chazlambo/Omnimagnet/Code/Tractor Beam/output/calibration_test/frame_4.png

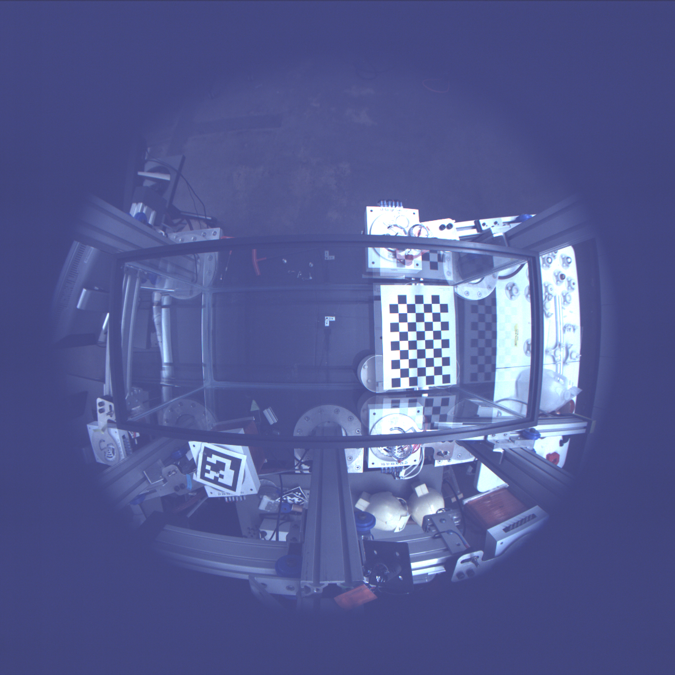
Code/Tractor Beam/output/calibration_test/frame_4.png
