chazlambo/Omnimagnet/Code/Tractor Beam/output/calibration_test/frame_8.png

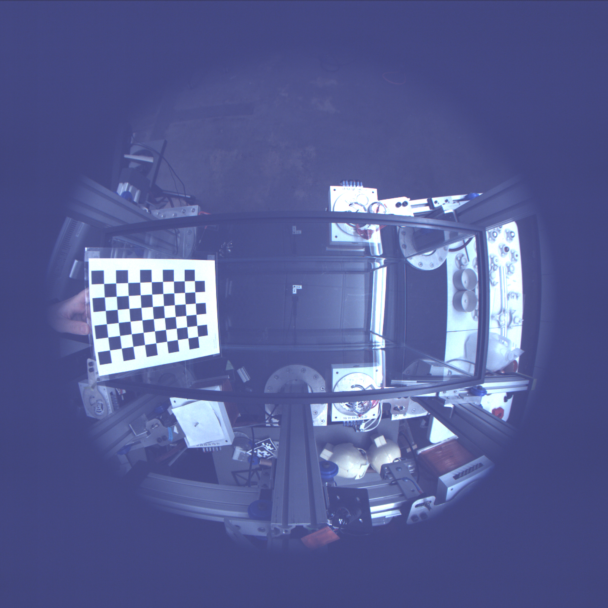
Code/Tractor Beam/output/calibration_test/frame_8.png
