chazlambo/Omnimagnet/Solidworks/Wire Box/Classical Controls - HW3 Full.pdf

•

~M- | l~w 3- P n,htu,,

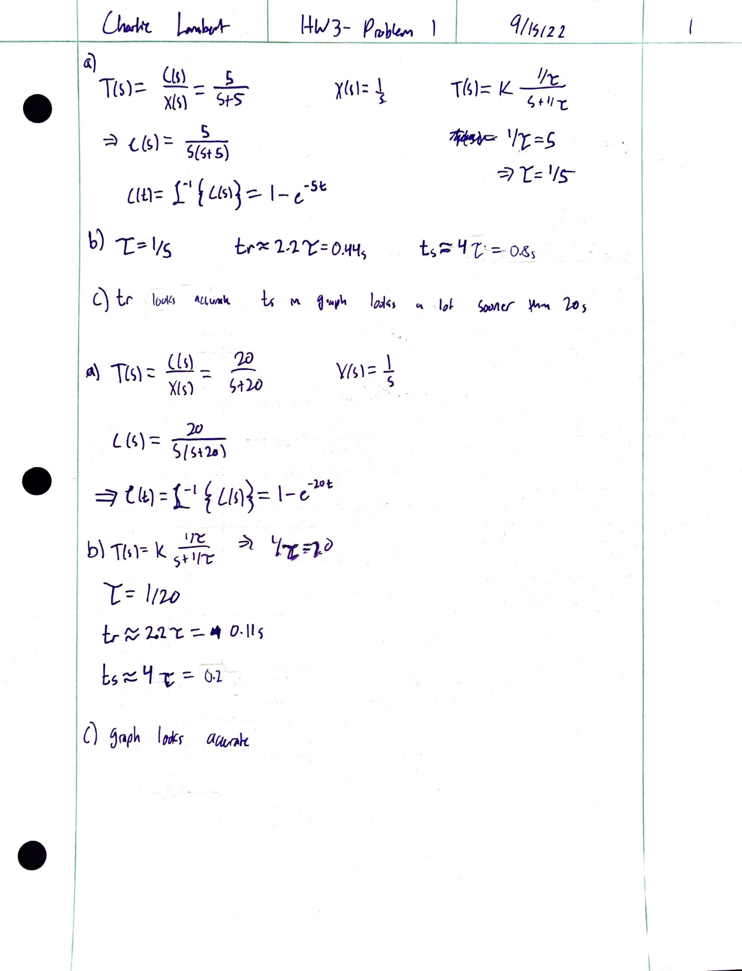
[picture p3: page 1]

•

•

dJ | _ Lls) | s
Tl~) - i) :: St-5 | X(<I= l

ll~) -=- S{tb)

l(l.1-:: f' f Us\)-::.- I - l.-St

b) 1: 1/5 | c"-x 1.i = o.~'is
b\ 1l\)~ k s;1i~ | LL~ ~7);

### 1:= ltio

# vr~,-; l . s

q;,~/2 2.

1(1)== IL I/:

f- / T.,

## l/r=-f>

.;J T= 1
/s-

I

\

•

## A5~v/Ylt:

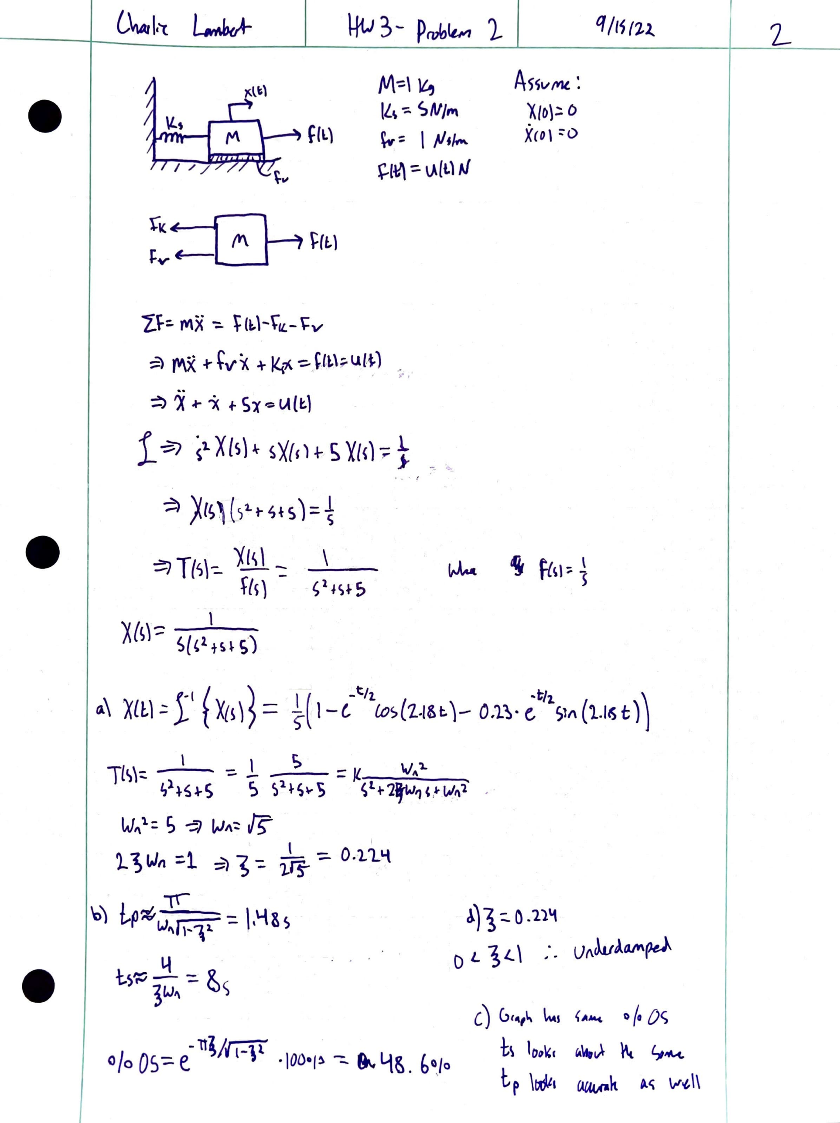
[picture p4: page 2]

•

•

\.fW 3 - p rJ,!t.v, 1 | q /(', {'},J..

f(l)

Z,f-:. rvlX -:::. (1:.\-flL - ~v

M-:;\ it,
IL-.-::. SftlJtrt
I J./t~
~M v\lt.) ,i

::) MX -r tvi + -=-JO.\;.uti) ·;.,

'X ... i f Sx-=tA{t)

## f_~ s1.Xls)"" sX/,)+-~Yl~)-;::~

# )c~, h2.+-4is)=¾

Tls\-:. ):'Jil_-:: -'--
fl~) ~¹ 1Si$

'X{b\.::.O

### Xco\ =o

lo) l,.p~..,:,. ::: \,'-l&s | ~)1=- 0.11'1
QL 3L..\ . u (\Li J..o.ft\pJ,-. . . 4 | . t~'i=i-::. 3w"
CJ G, .. ,~ ~I | { AM.4, | o/a Os
0 /o os-=:. e.-1t~/fi-V, . 100•1~ -:. 9', Lt~. l,a)o | t\ lo""' <-\ft~ \\
l p ,~, ~k ~" \,,r,t\\

q/,s/21

# - 1ls):: \~-,~s

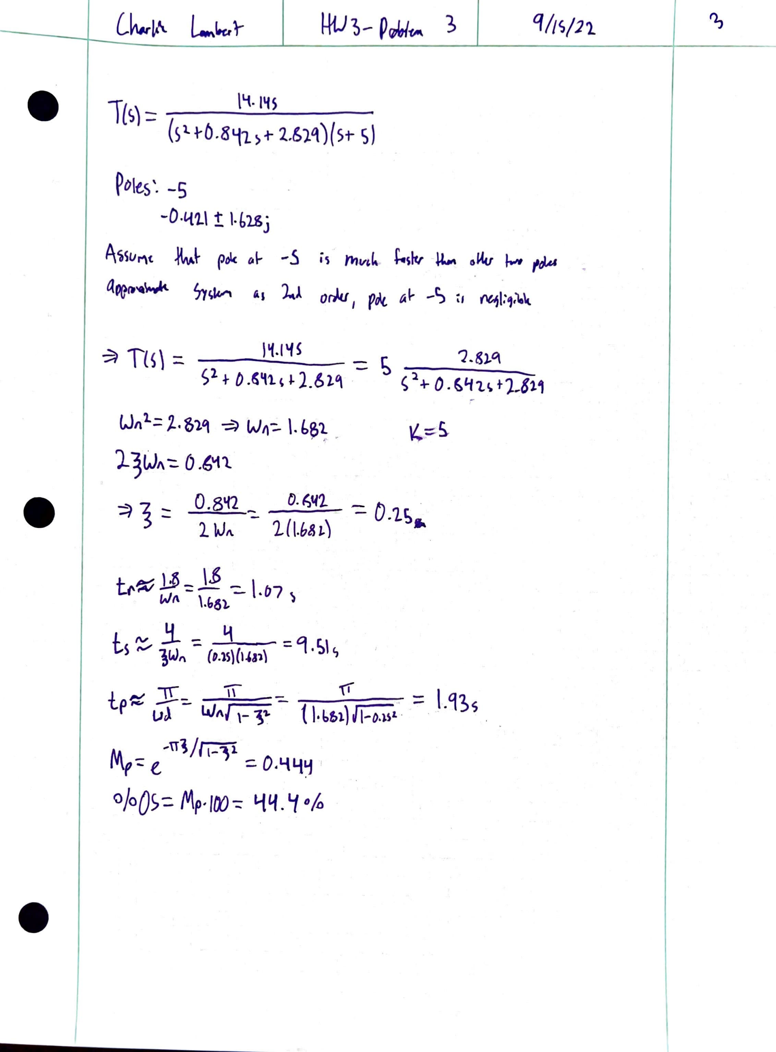
[picture p5: page 3]

## (stt6.8~1>+ 2.6l't)(St- 5)

Pble.s '. -5

### -0-ttt\ ! His j

A.~~111"'\t | ,ltv.~ pok oi. -5 i~ t'tlv,~ ~sit, | oUu- | ,

ttrie,.,.~ S-,~ ,, ~l orkr, ph tAi. -S ,, t"e,jl:1:i.1.c.

## Wn¹

=J..fil.'l :=:>W/\-:..\.l,~~ . | ~ :::: ~
13W"-::. o .~'11.
- _, | - 0. 8'f2 - | o. 1,1.1'1. | 0
-, 3 - l lJI\ - 1(1.b.sz.) -:: .
1;._
l rv | - | L\ | - 4 SI S t-./ JW" - (us)(1"a1\ - · "
-n- | " | \a t.p~ er=- WAJ ,- ,,. -=- { l•b6i)J1-o.i~~·. = ·. l~S .
M. | ,U1/l,--,1 l''f-= l | :::: 0,LtL{~

0 /oOS-= Mp -/riJ-= &.-('LL[ ⁰ /4
•

•

t,('.:: 0.03 ::- 2.17:::

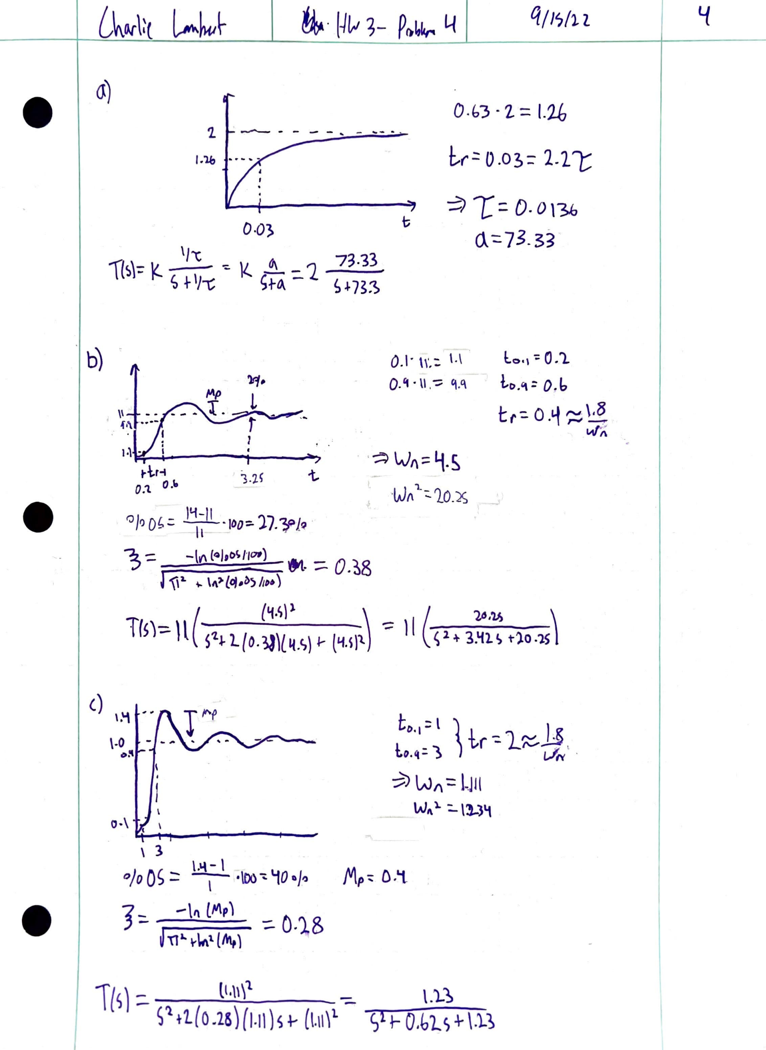
[picture p6: page 4]

b)
•

•

2. -- - - - - - - ~- •

O.f,3 · 2=1.U

0-03>
' J--c | 73,33
1}>\'= \l. ~} 'J--c K | -=..1 .q~~

\\ . .f•\ •

J,l • i
1-\.r-1
0.1. O.lo

/A

0 /oo~ :: l~~ll ·100 ::. 17.";fl?

3 :::: -l(I (4J,0H10,) | ~ - :::. 0 -18
f 'fi i. | \I\> £oj.b:, /11•)

I

I
0•\ I

t

T = 0 -D\3,6

### ct_ ::: 7~_33

O. 1 • ,,·.:. \.\ | lo,, -== 0. 'l.
0.'1 · \1 ,-::;; Cl,(\ | Lo ."1 = o.b

## tr ~ o.~

v,/'f.

t0•1== l) | - · r,.,~

### lo,tt= 1 ) tr -l""' t.-1,v' ·

## -:3> W" ::: l.JJI

W" l. :.. \3-3'1

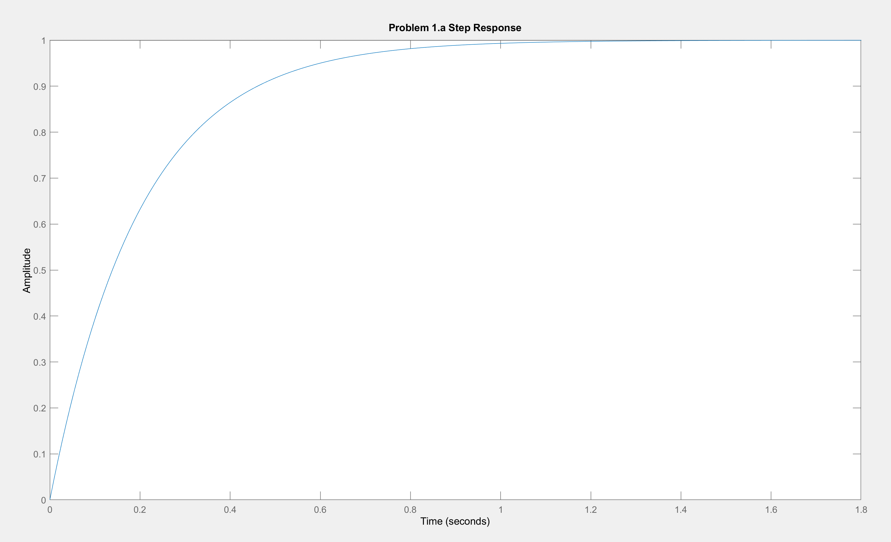
[picture p7: page 5]
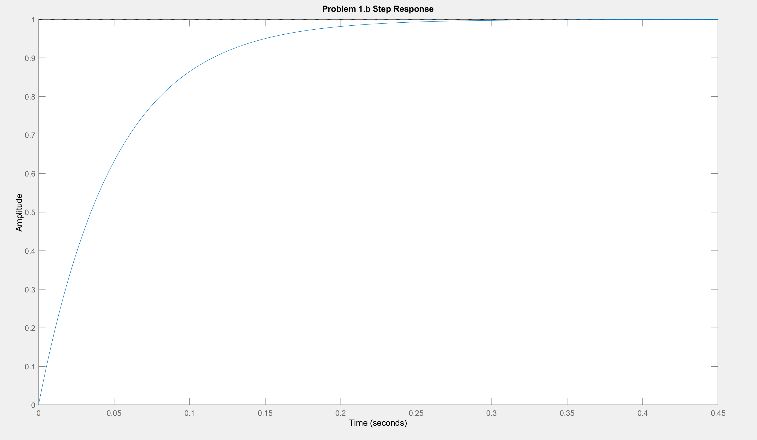
[picture p8: page 6]
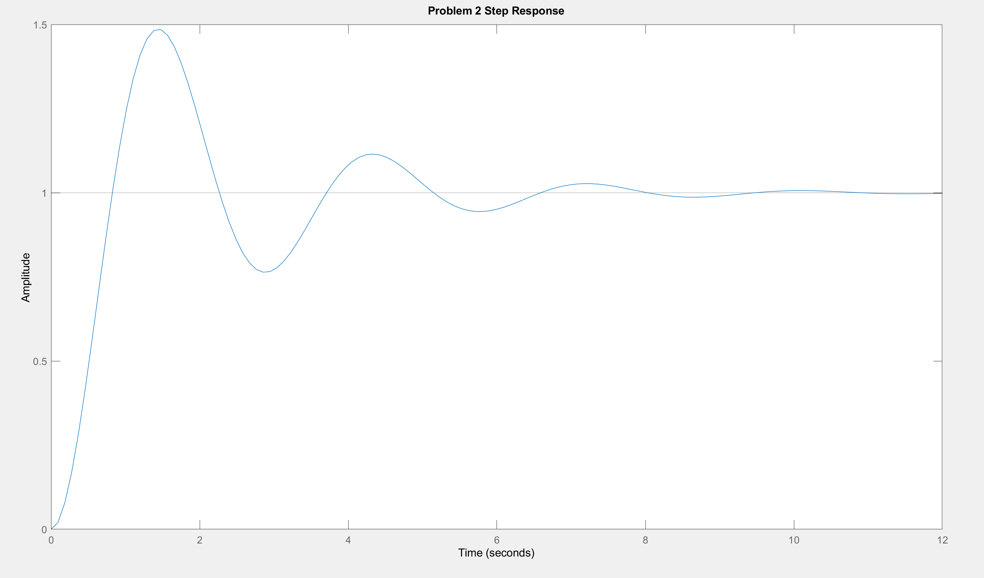
[picture p9: page 7]
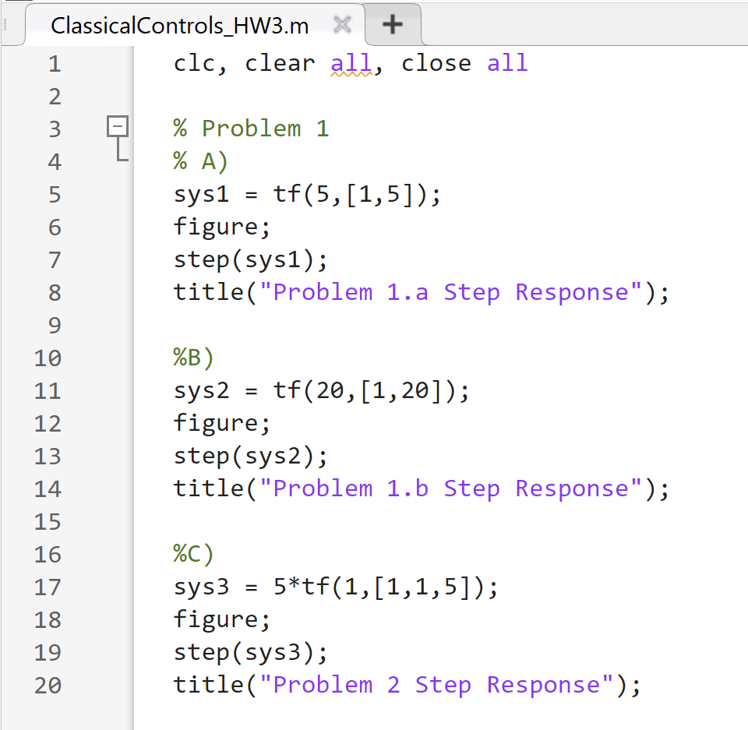
[picture p10: page 8]
