chazlambo/Omnimagnet/Documentation/Forward Kinematics/Arm to Table Axes.jpg

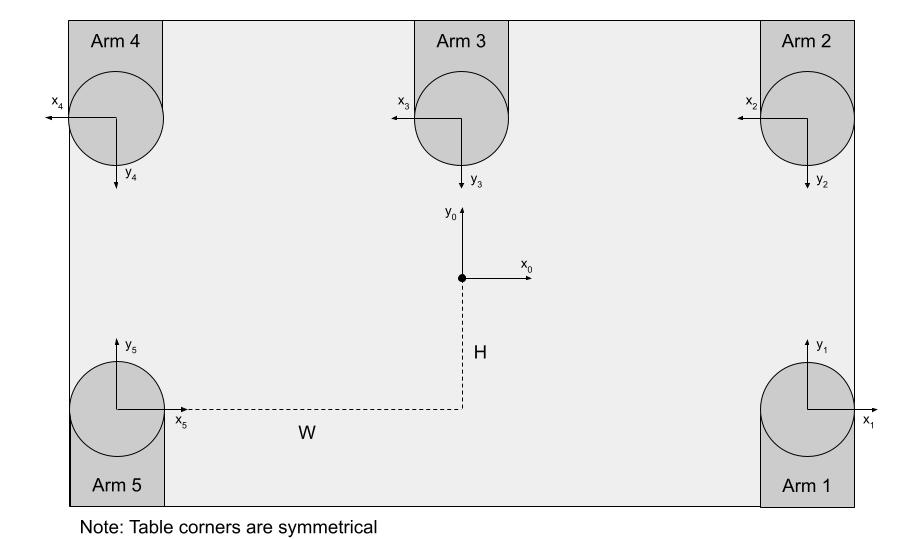
Documentation/Forward Kinematics/Arm to Table Axes.jpg
