chazlambo/Omnimagnet/Documentation/Forward Kinematics/Omnimagnet Arm DH Parameters.jpg

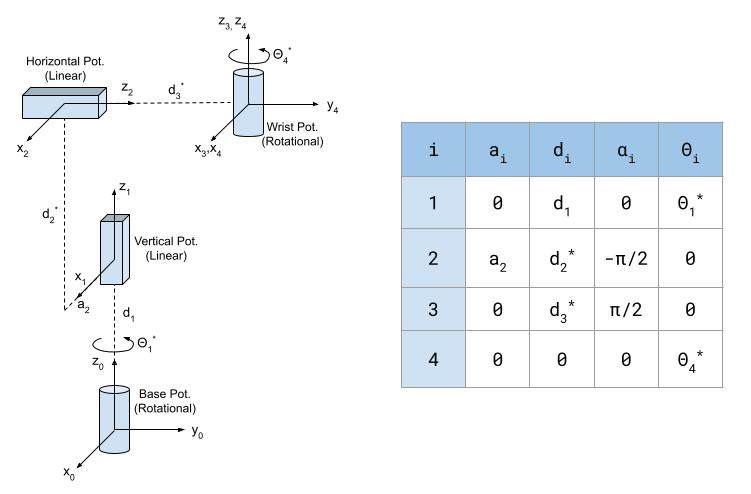
Documentation/Forward Kinematics/Omnimagnet Arm DH Parameters.jpg
