chazlambo/Omnimagnet/Documentation/Wiring-Pin Tables/I2C Bus Overview.jpg

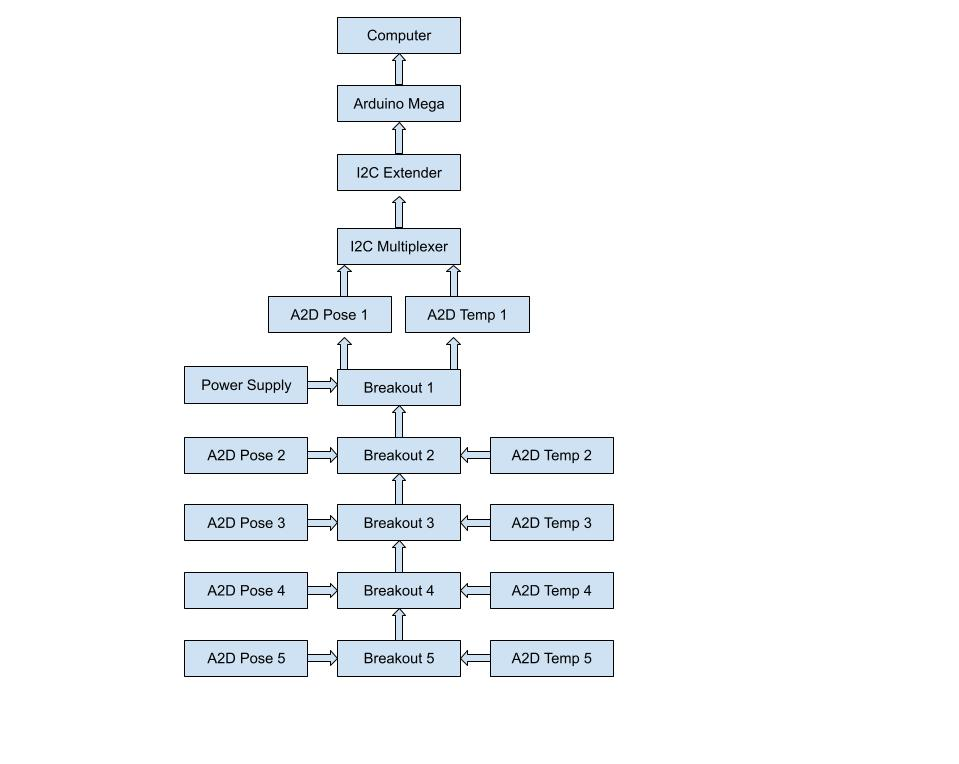
Documentation/Wiring-Pin Tables/I2C Bus Overview.jpg
