chazlambo/Omnimagnet/Documentation/Hardware/Parts List.xlsx

Boards
Part | Model
Microcontroller | Arduino Mega
I2C Extender | Adafruit LTC4311
I2C Multiplexer | Adafruit TCA9548A
A2D Module | Adafruit PCF8591
Breakout Board | MDFLY RJ45
Dual Breakout Board | MDFLY DUAL RJ45
Parts
Potentiometer Timing Pulley | https://www.robotshop.com/en/makeblock-32-tooth-timing-pulleys-2pk.html | 2
Omnimagnet Timing Pulley | https://www.mcmaster.com/1375K21/ | 3
Timing Belt | https://www.mcmaster.com/7887K214/ | 2
