chazlambo/Omnimagnet/Solidworks/Tank Setup/Aligner Assembly.SLDASM

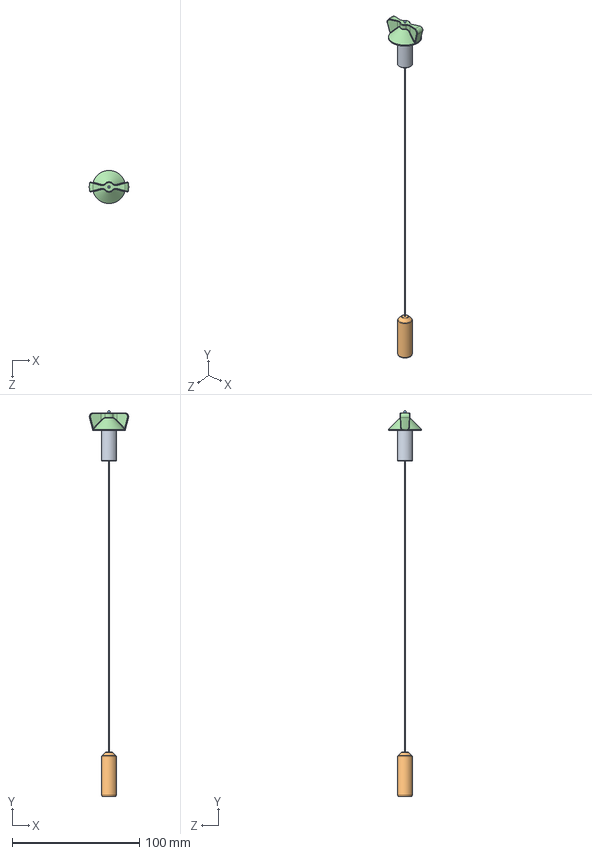
[picture p14: CAD file, 2025-10-20]
Solidworks/Tank Setup/Aligner Assembly.SLDASM
31.1 x 303.9 x 26.0 mm
Raft Aligner Top Peg
Aligner String
Raft Aligner Bottom Peg
Raft Aligner Middle Peg
