chazlambo/Omnimagnet/Solidworks/Tank Setup/Tank Full Setup.SLDASM

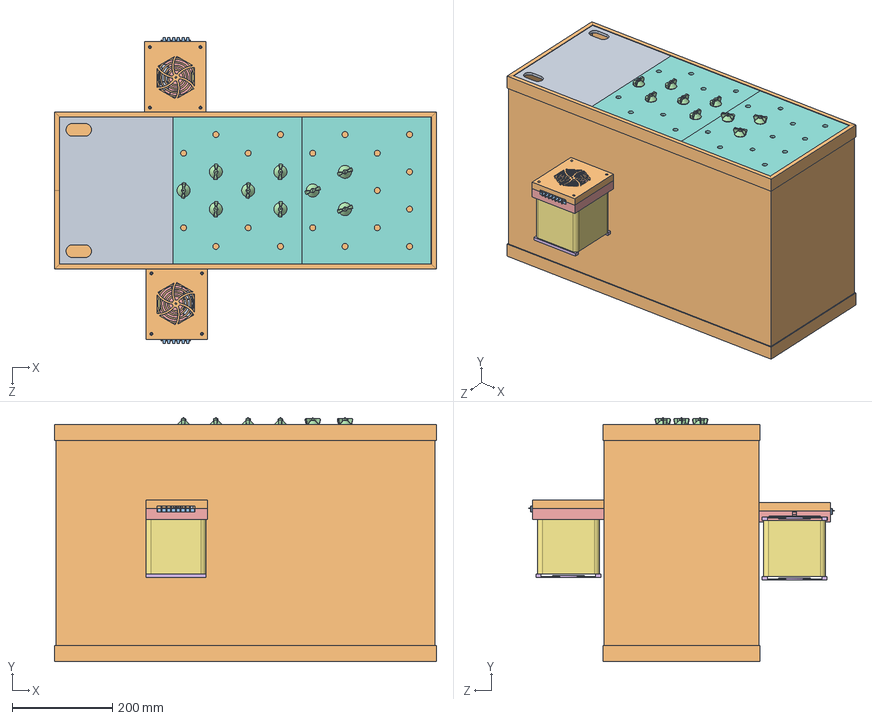
[picture p15: CAD file, 2025-10-20]
Solidworks/Tank Setup/Tank Full Setup.SLDASM
763.1 x 487.9 x 611.8 mm
Water Tank
Acrylic Cover - Left
Acrylic Cover - Middle
Universal Raft x 3
Raft Ball Holder x 3
Ball x 3
Raft Aligner Top Peg x 9
Aligner String x 9
Raft Aligner Bottom Peg x 9
Raft Aligner Middle Peg x 9
Acrylic Cover - Right
Magnet x 2
Bracket x 4
Bottom Box x 2
Port x 2
Power Port x 2
Top Box x 2
Amp x 6
