chazlambo/Omnimagnet/Solidworks/Wire Box/Assembly.SLDASM

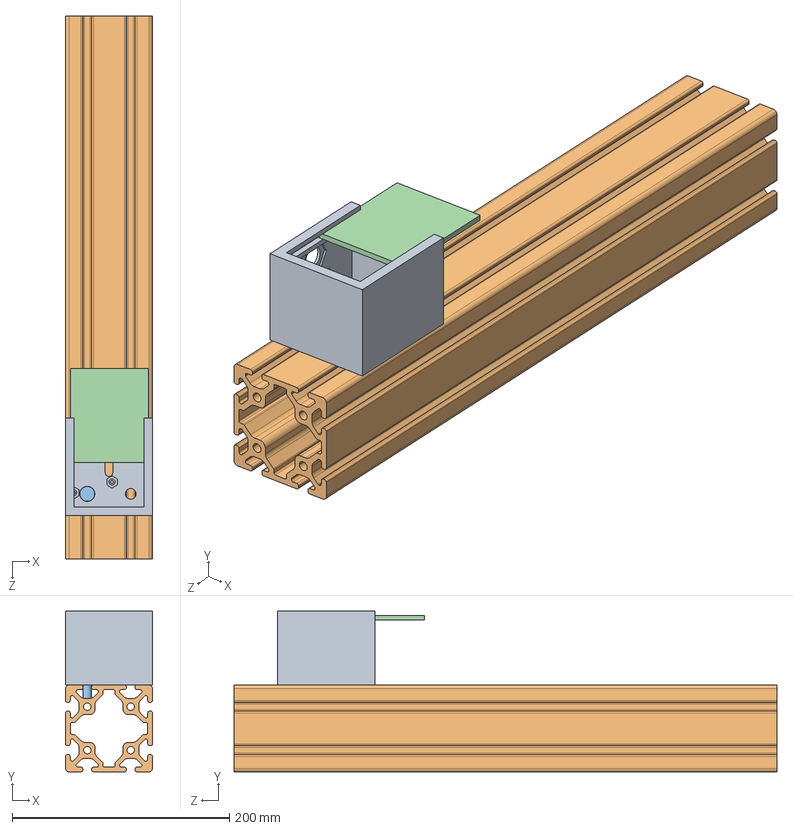
[picture p16: CAD file, 2025-04-09]
Solidworks/Wire Box/Assembly.SLDASM
80.0 x 148.0 x 500.0 mm
Wire Box
Frame
Screw x 2
Sliding Door
