chazlambo/Omnimagnet/Solidworks/Master Box/Assembly.SLDASM

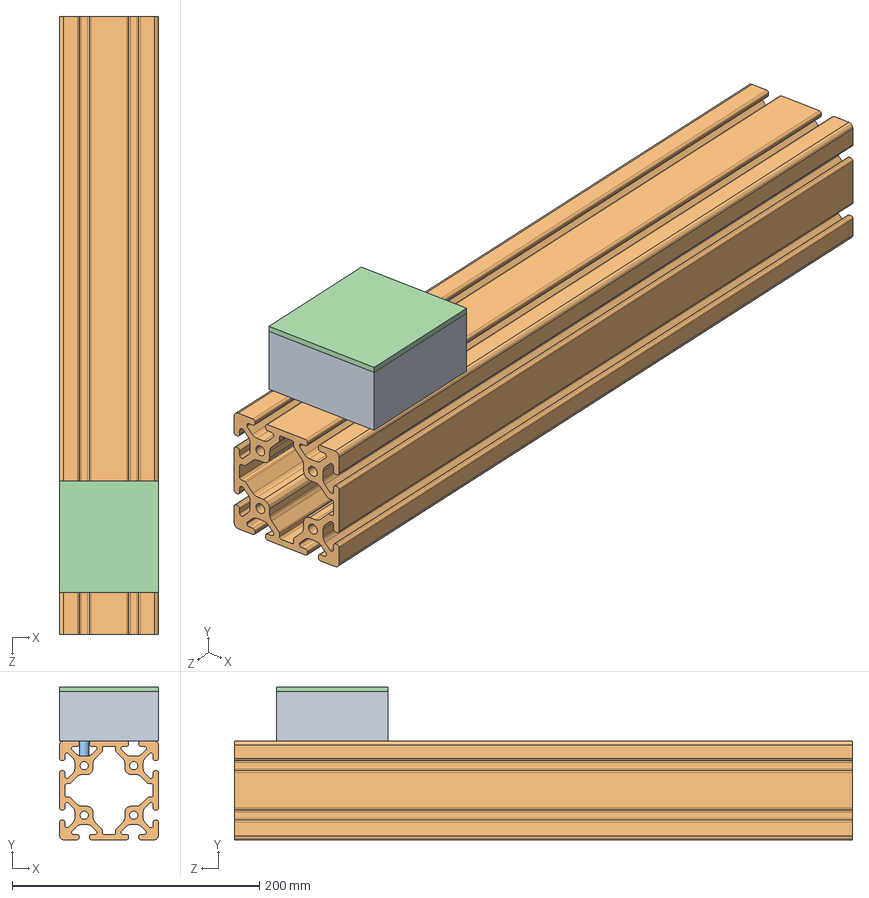
[picture p17: CAD file, 2025-04-09]
Solidworks/Master Box/Assembly.SLDASM
80.0 x 123.5 x 500.0 mm
Circuit Box
Frame
Screw x 2
Lid
