chazlambo/Omnimagnet/Solidworks/Omni Arduino Box/Omni Arduino Box Assembly.SLDASM

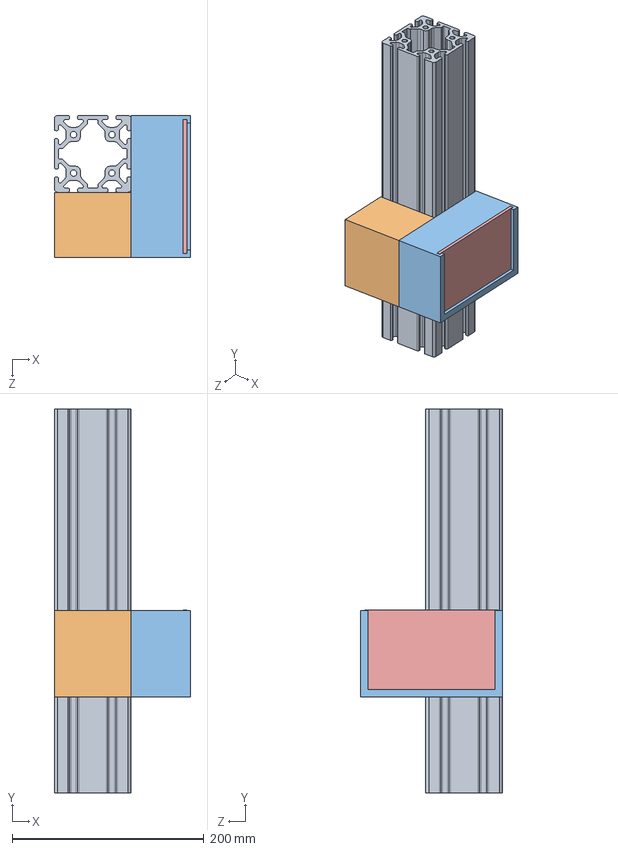
[picture p18: CAD file, 2025-04-09]
Solidworks/Omni Arduino Box/Omni Arduino Box Assembly.SLDASM
142.0 x 400.0 x 148.0 mm
40_8080_400_CL2
Old Wirebox
Arduino Box
ArduinoMega
Arduino Box Slide
