chazlambo/Omnimagnet/Solidworks/Omnimagnet Box/Omnimagnet Assembly.SLDASM

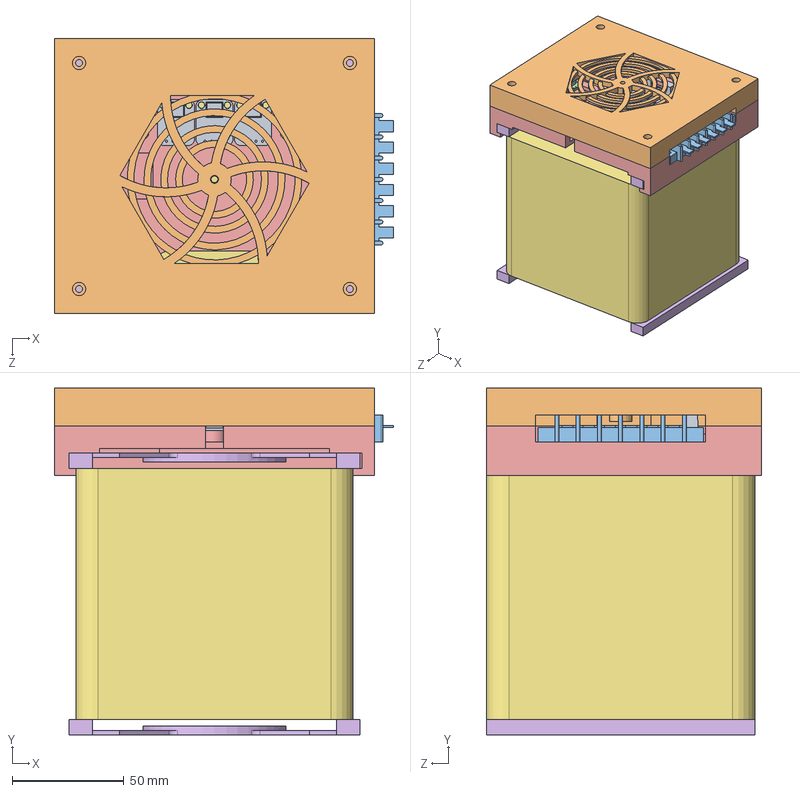
[picture p19: CAD file, 2025-07-17]
Solidworks/Omnimagnet Box/Omnimagnet Assembly.SLDASM
151.5 x 155.0 x 123.0 mm
Magnet
Bracket x 2
Bottom Box
Port
Power Port
Top Box
Amp x 3
