chazlambo/Omnimagnet/Solidworks/Tank Setup/Raft Assembly.SLDASM

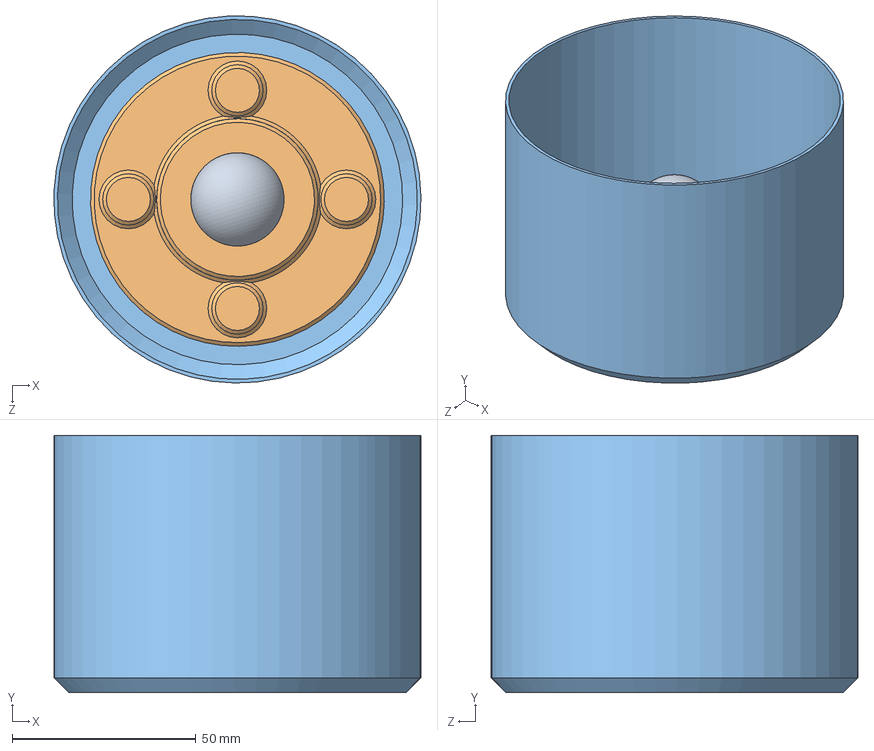
[picture p20: CAD file, 2025-07-17]
Solidworks/Tank Setup/Raft Assembly.SLDASM
99.9 x 70.0 x 99.9 mm
Universal Raft
Raft Ball Holder
Ball
