chazlambo/Omnimagnet/Solidworks/Master Box/Master Box 2.SLDPRT

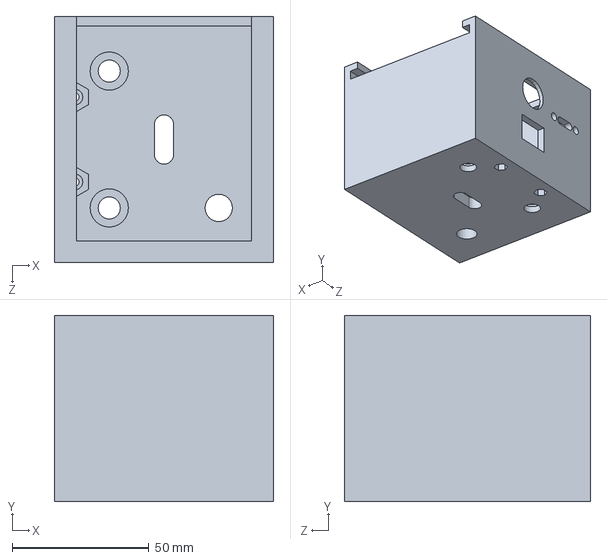
[picture p21: CAD file, 2025-04-09]
Solidworks/Master Box/Master Box 2.SLDPRT
80.0 x 68.0 x 90.0 mm
