chazlambo/Omnimagnet/Solidworks/Omni Arduino Box/40_8080_400_CL2.SLDPRT

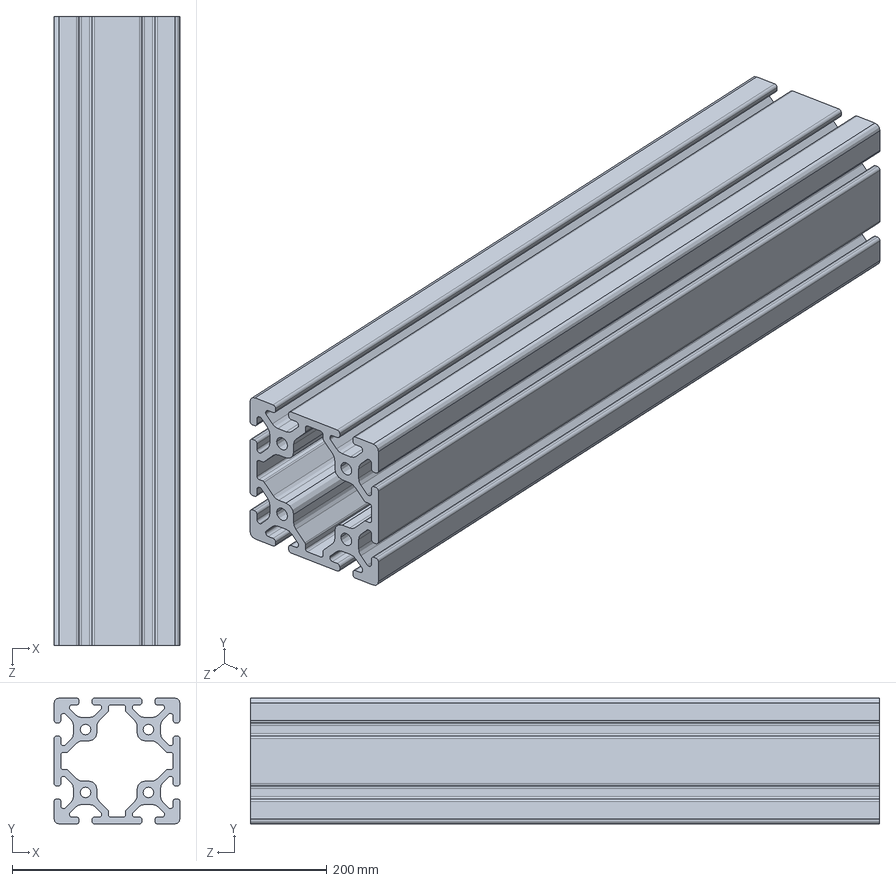
[picture p22: CAD file, 2025-04-09]
Solidworks/Omni Arduino Box/40_8080_400_CL2.SLDPRT
80.0 x 80.0 x 400.0 mm
