chazlambo/Omnimagnet/Solidworks/Omnimagnet Box/Amp.SLDPRT

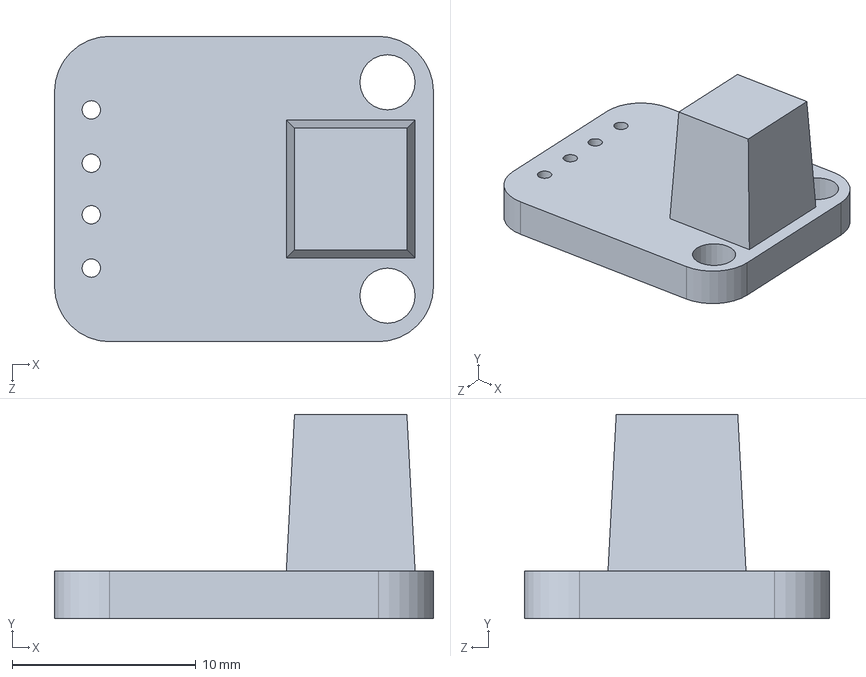
[picture p23: CAD file, 2025-07-17]
Solidworks/Omnimagnet Box/Amp.SLDPRT
20.6 x 11.1 x 16.6 mm
