chazlambo/Omnimagnet/Solidworks/Tank Setup/STLs/Raft Print.3mf

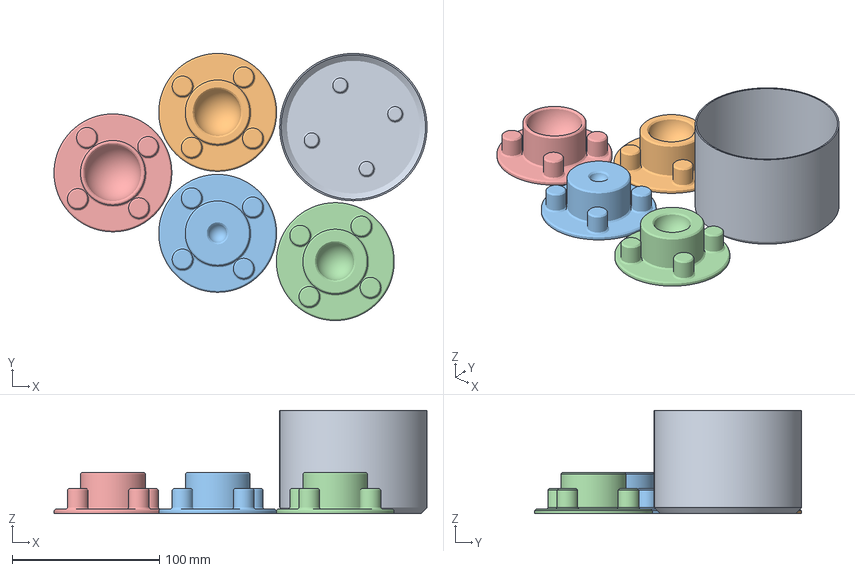
[picture p24: CAD file, 2025-07-17]
Solidworks/Tank Setup/STLs/Raft Print.3mf
253.3 x 181.3 x 70.0 mm
Universal Raft.STL
Raft Ball Holder (1.25in).STL
Raft Ball Holder (0.5in).STL
Raft Ball Holder (1 in).STL
Raft Ball Holder (1.5in).STL
