chazlambo/Omnimagnet/Solidworks/Master Box/Frame.sldprt

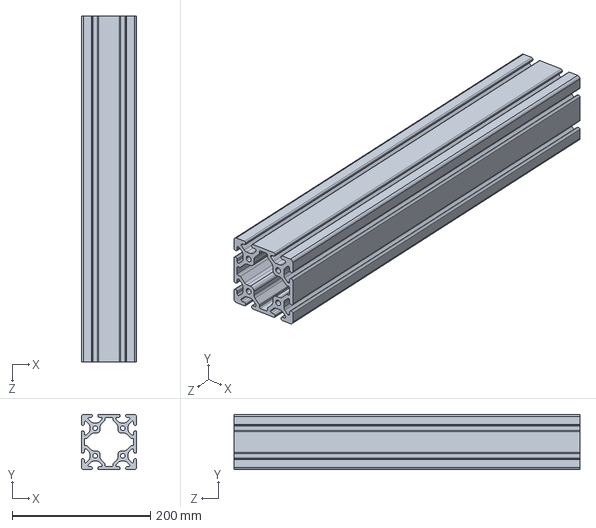
[picture p25: CAD file, 2025-04-09]
Solidworks/Master Box/Frame.sldprt
80.0 x 80.0 x 500.0 mm
