chazlambo/Omnimagnet/Solidworks/Omni Arduino Box/Arduino Box Slide.SLDPRT

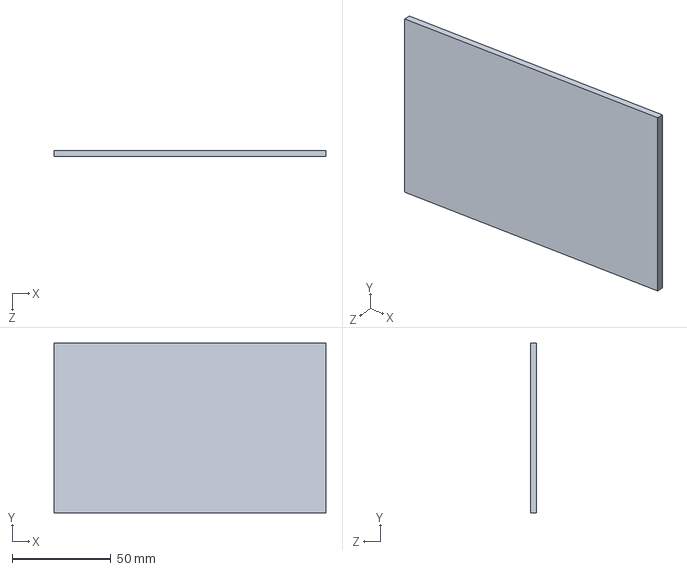
[picture p26: CAD file, 2025-04-09]
Solidworks/Omni Arduino Box/Arduino Box Slide.SLDPRT
138.0 x 86.0 x 3.20 mm
