chazlambo/Omnimagnet/Solidworks/Omnimagnet Box/Power Port.SLDPRT

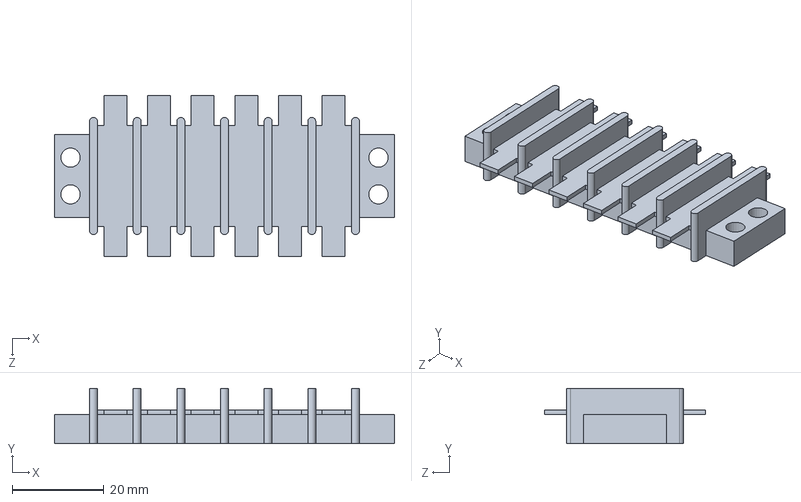
[picture p27: CAD file, 2025-07-17]
Solidworks/Omnimagnet Box/Power Port.SLDPRT
74.0 x 12.0 x 35.0 mm
