chazlambo/Omnimagnet/Solidworks/Omnimagnet Box/Bracket.SLDPRT

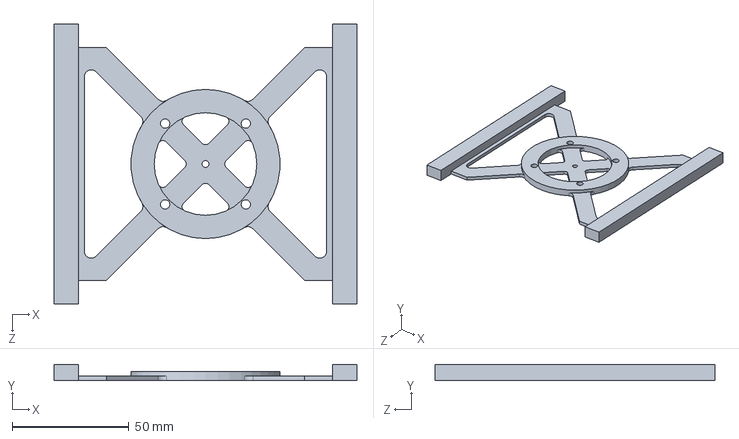
[picture p28: CAD file, 2025-07-17]
Solidworks/Omnimagnet Box/Bracket.SLDPRT
130.0 x 7.00 x 120.0 mm
