chazlambo/Omnimagnet/Solidworks/Tank Setup/Raft Aligner Spacer.SLDPRT

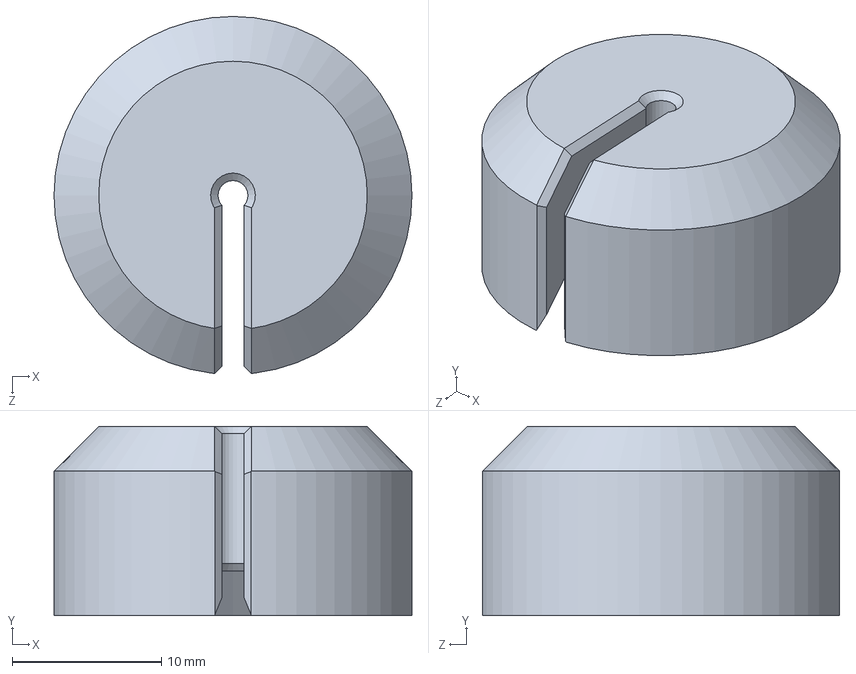
[picture p29: CAD file, 2025-10-14]
Solidworks/Tank Setup/Raft Aligner Spacer.SLDPRT
24.0 x 12.7 x 23.9 mm
