chazlambo/Omnimagnet/Solidworks/Wire Box/Sliding Door.SLDPRT

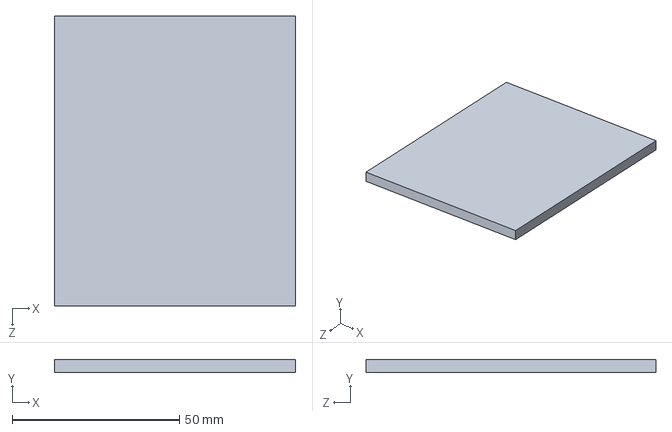
[picture p30: CAD file, 2025-04-09]
Solidworks/Wire Box/Sliding Door.SLDPRT
72.0 x 4.00 x 86.5 mm
