chazlambo/Omnimagnet/Solidworks/Master Box/Master Box.SLDPRT

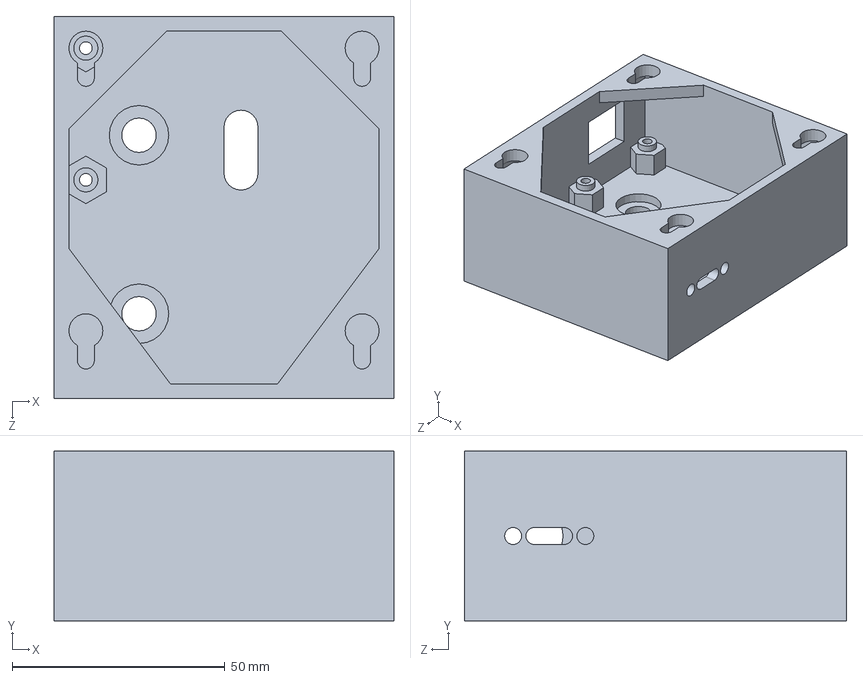
[picture p31: CAD file, 2025-04-09]
Solidworks/Master Box/Master Box.SLDPRT
80.0 x 40.0 x 90.0 mm
