chazlambo/Omnimagnet/Solidworks/Omni Arduino Box/ArduinoMega.SLDPRT

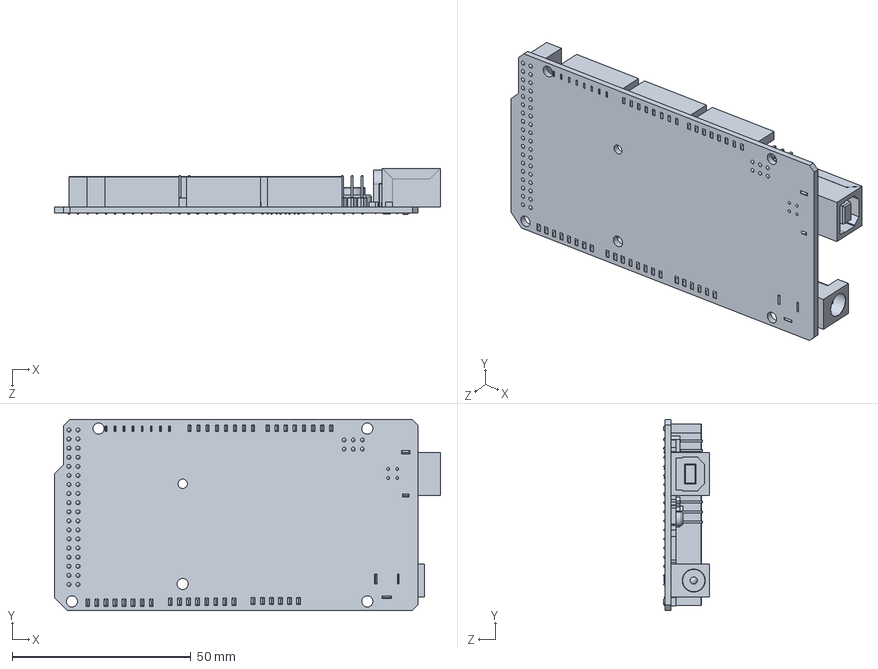
[picture p32: CAD file, 2025-04-09]
Solidworks/Omni Arduino Box/ArduinoMega.SLDPRT
107.9 x 53.4 x 13.0 mm
