chazlambo/Omnimagnet/Solidworks/Omnimagnet Box/Magnet.SLDPRT

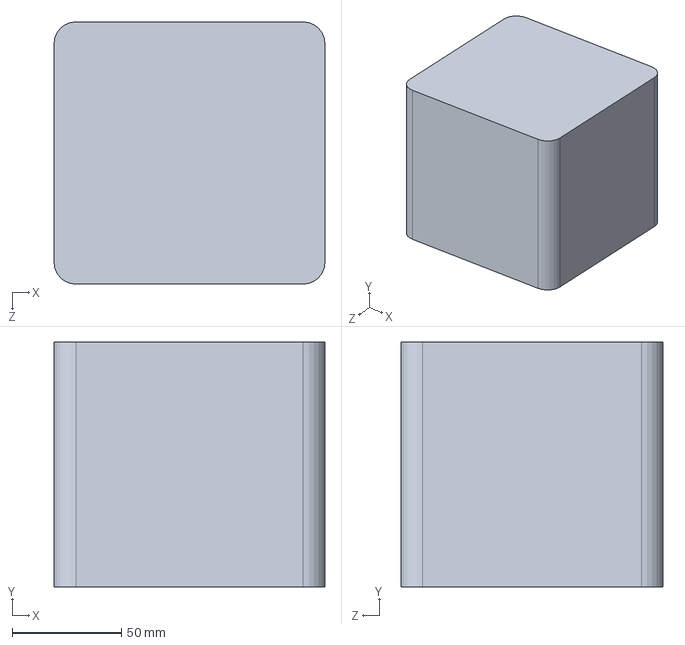
[picture p33: CAD file, 2025-07-17]
Solidworks/Omnimagnet Box/Magnet.SLDPRT
124.0 x 112.0 x 120.0 mm
