chazlambo/Omnimagnet/Solidworks/Tank Setup/Raft Aligner Bottom Peg.SLDPRT

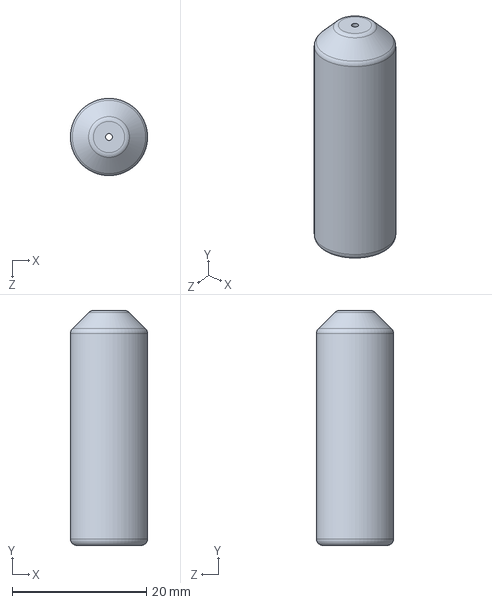
[picture p34: CAD file, 2025-09-15]
Solidworks/Tank Setup/Raft Aligner Bottom Peg.SLDPRT
11.5 x 35.0 x 11.5 mm
