chazlambo/Omnimagnet/Solidworks/Wire Box/Wire Box.SLDPRT

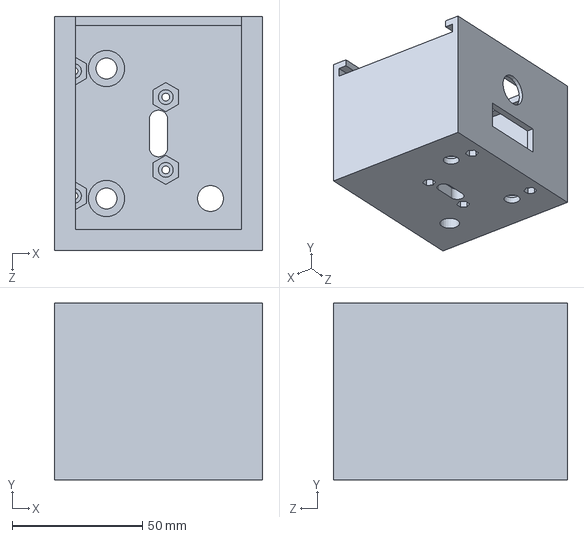
[picture p35: CAD file, 2025-04-09]
Solidworks/Wire Box/Wire Box.SLDPRT
80.0 x 68.0 x 90.0 mm
