chazlambo/Omnimagnet/Solidworks/Tank Setup/Acrylic Cover - Right.SLDPRT

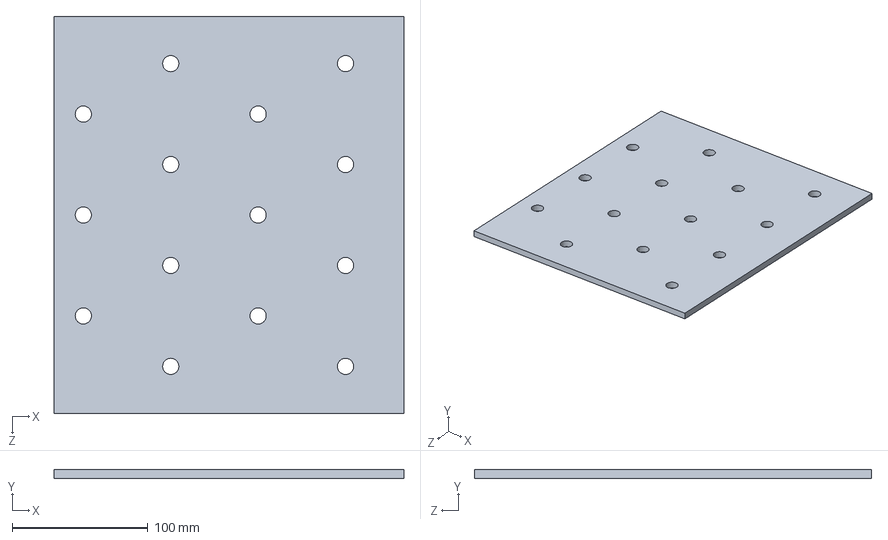
[picture p36: CAD file, 2025-09-15]
Solidworks/Tank Setup/Acrylic Cover - Right.SLDPRT
258.0 x 6.35 x 293.0 mm
