chazlambo/Omnimagnet/Solidworks/Master Box/Lid.SLDPRT

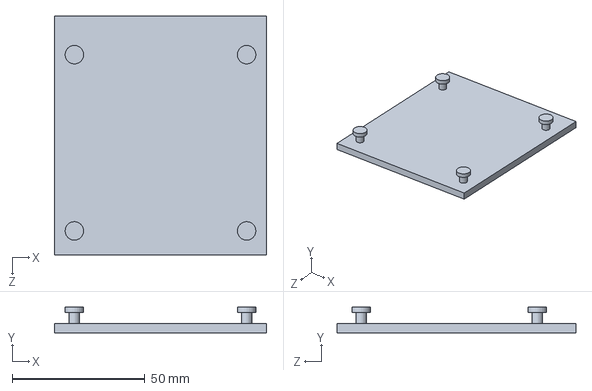
[picture p37: CAD file, 2025-04-09]
Solidworks/Master Box/Lid.SLDPRT
80.0 x 9.70 x 90.0 mm
