chazlambo/Omnimagnet/Solidworks/Omni Arduino Box/Arduino Box.SLDPRT

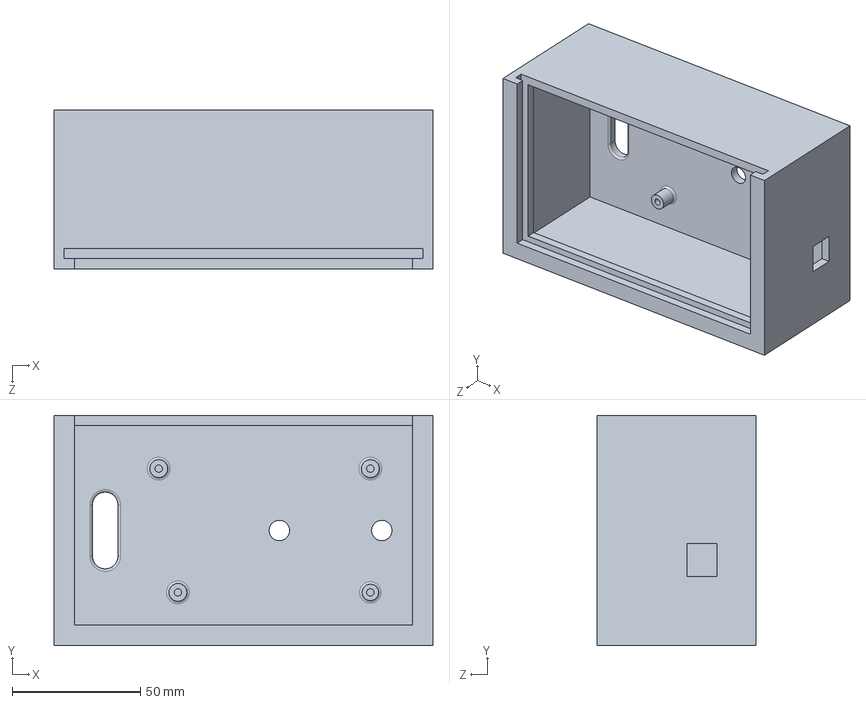
[picture p38: CAD file, 2025-04-09]
Solidworks/Omni Arduino Box/Arduino Box.SLDPRT
148.0 x 90.0 x 62.0 mm
