chazlambo/Omnimagnet/Solidworks/Omnimagnet Box/Top Box.SLDPRT

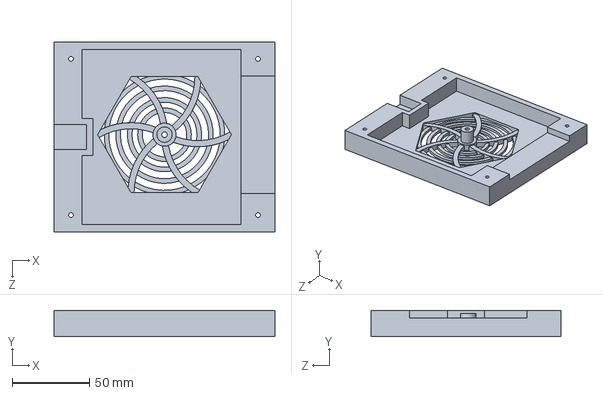
[picture p39: CAD file, 2025-07-17]
Solidworks/Omnimagnet Box/Top Box.SLDPRT
143.0 x 17.0 x 123.0 mm
