chazlambo/Omnimagnet/Solidworks/Omnimagnet Box/Bottom Box.SLDPRT

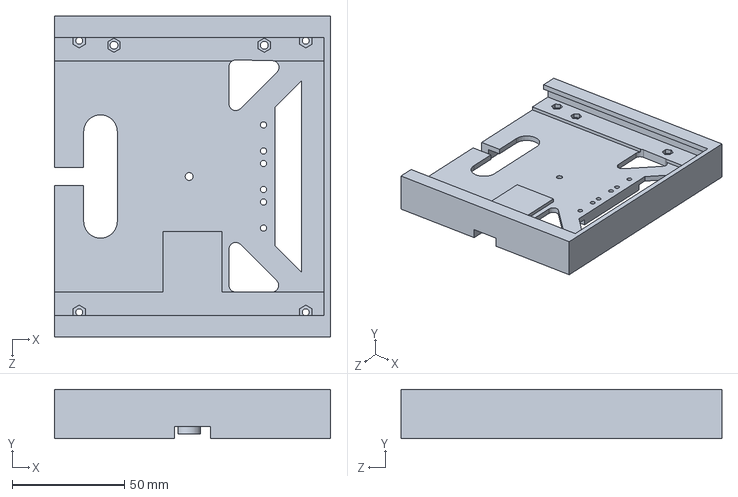
[picture p40: CAD file, 2025-07-17]
Solidworks/Omnimagnet Box/Bottom Box.SLDPRT
123.0 x 22.0 x 143.0 mm
