chazlambo/Omnimagnet/Solidworks/Tank Setup/Raft Aligner Middle Peg.SLDPRT

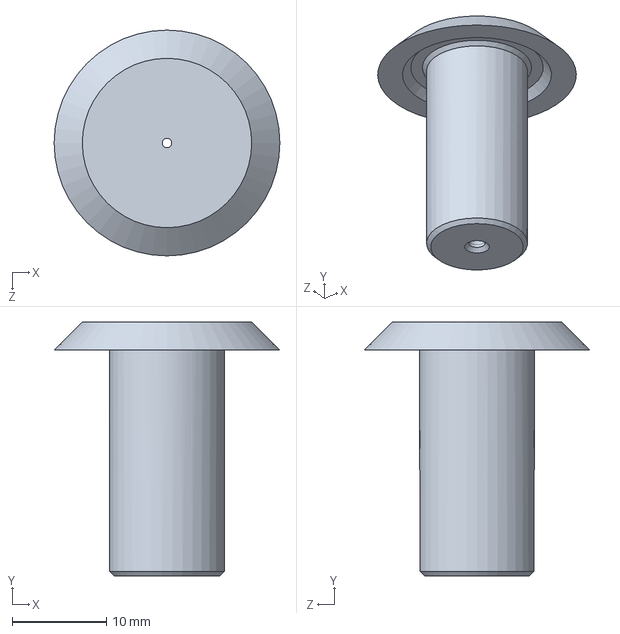
[picture p41: CAD file, 2025-09-15]
Solidworks/Tank Setup/Raft Aligner Middle Peg.SLDPRT
24.0 x 27.0 x 24.0 mm
