chazlambo/Omnimagnet/Solidworks/Omnimagnet Box/Port.SLDPRT

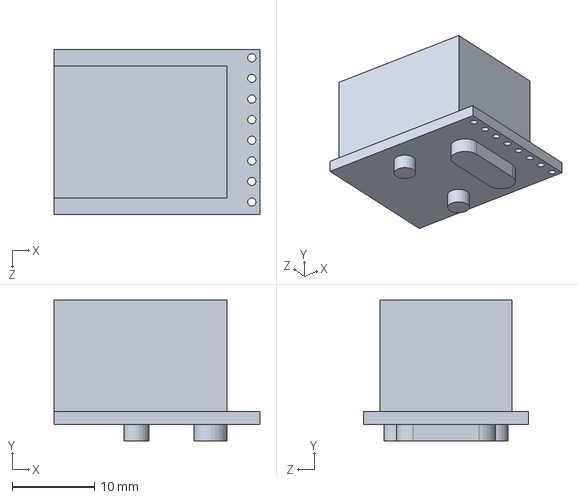
[picture p42: CAD file, 2025-07-17]
Solidworks/Omnimagnet Box/Port.SLDPRT
25.0 x 17.1 x 20.0 mm
