chazlambo/Omnimagnet/Solidworks/Tank Setup/Acrylic Cover - Left.SLDPRT

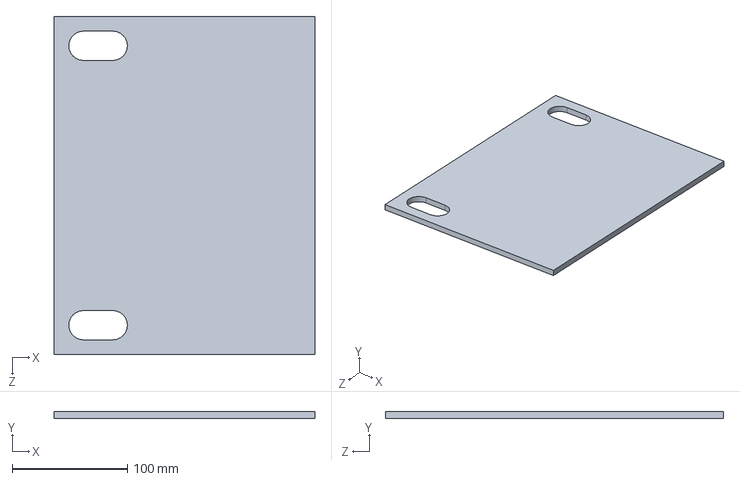
[picture p43: CAD file, 2025-09-15]
Solidworks/Tank Setup/Acrylic Cover - Left.SLDPRT
226.0 x 6.35 x 293.0 mm
