chazlambo/Omnimagnet/Solidworks/Tank Setup/Raft Aligner Top Peg.SLDPRT

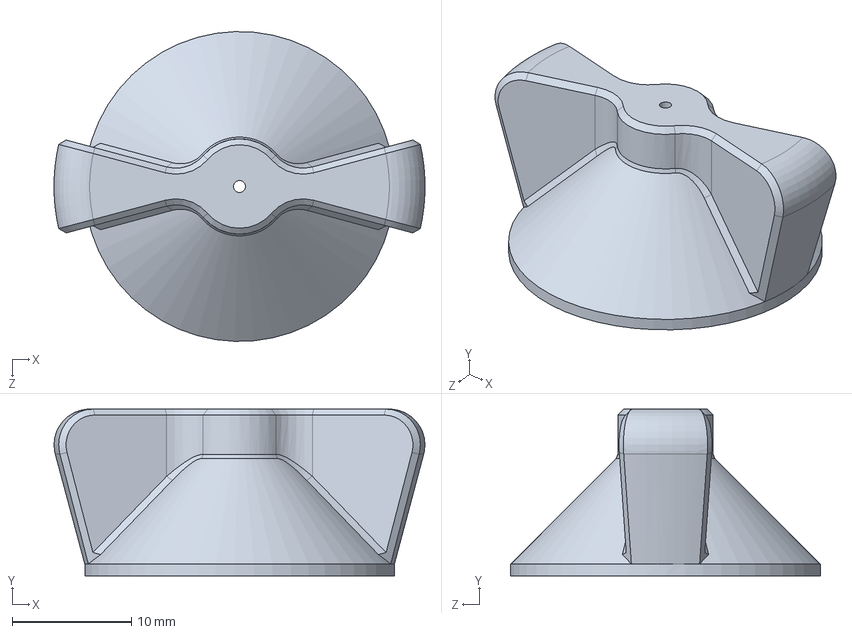
[picture p44: CAD file, 2025-09-15]
Solidworks/Tank Setup/Raft Aligner Top Peg.SLDPRT
31.1 x 14.0 x 26.0 mm
