chazlambo/Omnimagnet/Solidworks/Tank Setup/Raft Ball Holder.SLDPRT

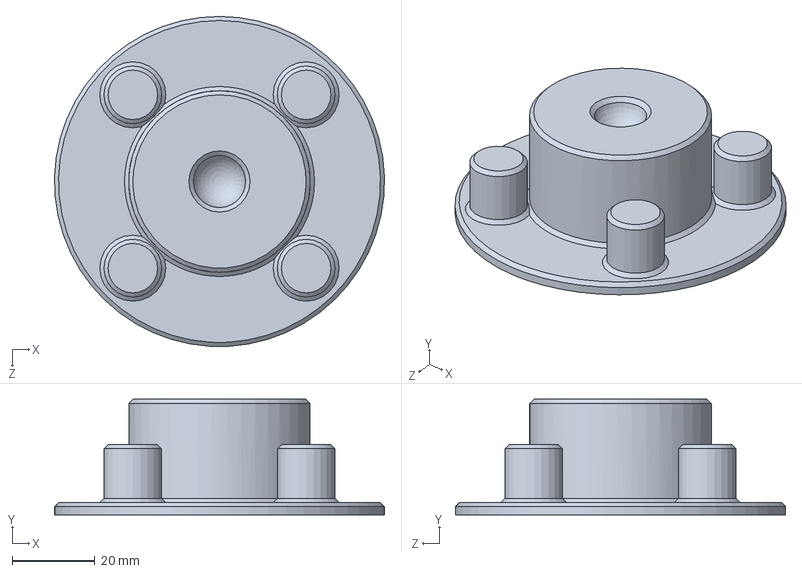
[picture p45: CAD file, 2025-07-17]
Solidworks/Tank Setup/Raft Ball Holder.SLDPRT
80.0 x 28.0 x 80.0 mm
