chazlambo/Omnimagnet/Solidworks/Tank Setup/Water Tank.SLDPRT

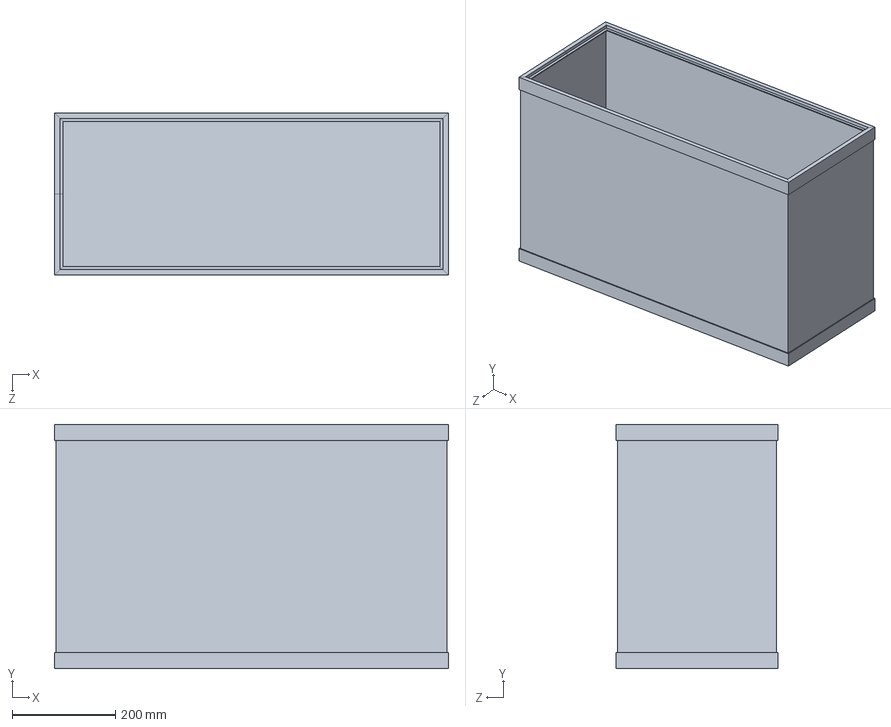
[picture p46: CAD file, 2025-07-17]
Solidworks/Tank Setup/Water Tank.SLDPRT
763.1 x 473.3 x 313.9 mm
