chazlambo/Omnimagnet/Solidworks/Tank Setup/Universal Raft.SLDPRT

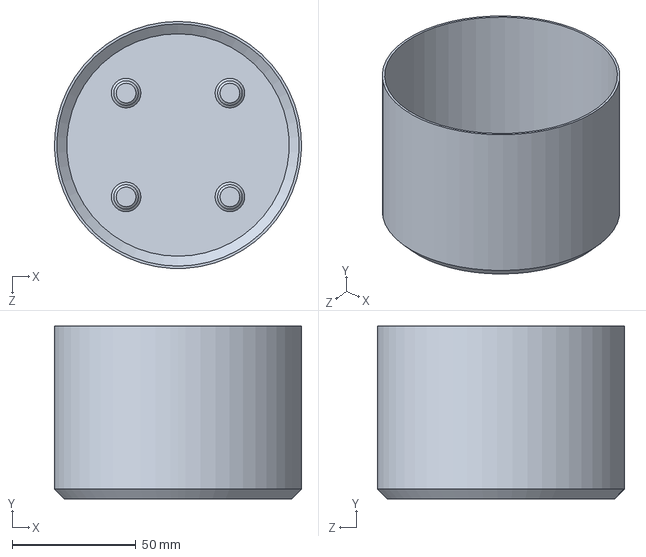
[picture p47: CAD file, 2025-07-17]
Solidworks/Tank Setup/Universal Raft.SLDPRT
100.0 x 70.0 x 100.0 mm
