chazlambo/Omnimagnet/Solidworks/Tank Setup/Ball.SLDPRT

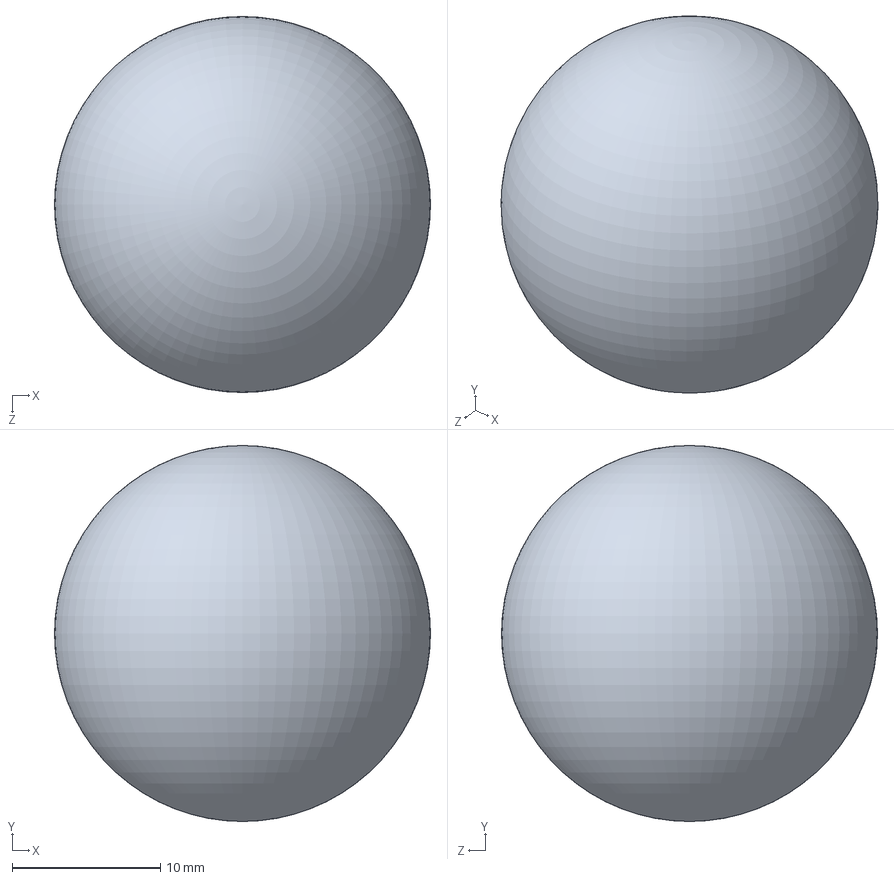
[picture p48: CAD file, 2025-07-17]
Solidworks/Tank Setup/Ball.SLDPRT
25.4 x 25.4 x 25.4 mm
