chazlambo/Omnimagnet/Solidworks/Tank Setup/Aligner Grouper.SLDPRT

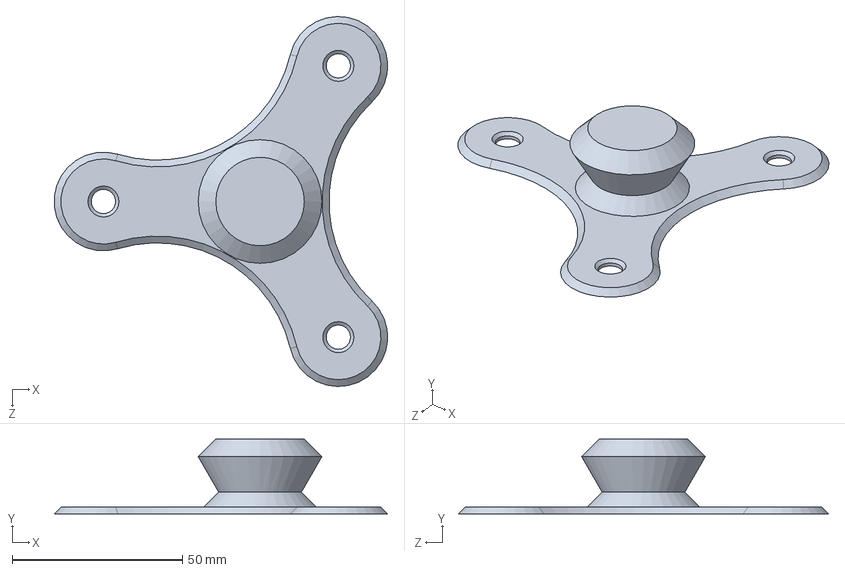
[picture p49: CAD file, 2025-07-17]
Solidworks/Tank Setup/Aligner Grouper.SLDPRT
97.9 x 22.0 x 108.7 mm
