chazlambo/Omnimagnet/Solidworks/Tank Setup/Corner Holder.SLDPRT

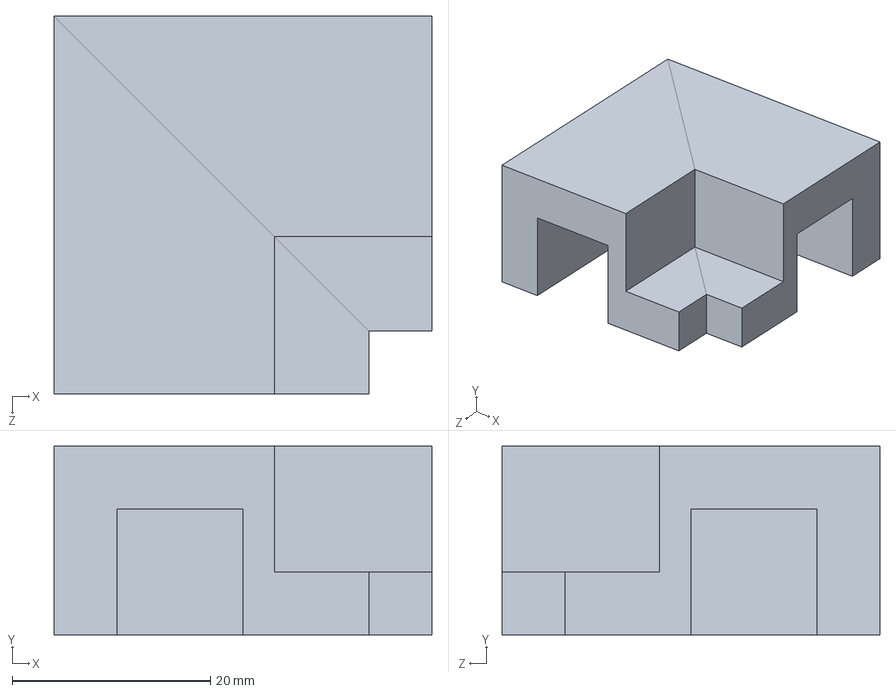
[picture p50: CAD file, 2025-07-17]
Solidworks/Tank Setup/Corner Holder.SLDPRT
38.1 x 19.1 x 38.1 mm
