chazlambo/Omnimagnet/Solidworks/Tank Setup/Aligner String.SLDPRT

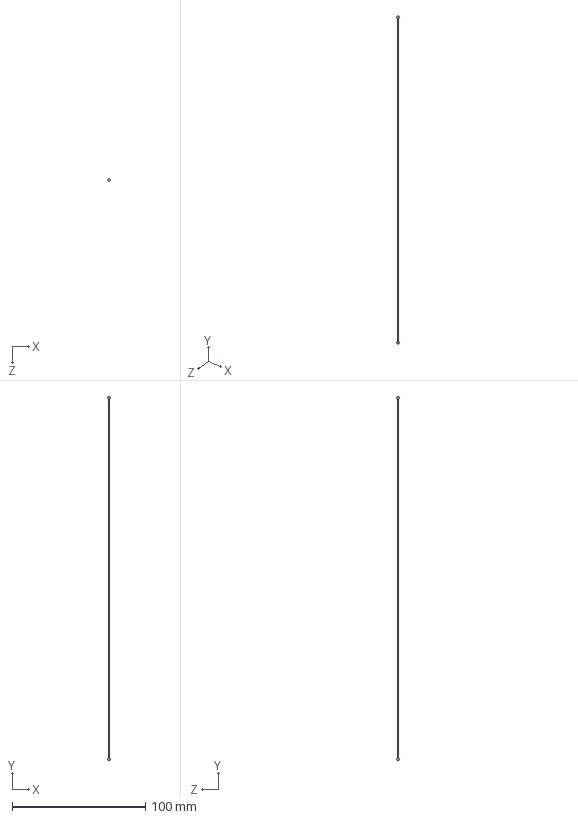
[picture p51: CAD file, 2025-07-17]
Solidworks/Tank Setup/Aligner String.SLDPRT
2.00 x 272.8 x 1.98 mm
