chazlambo/Omnimagnet/Solidworks/Tank Setup/Acrylic Cover Template.SLDPRT

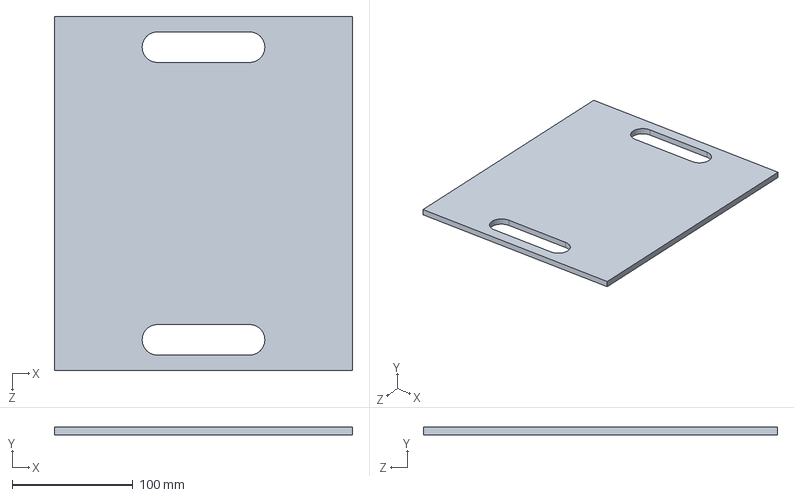
[picture p52: CAD file, 2025-07-17]
Solidworks/Tank Setup/Acrylic Cover Template.SLDPRT
247.0 x 6.35 x 293.0 mm
