chazlambo/Omnimagnet/Solidworks/Tank Setup/Acrylic Cover.SLDPRT

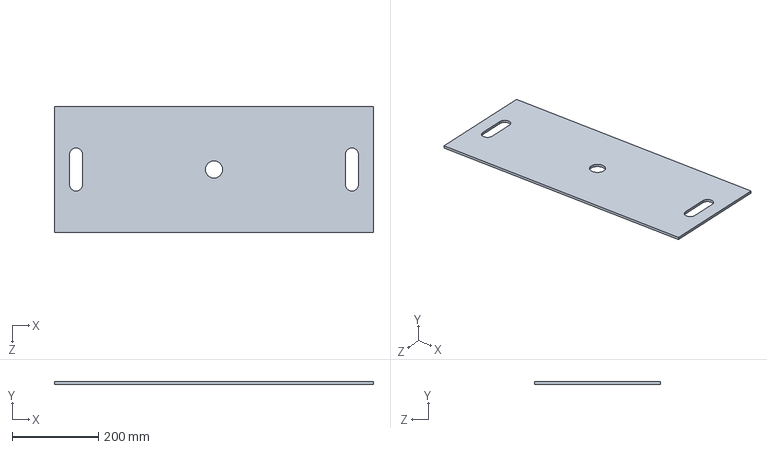
[picture p53: CAD file, 2025-07-17]
Solidworks/Tank Setup/Acrylic Cover.SLDPRT
740.0 x 6.35 x 293.0 mm
