chazlambo/Omnimagnet/(list of files, cad)

Other CAD files:
Solidworks/Master Box/Lid 2.SLDPRT
Solidworks/Wire Box/Frame.sldprt
Solidworks/Tank Setup/Acrylic Cover - Middle.SLDPRT
Solidworks/Arm Assembly/Assemblies/OM700001.SLDASM
Solidworks/Arm Assembly/Assemblies/OM700001.SLDDRW
Solidworks/Arm Assembly/Assemblies/OM700002.SLDASM
Solidworks/Arm Assembly/Assemblies/OM700002.SLDDRW
Solidworks/Arm Assembly/Assemblies/OM700003.SLDASM
Solidworks/Arm Assembly/Assemblies/OM700003.SLDDRW
Solidworks/Arm Assembly/Assemblies/OM700004.SLDASM
Solidworks/Arm Assembly/Assemblies/OM700004.SLDDRW
Solidworks/Arm Assembly/Assemblies/OM700005.SLDASM
Solidworks/Arm Assembly/Assemblies/OM700005.SLDDRW
Solidworks/Arm Assembly/Assemblies/OM700006.SLDASM
Solidworks/Arm Assembly/Assemblies/OM700006.SLDDRW
Solidworks/Arm Assembly/Assemblies/OM700007.SLDASM
Solidworks/Arm Assembly/Assemblies/OM700007.SLDDRW
Solidworks/Arm Assembly/Assemblies/OM700008.SLDASM
Solidworks/Arm Assembly/Assemblies/OM700008.SLDDRW
Solidworks/Arm Assembly/Assemblies/OM700009.SLDASM
Solidworks/Arm Assembly/Assemblies/OM700009.SLDDRW
Solidworks/Arm Assembly/Assemblies/OM700010.SLDASM
Solidworks/Arm Assembly/Assemblies/OM700010.SLDDRW
Solidworks/Arm Assembly/Assemblies/OM700011.SLDASM
Solidworks/Arm Assembly/Assemblies/OM700011.SLDDRW
Solidworks/Arm Assembly/Assemblies/OM700012.SLDASM
Solidworks/Arm Assembly/Assemblies/OM700012.SLDDRW
Solidworks/Arm Assembly/Assemblies/OM700013.SLDASM
Solidworks/Arm Assembly/Assemblies/OM700013.SLDDRW
Solidworks/Arm Assembly/Parts to be Machined/OM500001 (Rotating Base Plate).SLDDRW
Solidworks/Arm Assembly/Parts to be Machined/OM500001.sldprt
Solidworks/Arm Assembly/Parts to be Machined/OM500002 (Base Plate - Table).SLDDRW
Solidworks/Arm Assembly/Parts to be Machined/OM500002.SLDPRT
Solidworks/Arm Assembly/Parts to be Machined/OM500003 (Top Base Plate).SLDDRW
Solidworks/Arm Assembly/Parts to be Machined/OM500003.sldprt
Solidworks/Arm Assembly/Parts to be Machined/OM500004 (Holding Plate).SLDDRW
Solidworks/Arm Assembly/Parts to be Machined/OM500004.SLDPRT
Solidworks/Arm Assembly/Parts to be Machined/OM500006 (Gasket Over Ring).SLDDRW
Solidworks/Arm Assembly/Parts to be Machined/OM500006.SLDPRT
Solidworks/Arm Assembly/Parts to be Machined/OM500007 (Gasket Under Ring).SLDDRW
Solidworks/Arm Assembly/Parts to be Machined/OM500007.SLDPRT
Solidworks/Arm Assembly/Parts to be Machined/OM500008 (Inside Pot Holder) LP rev.SLDDRW
Solidworks/Arm Assembly/Parts to be Machined/OM500008 (Inside Pot Holder).SLDDRW
Solidworks/Arm Assembly/Parts to be Machined/OM500008.SLDPRT
Solidworks/Arm Assembly/Parts to be Machined/OM500010 (Vertical Post).SLDDRW
Solidworks/Arm Assembly/Parts to be Machined/OM500010.SLDPRT
Solidworks/Arm Assembly/Parts to be Machined/OM500011 (Horizontal Beam).SLDDRW
Solidworks/Arm Assembly/Parts to be Machined/OM500011.SLDPRT
Solidworks/Arm Assembly/Parts to be Machined/OM500012 (Break Block).SLDDRW
Solidworks/Arm Assembly/Parts to be Machined/OM500012.SLDPRT
Solidworks/Arm Assembly/Parts to be Machined/OM500013 (Capping Plate).SLDDRW
Solidworks/Arm Assembly/Parts to be Machined/OM500013.SLDPRT
Solidworks/Arm Assembly/Parts to be Machined/OM500014 (Table Spacer).SLDDRW
Solidworks/Arm Assembly/Parts to be Machined/OM500014.SLDPRT
Solidworks/Arm Assembly/Parts to be Machined/OM500015 (Centering Shaft).SLDDRW
Solidworks/Arm Assembly/Parts to be Machined/OM500015.SLDPRT
Solidworks/Arm Assembly/Parts to be Machined/OM500016 (Threaded Pulley Plate).SLDDRW
Solidworks/Arm Assembly/Parts to be Machined/OM500016.sldprt
Solidworks/Arm Assembly/Parts to be Machined/OM500017 (Spacer).SLDDRW
Solidworks/Arm Assembly/Parts to be Machined/OM500017.SLDPRT
Solidworks/Arm Assembly/Parts to be Machined/OM500020 (Linear Mating Plate).SLDDRW
Solidworks/Arm Assembly/Parts to be Machined/OM500020.SLDPRT
Solidworks/Arm Assembly/Parts to be Machined/OM500021 (Pad Bracket).SLDDRW
Solidworks/Arm Assembly/Parts to be Machined/OM500021-LP.SLDPRT
Solidworks/Arm Assembly/Parts to be Machined/OM500021.SLDPRT
Solidworks/Master Box/Lid 2.STL
Solidworks/Master Box/Master Box 2.STL
Solidworks/Master Box/Master Box.STL
Solidworks/Master Box/Screw.SLDPRT
Solidworks/Omni Arduino Box/Arduino Box Slide.STL
Solidworks/Omni Arduino Box/Arduino Box.STL
Solidworks/Omni Arduino Box/Old Wirebox.SLDPRT
Solidworks/Omnimagnet Box/Bottom Box.STL
Solidworks/Omnimagnet Box/Top Box.STL
Solidworks/Tank Setup/DXF/Acrylic Cover - Left.DXF
Solidworks/Tank Setup/DXF/Acrylic Cover - Middle.DXF
Solidworks/Tank Setup/DXF/Acrylic Cover - Right.DXF
Solidworks/Tank Setup/DXF/_Archive/Acrylic Cover - Left - 6-5.DXF
Solidworks/Tank Setup/DXF/_Archive/Acrylic Cover - Middle 6-5.DXF
Solidworks/Tank Setup/DXF/_Archive/Acrylic Cover - Right 6-5.DXF
Solidworks/Tank Setup/STLs/Aligner Grouper.STL
Solidworks/Tank Setup/STLs/Raft Aligner Bottom Peg.STL
Solidworks/Tank Setup/STLs/Raft Aligner Middle Peg.STL
Solidworks/Tank Setup/STLs/Raft Aligner Spacer.STL
Solidworks/Tank Setup/STLs/Raft Aligner Top Peg.3mf
Solidworks/Tank Setup/STLs/Raft Aligner Top Peg.STL
Solidworks/Tank Setup/STLs/Universal Raft.STL
Solidworks/Tank Setup/STLs/_Archive/Raft Aligner Bottom Peg - 6-3.STL
Solidworks/Tank Setup/STLs/_Archive/Raft Aligner Bottom Peg - 9-3.STL
Solidworks/Tank Setup/STLs/_Archive/Raft Aligner Top Peg - 6-3.STL
Solidworks/Tank Setup/STLs/_Archive/Raft Aligner Top Peg - 6-9.3mf
Solidworks/Tank Setup/STLs/_Archive/Raft Aligner Top Peg - 9-3.STL
Solidworks/Wire Box/Screw.SLDPRT
