chazlambo/Omnimagnet/Documentation/Wiring-Pin Tables/PIN TABLES.xlsx

Breakout Board - MDFLY Dual RJ45 (MOL-DB0029)
Pin | Use | Wire Color | Notes
1 | Ground | Black | 2x A2D ground, Base Pot, Vert. Pot, Relay (blue, double knot)
2 | 5 Volt - I2C modules | Red and Blue | 2x Red cables that connect to A2D modules
3 | SCL Position | Yellow
4 | SDA Position | Blue
5 | SCL Temperature | Yellow
6 | SDA Temperature | Blue
7 | 5 Volt - Power Supply | (Power Supply) | 4 Potentiometer red cables, relay power cable (blue, single knot)
8 | 12 Volt - LED's | Red and Blue
SH | LED Ground | Black | Not 100% sure tbh lol
POSITION: I2C Module (A2D) - Adafruit PCF8591
Pin | Use | Color | Notes
GND | Ground | Black | Ground wire for Horizontal and Wrist potentiometers
A0 | Horizontal Pot | Green/Black
A1 | Wrist Pot | Blue/Black
A2 | Base Pot | White
A3 | Vertical Pot | White
OUT - Relay | Relay Out | Blue | Relay wire (blue, no knots)
TEMPERATURE: I2C Module (A2D) - Adafruit PCF8591
Pin | Use | Color | Notes
GND | Ground | Red/White | Ground wire for thermocouples and amplifiers
A0 | Thermocouple 1 | Blue
A1 | Thermocouple 2 | Orange
A2 | Thermocouple 3 | Green/White
A3 | N/A
OUT | N/A
Omnimagnet Ethernet Breakout - MDFLY RJ45
Pin | Use | Color | Notes
1 | N/A | Orange/White | Not connected down to wirebox
2 | Thermocouple 2 Out | Orange
3 | Thermocouple 3 Out | Green/White
4 | Thermocouple 1 Out | Blue
5 | N/A | Blue/White
6 | Ground | Green
7 | 5V | Red/White
8 | N/A | Red
Microcontroller - Arduino Mega
Pin | Use | Color | Notes
20 | SDA | Blue | I2C Bus for pose ADC modules
21 | SCL | Yellow
5V | 5V | Red
GND | N/A | Black
I2C Multiplexer - Adafruit TCA9548A
Pin | Use | Color | Notes
Vin | 5V | Red
GND | Ground | Black
SDA | Master SDA | Blue
SCL | Master SCL | Yellow
SD1 | Position SDA | Blue
SC1 | Position SCL | Yellow
SD2 | Temperature SDA | Blue
SC2 | Temperature SCL | Yellow
