chazlambo/Omnimagnet/Documentation/Wiring-Pin Tables/Wirebox Color Reference Sheet.xlsx

Sheet: Sorted By Color
Wire Color | Use: | Notes
Grey Wire Bus
Red | N/A | Connected to Pin 1 of Omnibox breakout
Red/White | Thermocouple 5V
Red/Black | Potentiometer 5V
Orange | Thermocouple #2 Output | Connects to A1 of Temp ADC
Orange/Black | N/A
Green | Thermocouple Ground | Thermocouple ground
Green/White | Thermocouple #3 Output
Green/Black | Horizontal Potentiometer Output | Connects to A0 of Position ADC
Blue | Thermocouple #1 Output | Connects to A0 of Temp ADC
Blue/White | N/A | Pin 5 of Omni box breakout
Blue/Black | Wrist Potentiometer Output | Connects to A1 of Position ADC
White | N/A
White/Black | N/A
Black | Ground
Black/White | N/A
Shield | N/A
Arm Housing
White | Base Potentiometer Output | Connects to A2 of Position ADC
White | Vertical Potentiometer Output | Connects to A3 of Position ADC
Relay Wires
Blue (No Knot) | Relay Out | Connects to OUT of Position ADC
Blue (Single Knot) | Relay 5V
Blue (Double Knot) | Relay Ground
Thick Black | 12V | Powers top LED's
Thick Red | 12V LED Ground

Sheet: Sorted by Purpose
Wire Color | Use: | Notes
Potentiometers
Green/Black | Horizontal Potentiometer Output | Connects to A0 of Position ADC
Blue/Black | Wrist Potentiometer Output | Connects to A1 of Position ADC
White | Base Potentiometer Output | Connects to A2 of Position ADC
White | Vertical Potentiometer Output | Connects to A3 of Position ADC
Black | Potentiometer Ground
Red/Black | Potentiometer 5V
Thermocouples
Blue | Thermocouple #1 Output | Connects to A0 of Temp ADC
Orange | Thermocouple #2 Output | Connects to A1 of Temp ADC
Green/White | Thermocouple #3 Output | Connects to A2 of Temp ADC
Red/White | Thermocouple 5V
Green | Thermocouple Ground | Thermocouple ground
Relays
Blue (No Knot) | Relay Out | Connects to OUT of Position ADC
Blue (Single Knot) | Relay 5V
Blue (Double Knot) | Relay Ground
Thick Black | 12V Ground
Thick Red | 12V | Powers top LED's
Not Used
Red | N/A | Connected to Pin 1 of Omnibox breakout
Blue/White | N/A | Pin 5 of Omni box breakout
Orange/Black | N/A
White | N/A
White/Black | N/A
Black/White | N/A
Shield | N/A
