chazlambo/Omnimagnet/Code/Basic Operation/build/frame.jpg

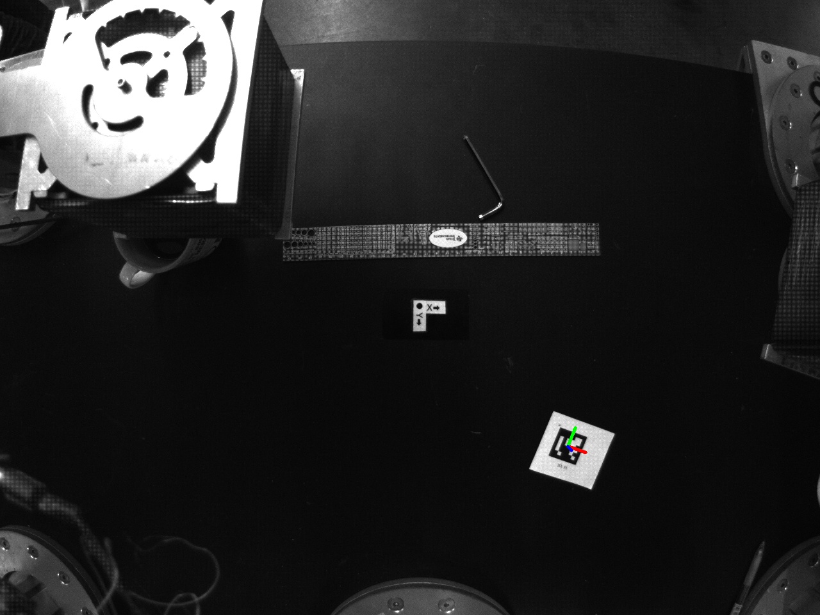
Code/Basic Operation/build/frame.jpg
