chazlambo/Omnimagnet/Code/Basic Operation/build/try.png

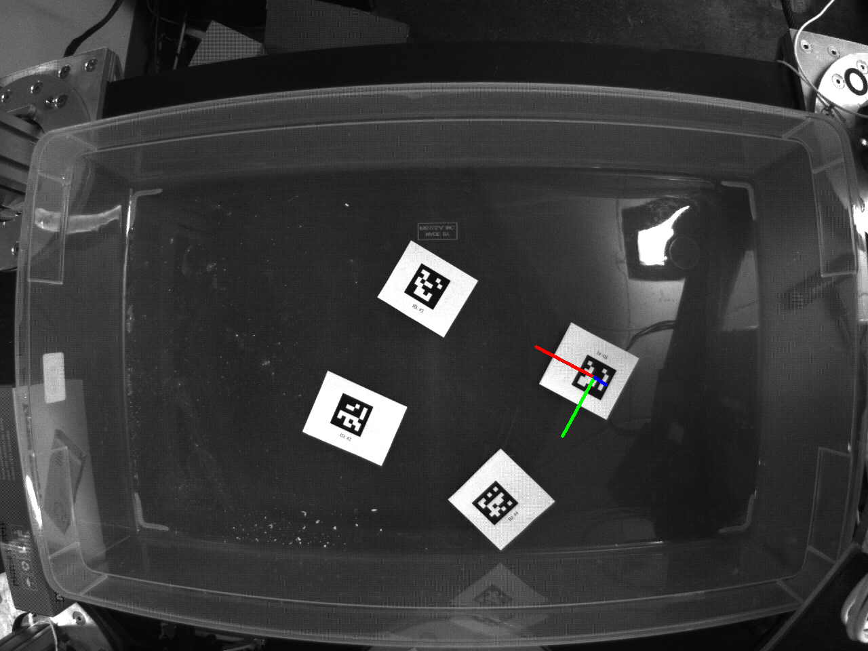
Code/Basic Operation/build/try.png
