chazlambo/Omnimagnet/Documentation/Wiring-Pin Tables/Arm Wiring Diagram.PNG

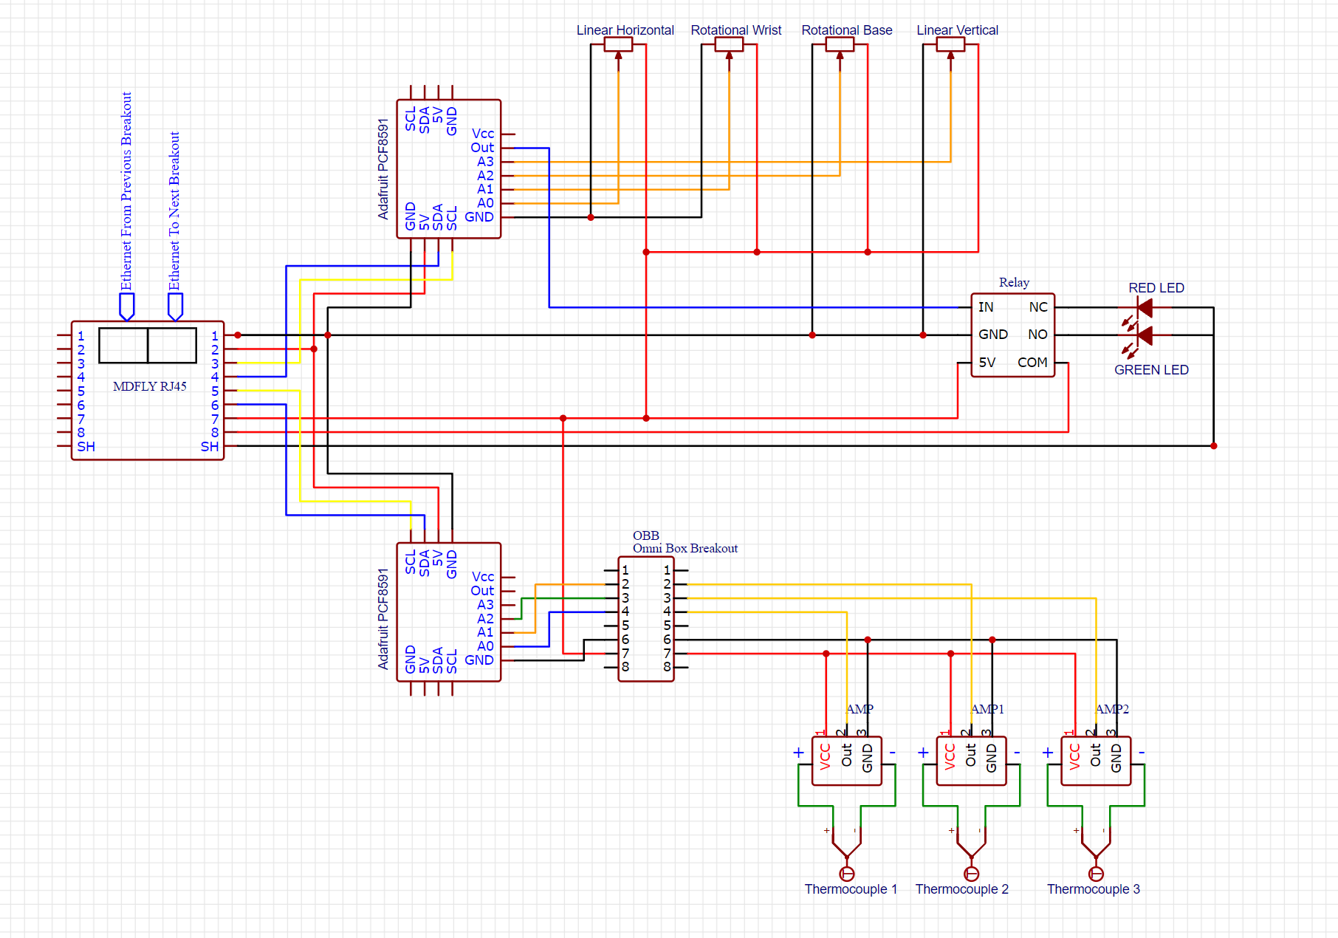
Documentation/Wiring-Pin Tables/Arm Wiring Diagram.PNG
