chazlambo/Omnimagnet/Documentation/Testing and Calibration/Potentiometer Sheet.xlsx

Arm # | Pot. | Horizontal | Wrist | Base | Vertical
1 | Horizontal |  |  |  |  | Key
 | Wrist |  |  |  |  |  | = Working
 | Base |  |  |  |  |  | = Not Working
 | Vertical |  |  |  |  |  | = Coupled
2 | Horizontal |  |  |  |  |  | = Not Coupled
 | Wrist
 | Base
 | Vertical
3 | Horizontal
 | Wrist
 | Base
 | Vertical
4 | Horizontal
 | Wrist
 | Base
 | Vertical
5 | Horizontal
 | Wrist
 | Base
 | Vertical
