chazlambo/Omnimagnet/Documentation/Testing and Calibration/Thermocouple Sheet.xlsx

Arm # | Pot. | Wire 1 | Notes
1 | Thermo 1 |  |  |  |  | Thermo1 = Green
 | Thermo 2 |  |  | Key |  | Thermo 2 = Blue
 | Thermo 3 |  |  |  | = Working | Thermo 3 = Orange
2 | Thermo 1 |  |  |  | = Wired
 | Thermo 2 |  | No wires |  | = Not Working/Wired
 | Thermo 3 |  | No wires
3 | Thermo 1
 | Thermo 2
 | Thermo 3
4 | Thermo 1
 | Thermo 2
 | Thermo 3
5 | Thermo 1
 | Thermo 2
 | Thermo 3
NOTE: Have not checked if any of them are even working, just checked to see which omnimagnets had wires for the thermocouples
NOTE: Attempting to plug in temp ADC module for Arm 1 causes the power supply fan to go nuts
