chazlambo/Omnimagnet/Code/Tractor Beam/output/experiment_A1/experiment_A1_image_log.csv

filename | timestamp
../output/experiment_A1/frame_0.jpg | 2025-07-25 12:35:00
../output/experiment_A1/frame_1.jpg | 2025-07-25 12:35:02
../output/experiment_A1/frame_2.jpg | 2025-07-25 12:35:04
../output/experiment_A1/frame_3.jpg | 2025-07-25 12:35:06
../output/experiment_A1/frame_4.jpg | 2025-07-25 12:35:08
../output/experiment_A1/frame_5.jpg | 2025-07-25 12:35:11
../output/experiment_A1/frame_6.jpg | 2025-07-25 12:35:13
../output/experiment_A1/frame_7.jpg | 2025-07-25 12:35:15
../output/experiment_A1/frame_8.jpg | 2025-07-25 12:35:17
../output/experiment_A1/frame_9.jpg | 2025-07-25 12:35:19
../output/experiment_A1/frame_10.jpg | 2025-07-25 12:35:22
../output/experiment_A1/frame_11.jpg | 2025-07-25 12:35:24
../output/experiment_A1/frame_12.jpg | 2025-07-25 12:35:26
../output/experiment_A1/frame_13.jpg | 2025-07-25 12:35:28
../output/experiment_A1/frame_14.jpg | 2025-07-25 12:35:30
../output/experiment_A1/frame_15.jpg | 2025-07-25 12:35:32
../output/experiment_A1/frame_16.jpg | 2025-07-25 12:35:35
../output/experiment_A1/frame_17.jpg | 2025-07-25 12:35:37
../output/experiment_A1/frame_18.jpg | 2025-07-25 12:35:39
../output/experiment_A1/frame_19.jpg | 2025-07-25 12:35:41
../output/experiment_A1/frame_20.jpg | 2025-07-25 12:35:43
../output/experiment_A1/frame_21.jpg | 2025-07-25 12:35:46
../output/experiment_A1/frame_22.jpg | 2025-07-25 12:35:48
../output/experiment_A1/frame_23.jpg | 2025-07-25 12:35:50
../output/experiment_A1/frame_24.jpg | 2025-07-25 12:35:52
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
../output/experiment_A1/frame_95.jpg | 2025-07-25 12:38:28
../output/experiment_A1/frame_96.jpg | 2025-07-25 12:38:30
../output/experiment_A1/frame_97.jpg | 2025-07-25 12:38:32
../output/experiment_A1/frame_98.jpg | 2025-07-25 12:38:34
../output/experiment_A1/frame_99.jpg | 2025-07-25 12:38:37
../output/experiment_A1/frame_100.jpg | 2025-07-25 12:38:39
../output/experiment_A1/frame_101.jpg | 2025-07-25 12:38:41
../output/experiment_A1/frame_102.jpg | 2025-07-25 12:38:43
