chazlambo/Omnimagnet/Code/Tractor Beam/output/experiment_A2/experiment_A2_image_log.csv

filename | timestamp
../output/experiment_A2/images/frame_0.jpg | 2025-07-25 12:58:00
../output/experiment_A2/images/frame_1.jpg | 2025-07-25 12:58:02
../output/experiment_A2/images/frame_2.jpg | 2025-07-25 12:58:04
../output/experiment_A2/images/frame_3.jpg | 2025-07-25 12:58:06
../output/experiment_A2/images/frame_4.jpg | 2025-07-25 12:58:08
../output/experiment_A2/images/frame_5.jpg | 2025-07-25 12:58:11
../output/experiment_A2/images/frame_6.jpg | 2025-07-25 12:58:13
../output/experiment_A2/images/frame_7.jpg | 2025-07-25 12:58:15
../output/experiment_A2/images/frame_8.jpg | 2025-07-25 12:58:17
../output/experiment_A2/images/frame_9.jpg | 2025-07-25 12:58:19
../output/experiment_A2/images/frame_10.jpg | 2025-07-25 12:58:22
../output/experiment_A2/images/frame_11.jpg | 2025-07-25 12:58:24
../output/experiment_A2/images/frame_12.jpg | 2025-07-25 12:58:26
../output/experiment_A2/images/frame_13.jpg | 2025-07-25 12:58:28
../output/experiment_A2/images/frame_14.jpg | 2025-07-25 12:58:30
../output/experiment_A2/images/frame_15.jpg | 2025-07-25 12:58:32
../output/experiment_A2/images/frame_16.jpg | 2025-07-25 12:58:35
../output/experiment_A2/images/frame_17.jpg | 2025-07-25 12:58:37
../output/experiment_A2/images/frame_18.jpg | 2025-07-25 12:58:39
../output/experiment_A2/images/frame_19.jpg | 2025-07-25 12:58:41
../output/experiment_A2/images/frame_20.jpg | 2025-07-25 12:58:43
../output/experiment_A2/images/frame_21.jpg | 2025-07-25 12:58:46
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
../output/experiment_A2/images/frame_121.jpg | 2025-07-25 13:02:25
../output/experiment_A2/images/frame_122.jpg | 2025-07-25 13:02:27
../output/experiment_A2/images/frame_123.jpg | 2025-07-25 13:02:29
../output/experiment_A2/images/frame_124.jpg | 2025-07-25 13:02:31
