chazlambo/Omnimagnet/Code/Tractor Beam/output/experiment_A3/experiment_A3_image_log.csv

filename | timestamp
../output/experiment_A3/images/frame_0000.jpg | 2025-08-08 13:47:32
../output/experiment_A3/images/frame_0001.jpg | 2025-08-08 13:47:35
../output/experiment_A3/images/frame_0002.jpg | 2025-08-08 13:47:37
../output/experiment_A3/images/frame_0003.jpg | 2025-08-08 13:47:39
../output/experiment_A3/images/frame_0004.jpg | 2025-08-08 13:47:41
../output/experiment_A3/images/frame_0005.jpg | 2025-08-08 13:47:43
../output/experiment_A3/images/frame_0006.jpg | 2025-08-08 13:47:46
../output/experiment_A3/images/frame_0007.jpg | 2025-08-08 13:47:48
../output/experiment_A3/images/frame_0008.jpg | 2025-08-08 13:47:50
../output/experiment_A3/images/frame_0009.jpg | 2025-08-08 13:47:52
../output/experiment_A3/images/frame_0010.jpg | 2025-08-08 13:47:54
../output/experiment_A3/images/frame_0011.jpg | 2025-08-08 13:47:56
../output/experiment_A3/images/frame_0012.jpg | 2025-08-08 13:47:59
../output/experiment_A3/images/frame_0013.jpg | 2025-08-08 13:48:01
../output/experiment_A3/images/frame_0014.jpg | 2025-08-08 13:48:03
../output/experiment_A3/images/frame_0015.jpg | 2025-08-08 13:48:05
../output/experiment_A3/images/frame_0016.jpg | 2025-08-08 13:48:07
../output/experiment_A3/images/frame_0017.jpg | 2025-08-08 13:48:10
../output/experiment_A3/images/frame_0018.jpg | 2025-08-08 13:48:12
../output/experiment_A3/images/frame_0019.jpg | 2025-08-08 13:48:14
../output/experiment_A3/images/frame_0020.jpg | 2025-08-08 13:48:16
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
../output/experiment_A3/images/frame_0117.jpg | 2025-08-08 13:51:48
../output/experiment_A3/images/frame_0118.jpg | 2025-08-08 13:51:50
../output/experiment_A3/images/frame_0119.jpg | 2025-08-08 13:51:52
../output/experiment_A3/images/frame_0120.jpg | 2025-08-08 13:51:54
