chazlambo/Omnimagnet/Code/Tractor Beam/output/experiment_B2/experiment_B2_image_log.csv

filename | timestamp
../output/experiment_B2/images/frame_0000.jpg | 2025-08-08 14:13:26
../output/experiment_B2/images/frame_0001.jpg | 2025-08-08 14:13:28
../output/experiment_B2/images/frame_0002.jpg | 2025-08-08 14:13:30
../output/experiment_B2/images/frame_0003.jpg | 2025-08-08 14:13:33
../output/experiment_B2/images/frame_0004.jpg | 2025-08-08 14:13:35
../output/experiment_B2/images/frame_0005.jpg | 2025-08-08 14:13:37
../output/experiment_B2/images/frame_0006.jpg | 2025-08-08 14:13:39
../output/experiment_B2/images/frame_0007.jpg | 2025-08-08 14:13:41
../output/experiment_B2/images/frame_0008.jpg | 2025-08-08 14:13:43
../output/experiment_B2/images/frame_0009.jpg | 2025-08-08 14:13:46
../output/experiment_B2/images/frame_0010.jpg | 2025-08-08 14:13:48
../output/experiment_B2/images/frame_0011.jpg | 2025-08-08 14:13:50
../output/experiment_B2/images/frame_0012.jpg | 2025-08-08 14:13:52
../output/experiment_B2/images/frame_0013.jpg | 2025-08-08 14:13:54
../output/experiment_B2/images/frame_0014.jpg | 2025-08-08 14:13:57
../output/experiment_B2/images/frame_0015.jpg | 2025-08-08 14:13:59
../output/experiment_B2/images/frame_0016.jpg | 2025-08-08 14:14:01
../output/experiment_B2/images/frame_0017.jpg | 2025-08-08 14:14:03
../output/experiment_B2/images/frame_0018.jpg | 2025-08-08 14:14:05
../output/experiment_B2/images/frame_0019.jpg | 2025-08-08 14:14:07
../output/experiment_B2/images/frame_0020.jpg | 2025-08-08 14:14:10
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
../output/experiment_B2/images/frame_0297.jpg | 2025-08-08 14:24:15
../output/experiment_B2/images/frame_0298.jpg | 2025-08-08 14:24:17
../output/experiment_B2/images/frame_0299.jpg | 2025-08-08 14:24:19
../output/experiment_B2/images/frame_0300.jpg | 2025-08-08 14:24:21
