chazlambo/Omnimagnet/Code/Tractor Beam/output/calibration_test/frame_0.png

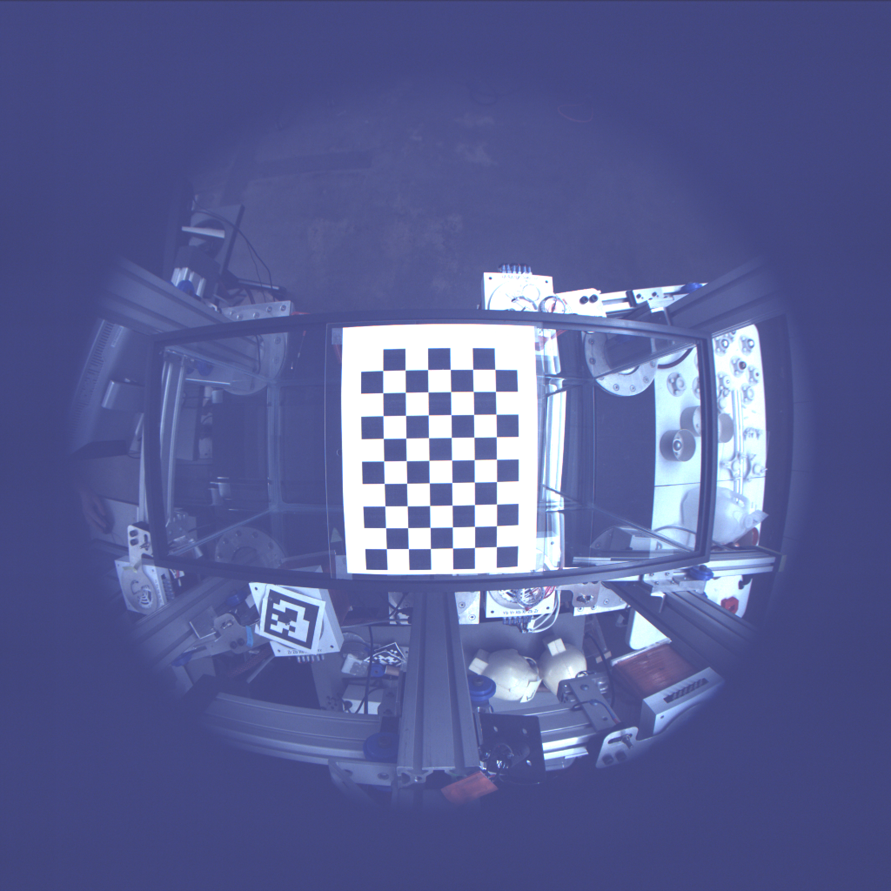
Code/Tractor Beam/output/calibration_test/frame_0.png
