chazlambo/Omnimagnet/Code/Tractor Beam/output/calibration_test/frame_1.png

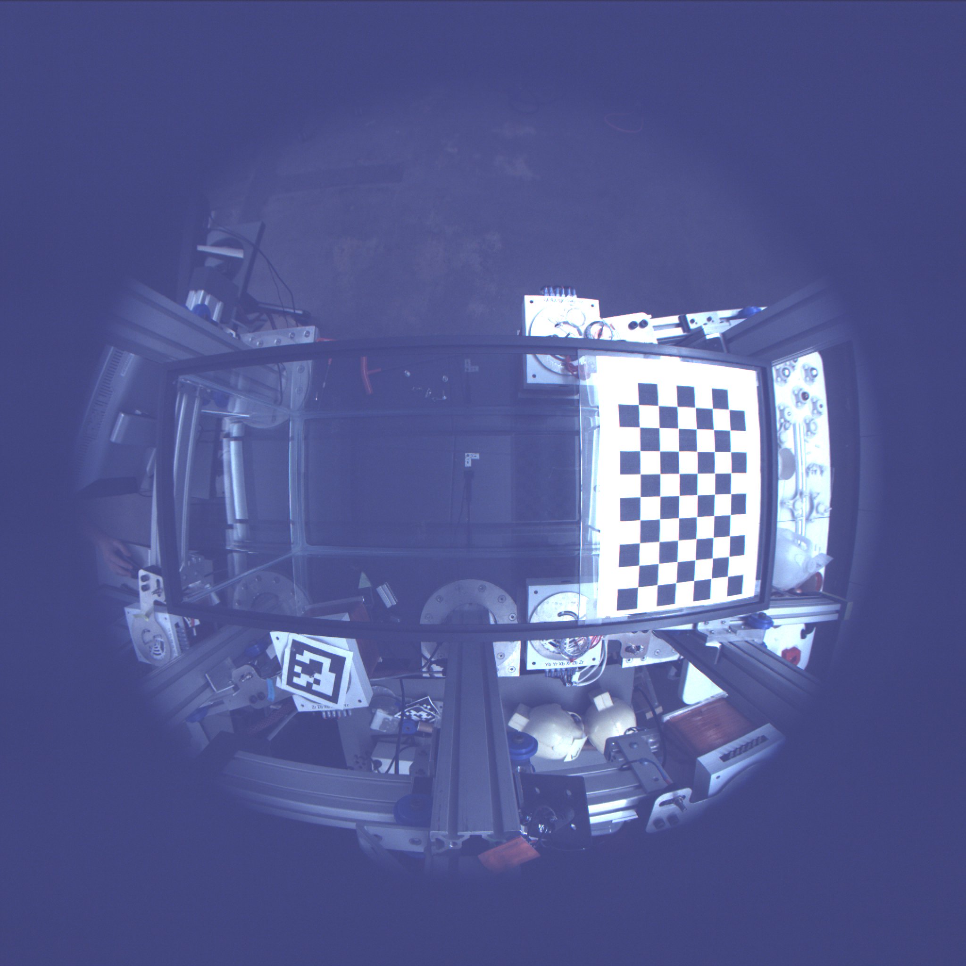
Code/Tractor Beam/output/calibration_test/frame_1.png
