chazlambo/Omnimagnet/Code/Tractor Beam/output/calibration_test/frame_3.png

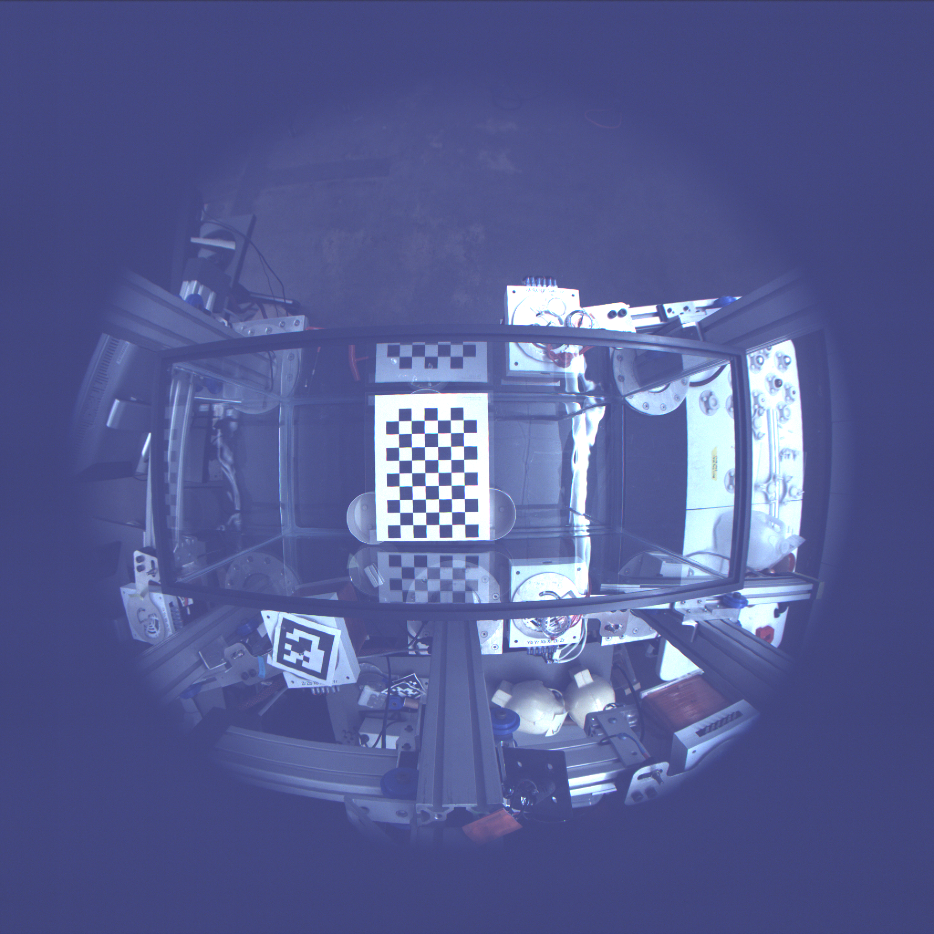
Code/Tractor Beam/output/calibration_test/frame_3.png
