chazlambo/Omnimagnet/Code/Tractor Beam/output/calibration_test/frame_5.png

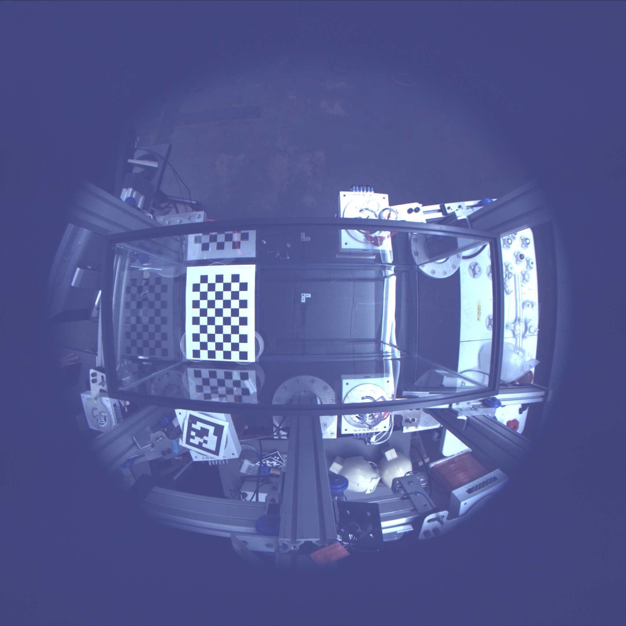
Code/Tractor Beam/output/calibration_test/frame_5.png
