chazlambo/Omnimagnet/Code/Tractor Beam/output/calibration_test/frame_6.png

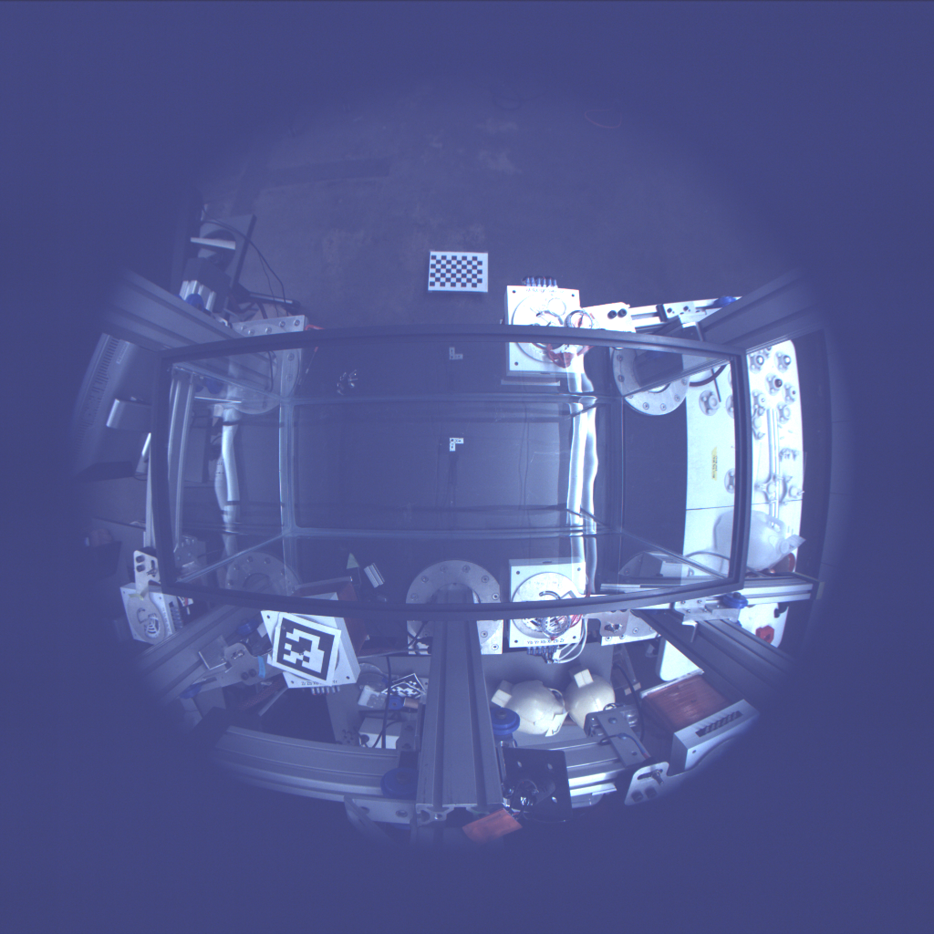
Code/Tractor Beam/output/calibration_test/frame_6.png
