chazlambo/Omnimagnet/Code/Tractor Beam/output/calibration_test/frame_7.png

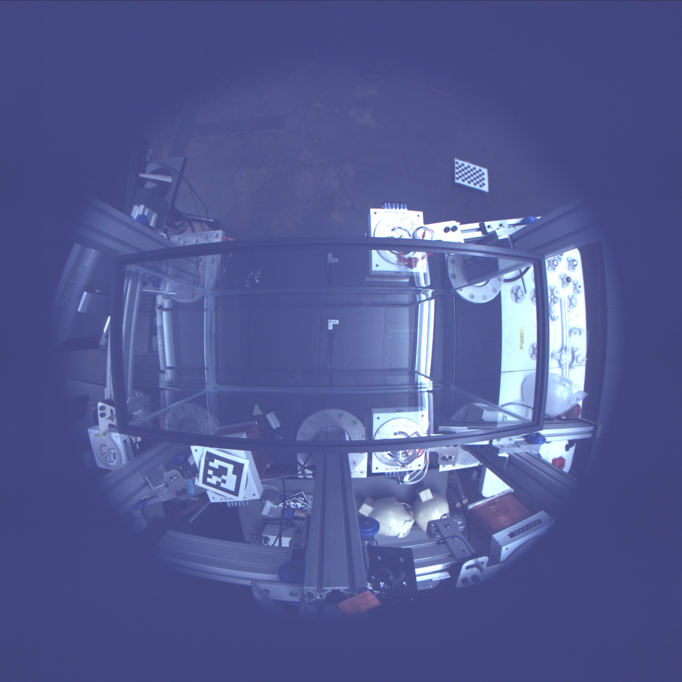
Code/Tractor Beam/output/calibration_test/frame_7.png
