chazlambo/Omnimagnet/Code/Tractor Beam/output/calibration_test/frame_11.png

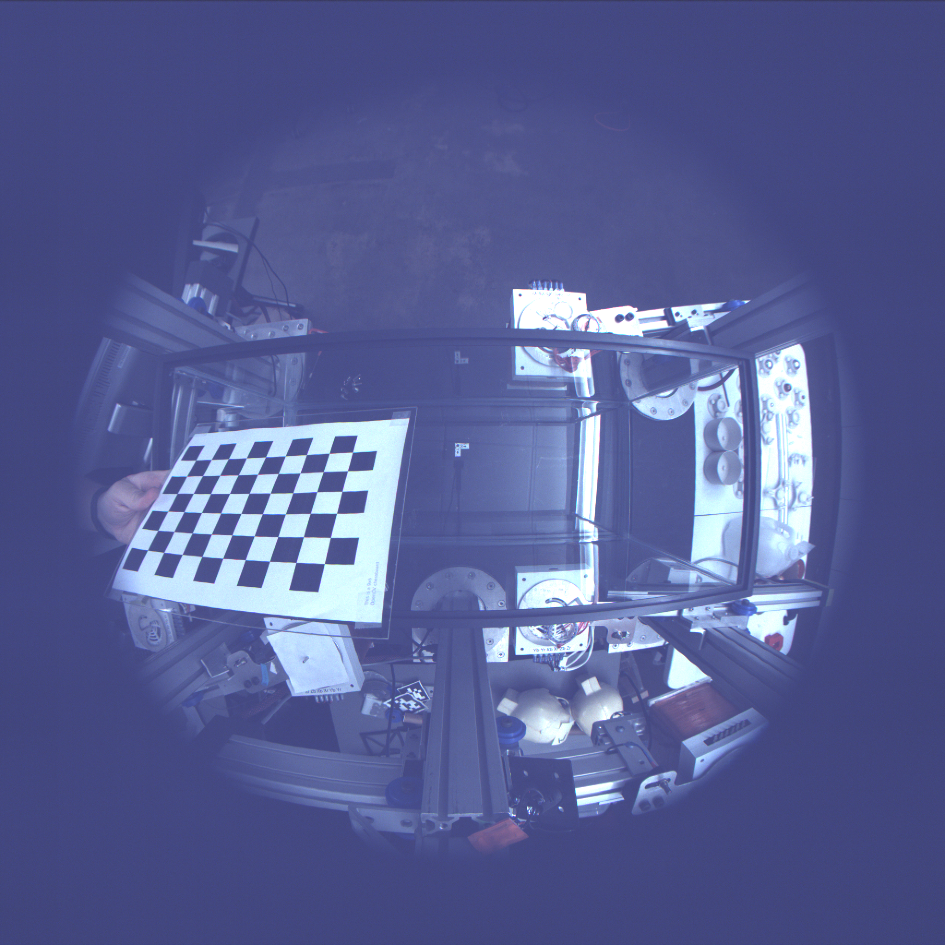
Code/Tractor Beam/output/calibration_test/frame_11.png
