chazlambo/Omnimagnet/Code/Tractor Beam/output/calibration_test/frame_12.png

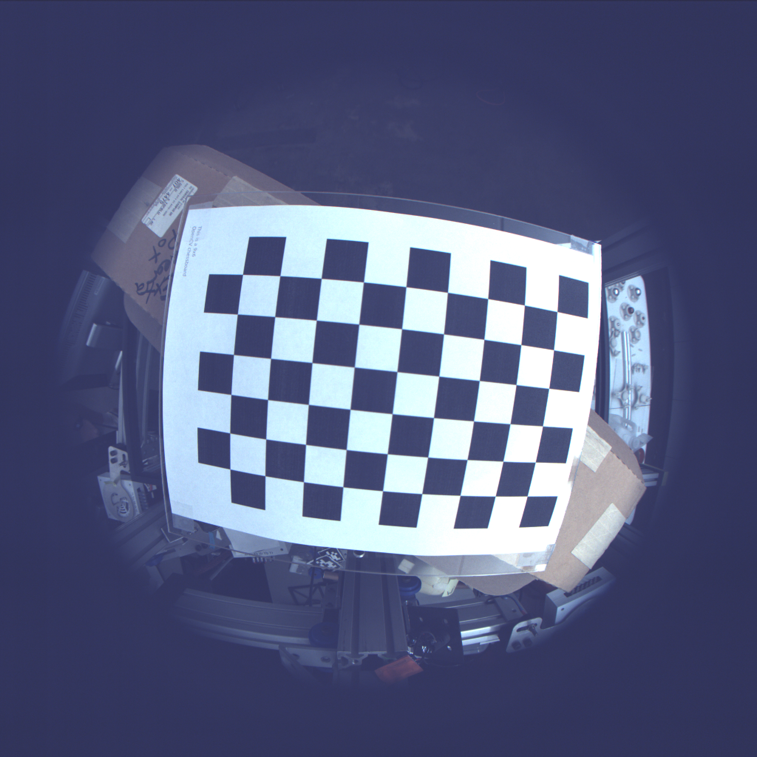
Code/Tractor Beam/output/calibration_test/frame_12.png
