chazlambo/Omnimagnet/Code/Tractor Beam/output/calibration_test/frame_13.png

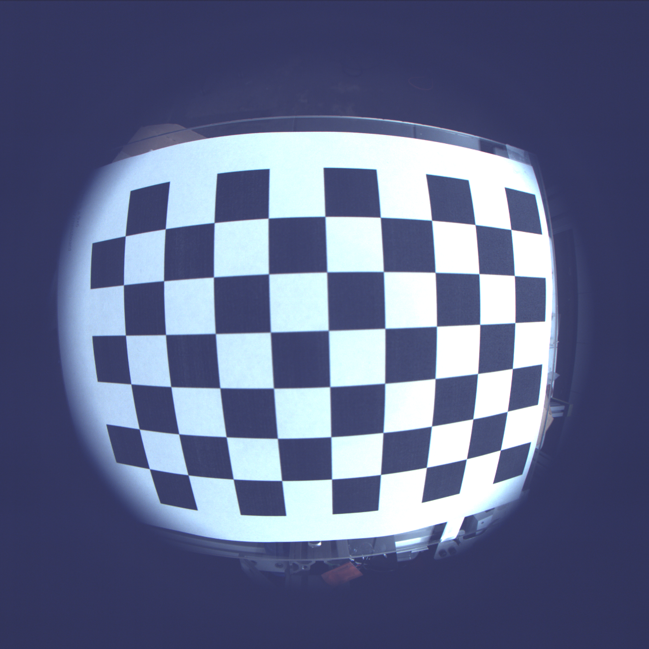
Code/Tractor Beam/output/calibration_test/frame_13.png
