chazlambo/Omnimagnet/Code/Tractor Beam/output/calibration_test/frame_14.png

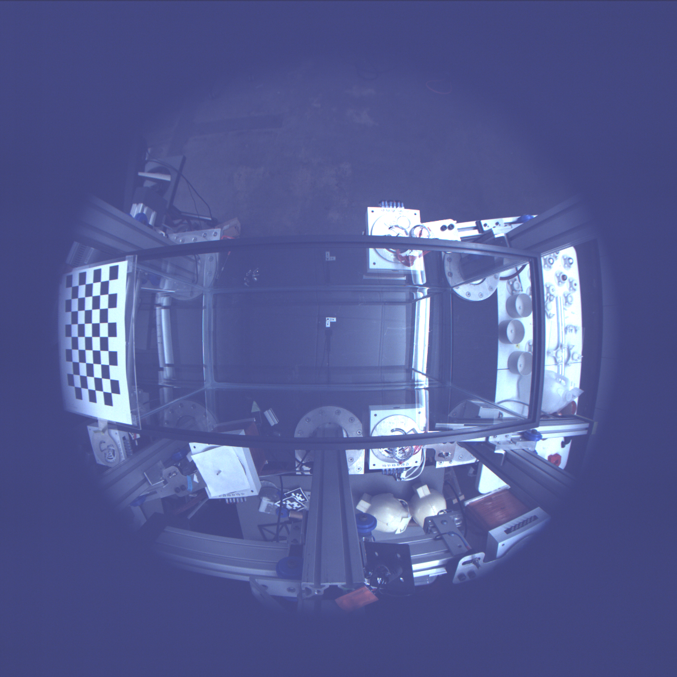
Code/Tractor Beam/output/calibration_test/frame_14.png
