chazlambo/Omnimagnet/Code/Tractor Beam/output/calibration_test/frame_15.png

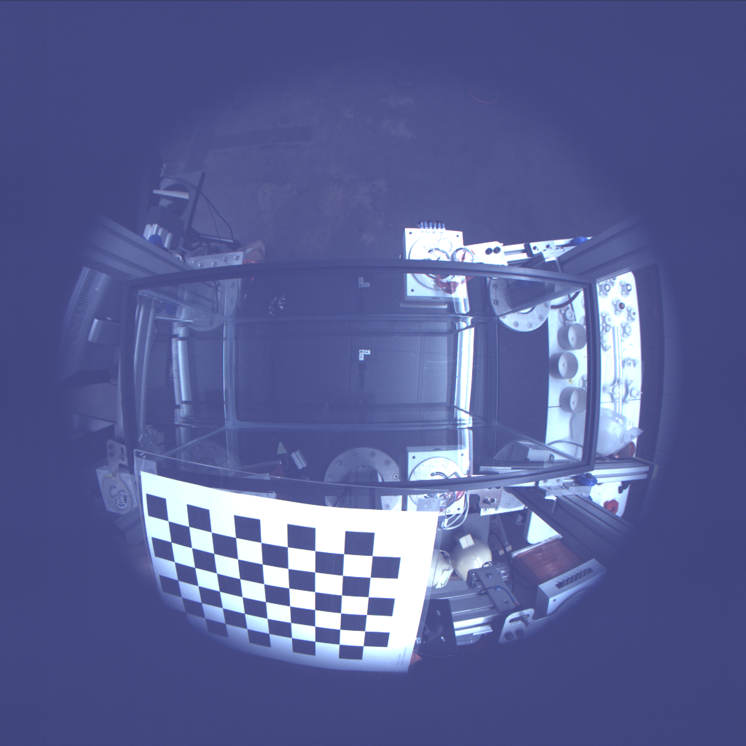
Code/Tractor Beam/output/calibration_test/frame_15.png
