chazlambo/Omnimagnet/Solidworks/Arm Assembly/Assemblies/OM700001.PDF

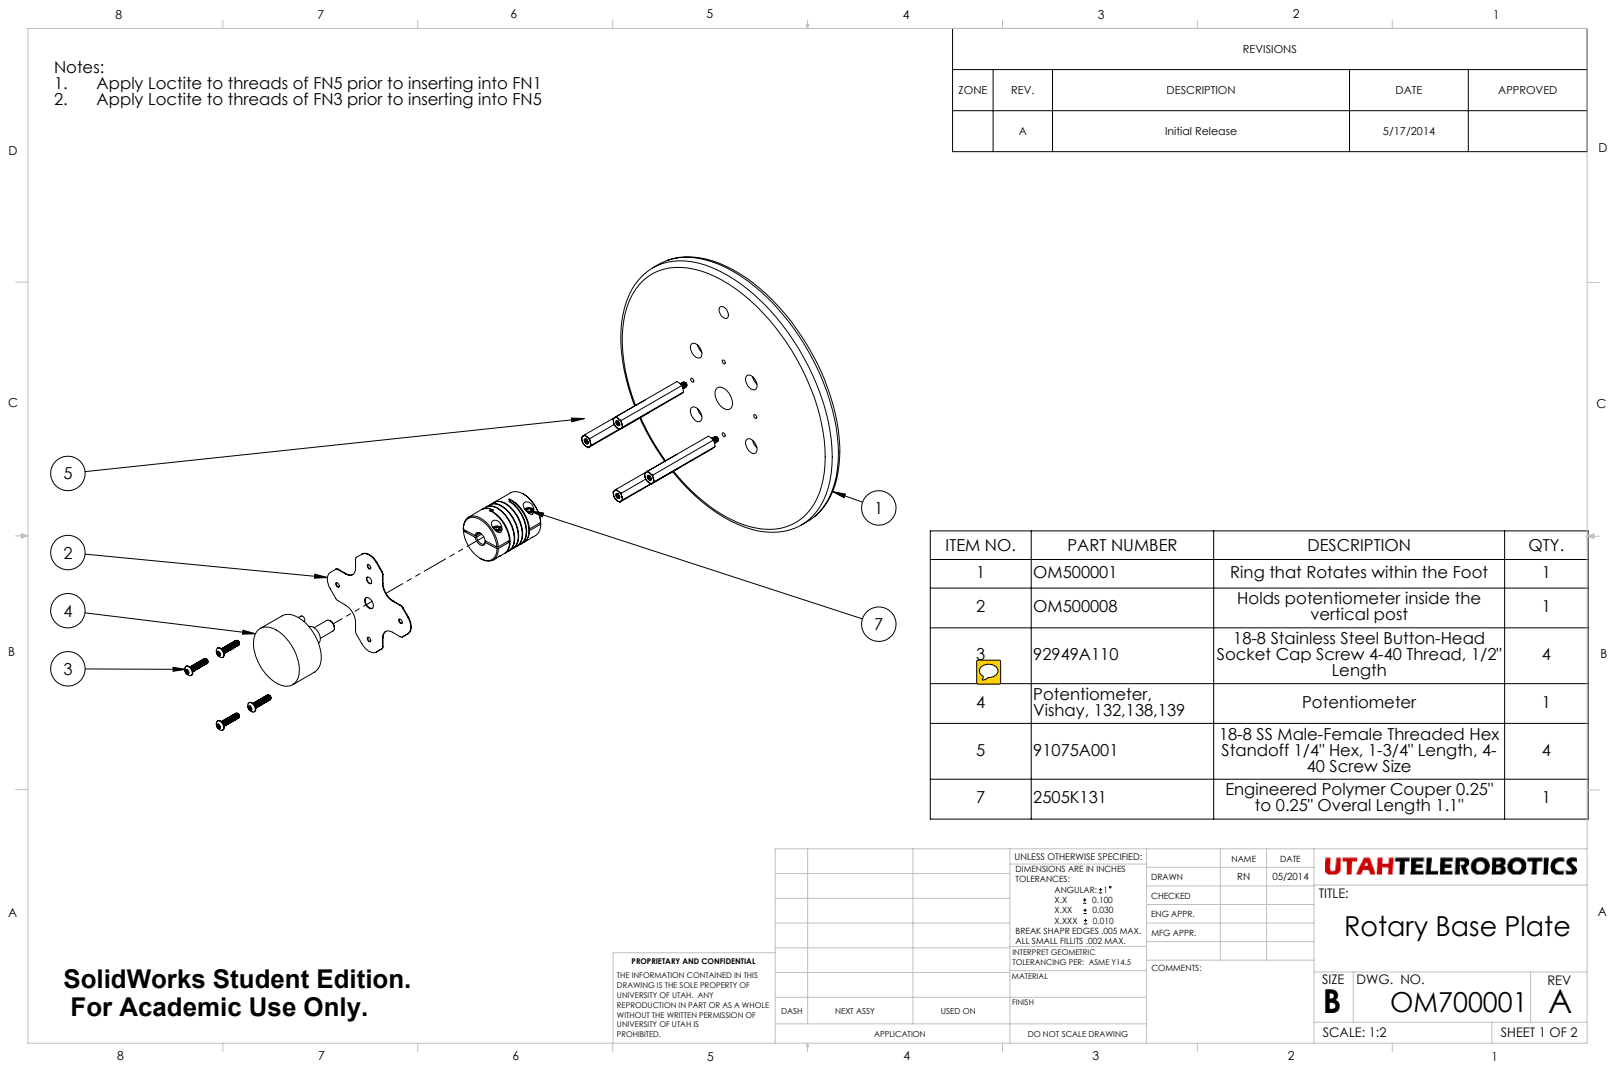
[picture p68: page 1]
NEXT ASSY; USED ON; ANGULAR: 1; ENG APPR.; DWG. NO.; REV; SCALE: 1:2; DO NOT SCALE DRAWING; SHEET 1 OF 2; MFG APPR.

Notes:
1. Apply Loctite to threads of FN5 prior to inserting into FN1
2. Apply Loctite to threads of FN3 prior to inserting into FN5

ZONE | REV. | DESCRIPTION | DATE | APPROVED

A | Initial Release | 5/17/2014

ITEM NO. | PART NUMBER | DESCRIPTION | QTY.
1 | OM500001 | Ring that Rotates within the Foot | 1
2 | OM500008 | Holds potentiometer inside the vertical post | 1
3 | 92949A110 | 18-8 Stainless Steel Button-Head Socket Cap Screw 4-40 Thread, 1/2" Length | 4

4 | Potentiometer, Vishay, 132,138,139 | Potentiometer | 1
5 | 91075A001 | 18-8 SS Male-Female Threaded Hex Standoff 1/4" Hex, 1-3/4" Length, 4-40 Screw Size | 4

7 | 2505K131 | Engineered Polymer Couper 0.25" to 0.25" Overal Length 1.1" | 1

UNLESS OTHERWISE SPECIFIED:
DIMENSIONS ARE IN INCHES
TOLERANCES:

Rotary Base Plate

SolidWorks Student Edition.
For Academic Use Only.

BREAK SHAPR EDGES .005 MAX.
ALL SMALL FILLITS .002 MAX.
INTERPRET GEOMETRIC
TOLERANCING PER: ASME Y14.5
MATERIAL

PROPRIETARY AND CONFIDENTIAL
THE INFORMATION CONTAINED IN THIS
DRAWING IS THE SOLE PROPERTY OF
UNIVERSITY OF UTAH. ANY
REPRODUCTION IN PART OR AS A WHOLE
WITHOUT THE WRITTEN PERMISSION OF
UNIVERSITY OF UTAH IS
PROHIBITED.

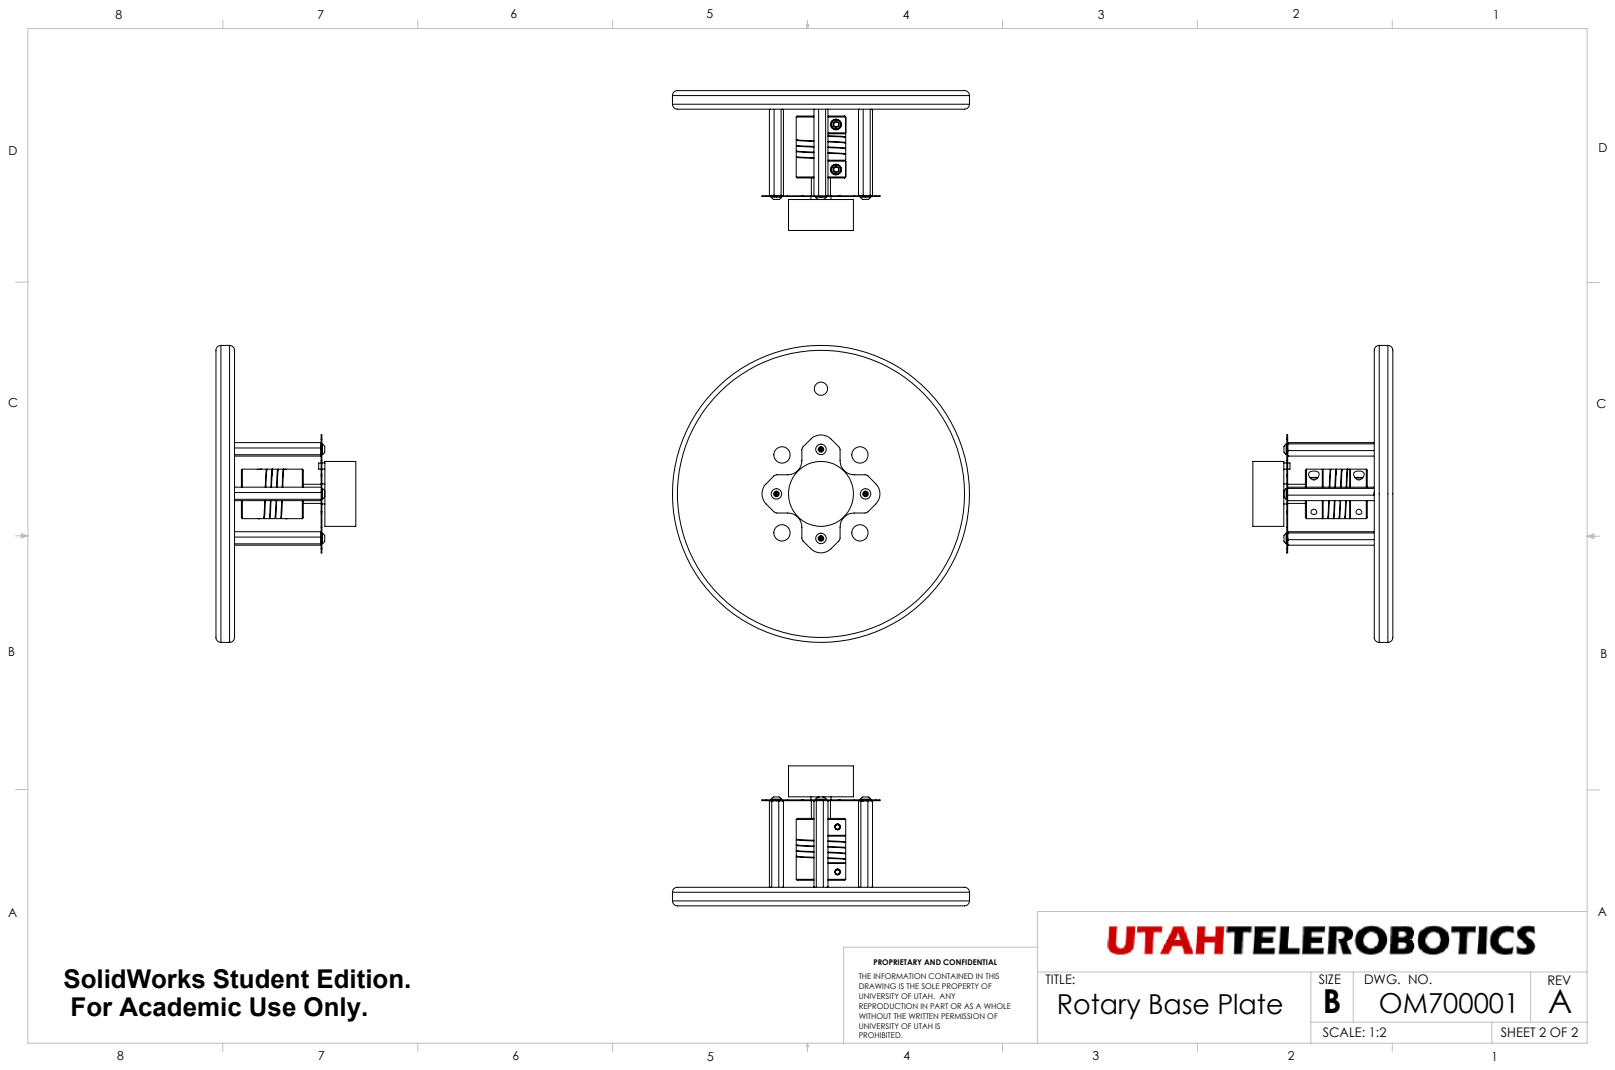
[picture p69: page 2]
DWG. NO.; REV; SCALE: 1:2; Rotary Base Plate; SHEET 2 OF 2

SolidWorks Student Edition.
For Academic Use Only.

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
