chazlambo/Omnimagnet/Solidworks/Arm Assembly/Assemblies/OM700002.PDF

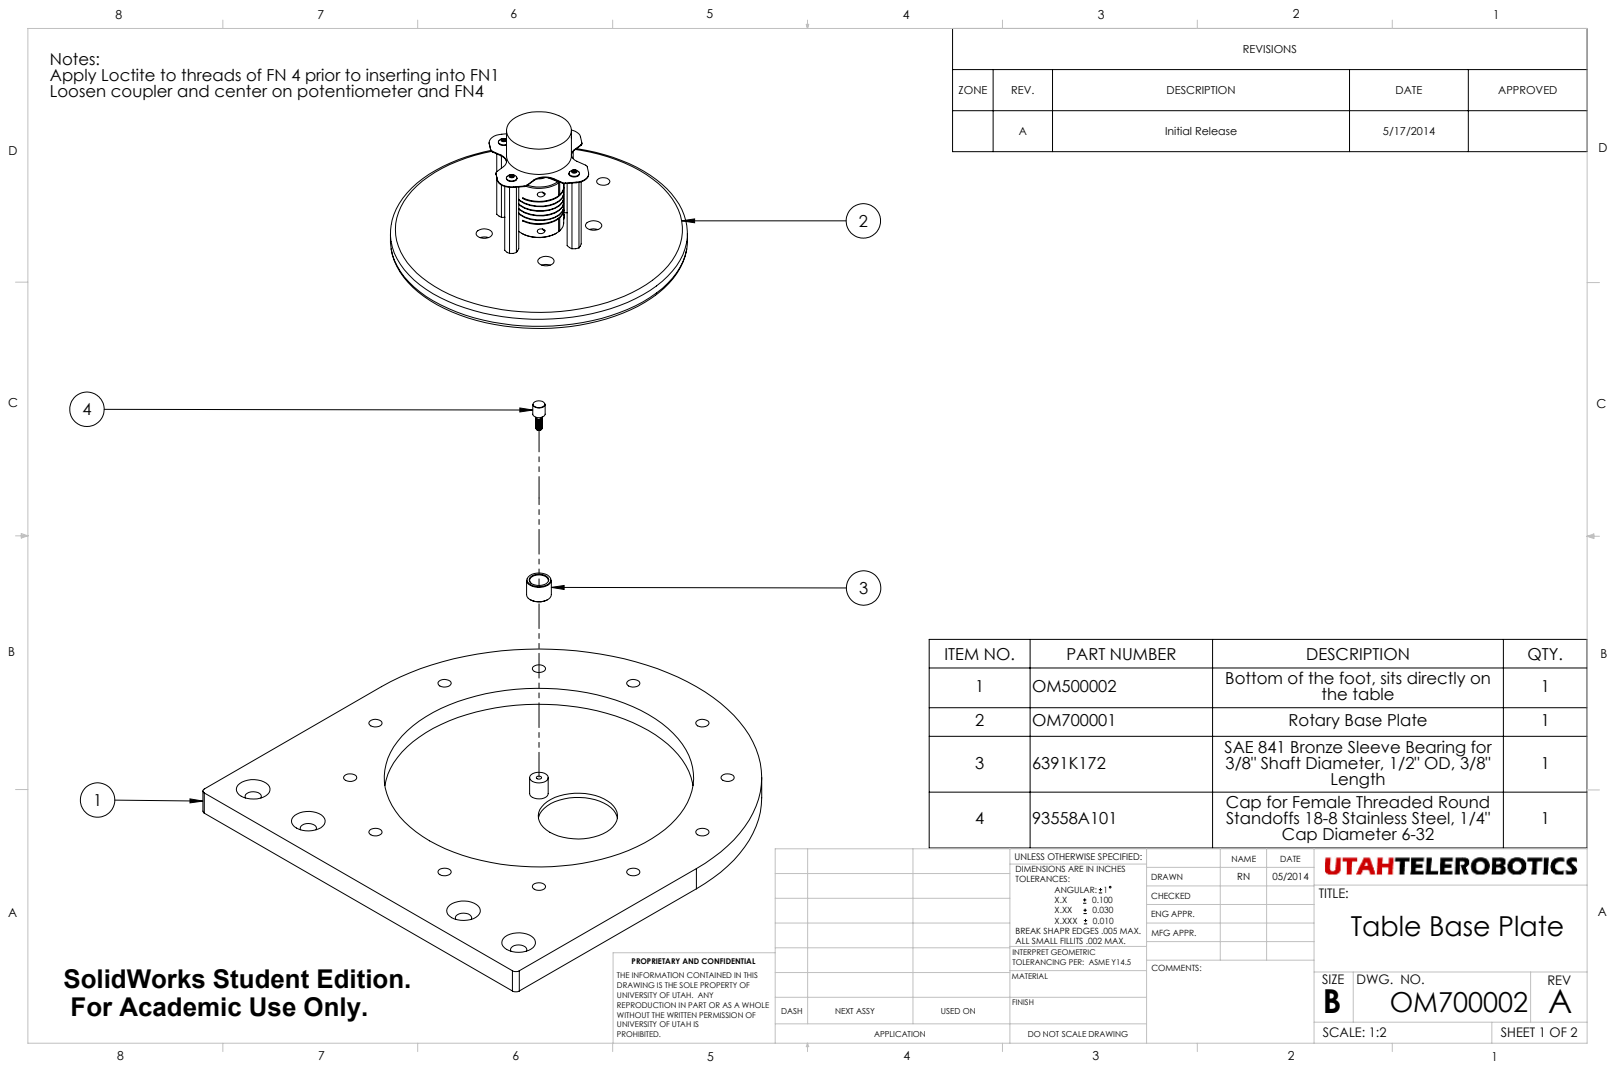
[picture p70: page 1]
NEXT ASSY; USED ON; ANGULAR: 1; ENG APPR.; DWG. NO.; REV; SCALE: 1:2; DO NOT SCALE DRAWING; SHEET 1 OF 2; MFG APPR.; Table Base Plate

Notes:
Apply Loctite to threads of FN 4 prior to inserting into FN1
Loosen coupler and center on potentiometer and FN4

ZONE | REV. | DESCRIPTION | DATE | APPROVED

A | Initial Release | 5/17/2014

ITEM NO. | PART NUMBER | DESCRIPTION | QTY.
1 | OM500002 | Bottom of the foot, sits directly on the table | 1
2 | OM700001 | Rotary Base Plate | 1
3 | 6391K172 | SAE 841 Bronze Sleeve Bearing for 3/8" Shaft Diameter, 1/2" OD, 3/8" Length | 1

4 | 93558A101 | Cap for Female Threaded Round Standoffs 18-8 Stainless Steel, 1/4" Cap Diameter 6-32 | 1

UNLESS OTHERWISE SPECIFIED:
DIMENSIONS ARE IN INCHES
TOLERANCES:

SolidWorks Student Edition.
For Academic Use Only.

BREAK SHAPR EDGES .005 MAX.
ALL SMALL FILLITS .002 MAX.
INTERPRET GEOMETRIC
TOLERANCING PER: ASME Y14.5
MATERIAL

PROPRIETARY AND CONFIDENTIAL
THE INFORMATION CONTAINED IN THIS
DRAWING IS THE SOLE PROPERTY OF
UNIVERSITY OF UTAH. ANY
REPRODUCTION IN PART OR AS A WHOLE
WITHOUT THE WRITTEN PERMISSION OF
UNIVERSITY OF UTAH IS
PROHIBITED.

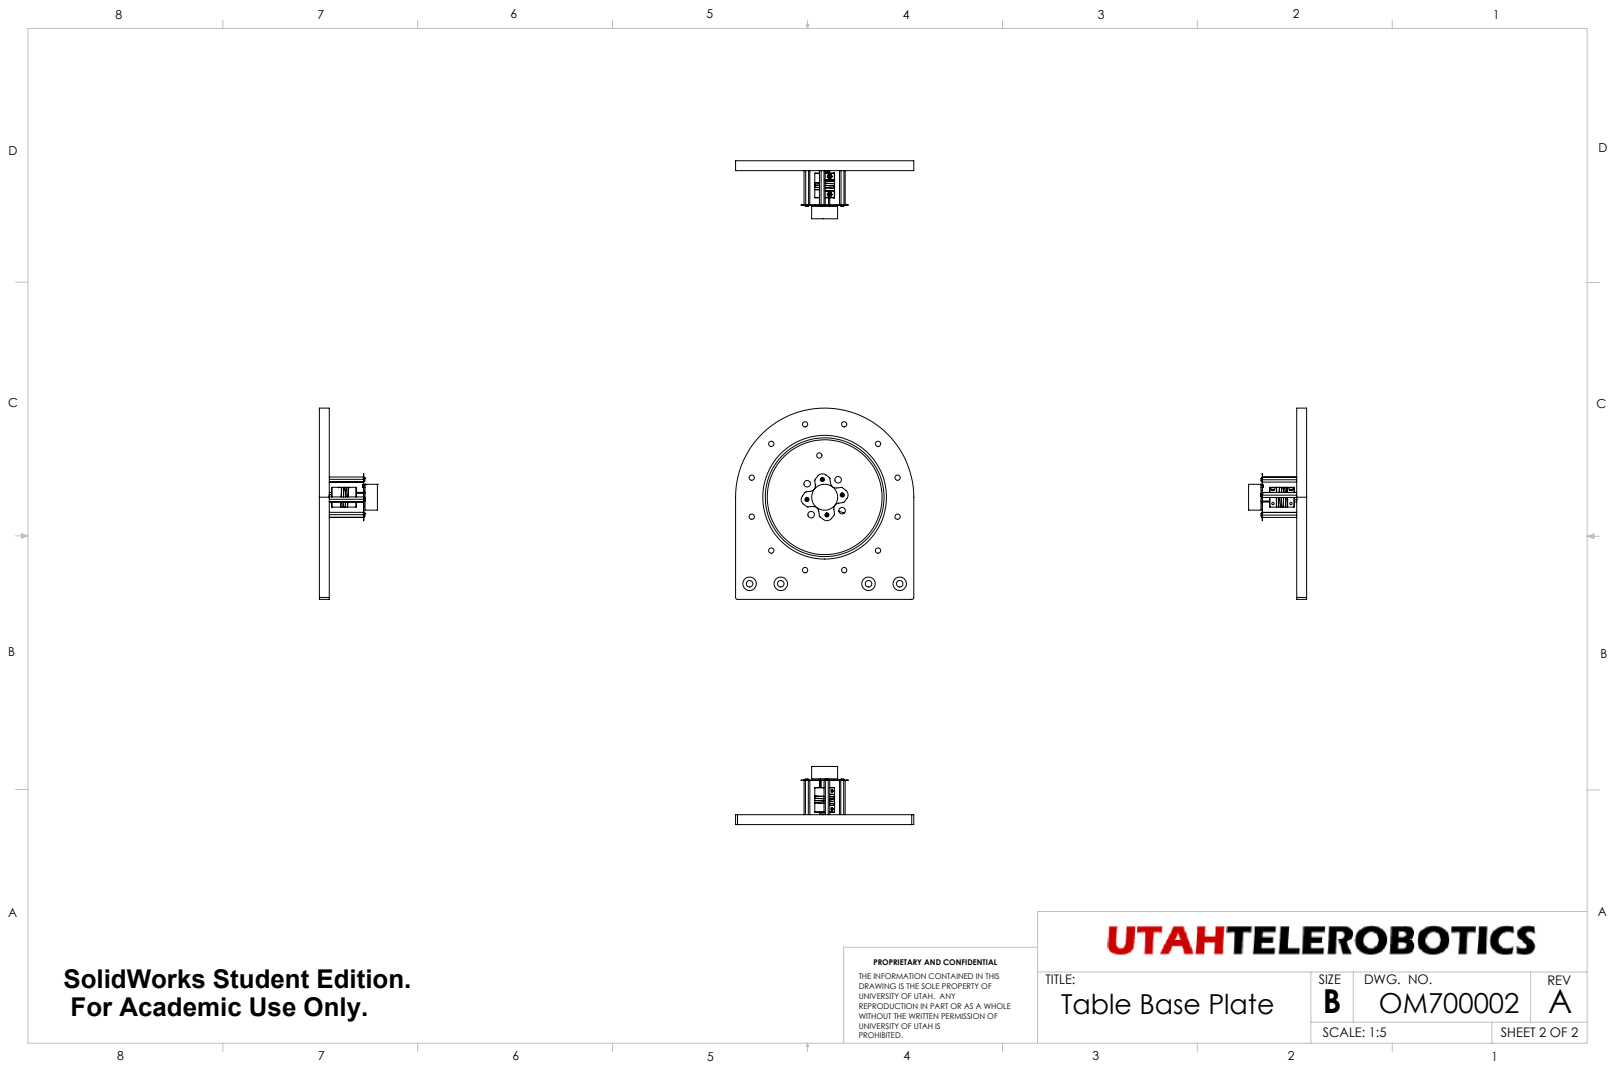
[picture p71: page 2]
DWG. NO.; REV; SCALE: 1:5; Table Base Plate; SHEET 2 OF 2

SolidWorks Student Edition.
For Academic Use Only.

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
