chazlambo/Omnimagnet/Solidworks/Arm Assembly/Assemblies/OM700003.PDF

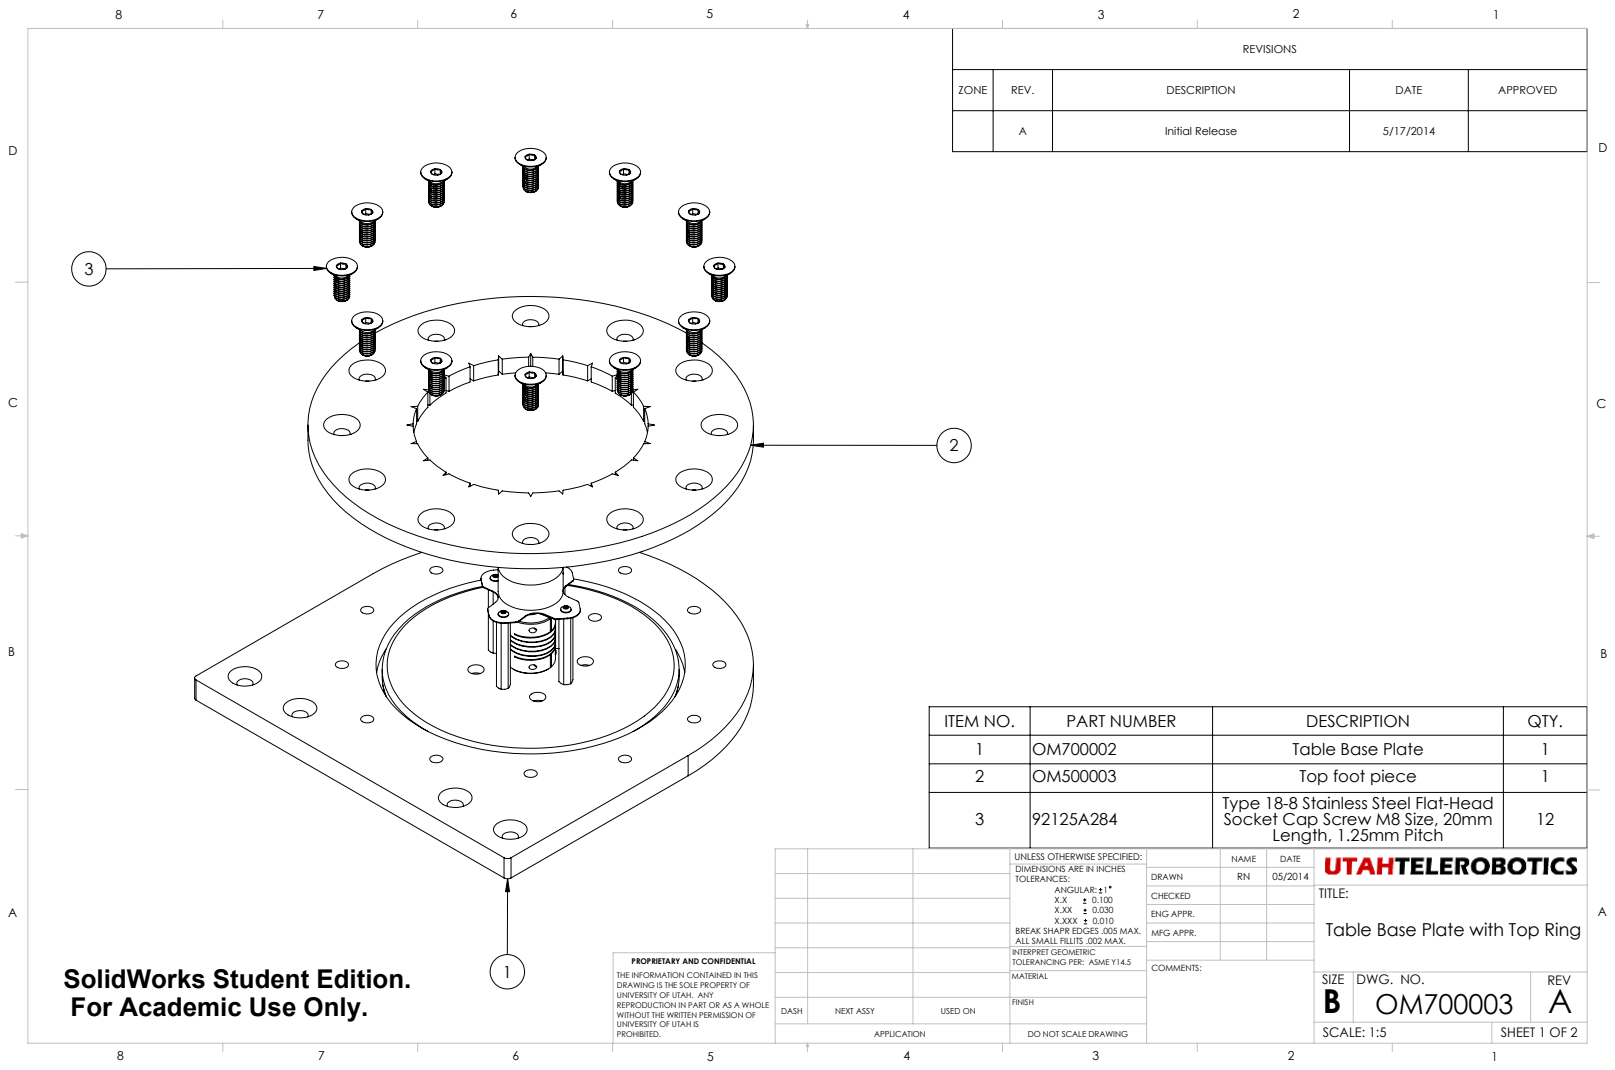
[picture p72: page 1]
NEXT ASSY; USED ON; ANGULAR: 1; ENG APPR.; DWG. NO.; REV; SCALE: 1:5; DO NOT SCALE DRAWING; SHEET 1 OF 2; MFG APPR.

ZONE | REV. | DESCRIPTION | DATE | APPROVED

A | Initial Release | 5/17/2014

ITEM NO. | PART NUMBER | DESCRIPTION | QTY.
1 | OM700002 | Table Base Plate | 1
2 | OM500003 | Top foot piece | 1
3 | 92125A284 | Type 18-8 Stainless Steel Flat-Head Socket Cap Screw M8 Size, 20mm Length, 1.25mm Pitch | 12

UNLESS OTHERWISE SPECIFIED:
DIMENSIONS ARE IN INCHES
TOLERANCES:

TITLE:
Table Base Plate with Top Ring

SolidWorks Student Edition.
For Academic Use Only.

BREAK SHAPR EDGES .005 MAX.
ALL SMALL FILLITS .002 MAX.
INTERPRET GEOMETRIC
TOLERANCING PER: ASME Y14.5
MATERIAL

PROPRIETARY AND CONFIDENTIAL
THE INFORMATION CONTAINED IN THIS
DRAWING IS THE SOLE PROPERTY OF
UNIVERSITY OF UTAH. ANY
REPRODUCTION IN PART OR AS A WHOLE
WITHOUT THE WRITTEN PERMISSION OF
UNIVERSITY OF UTAH IS
PROHIBITED.

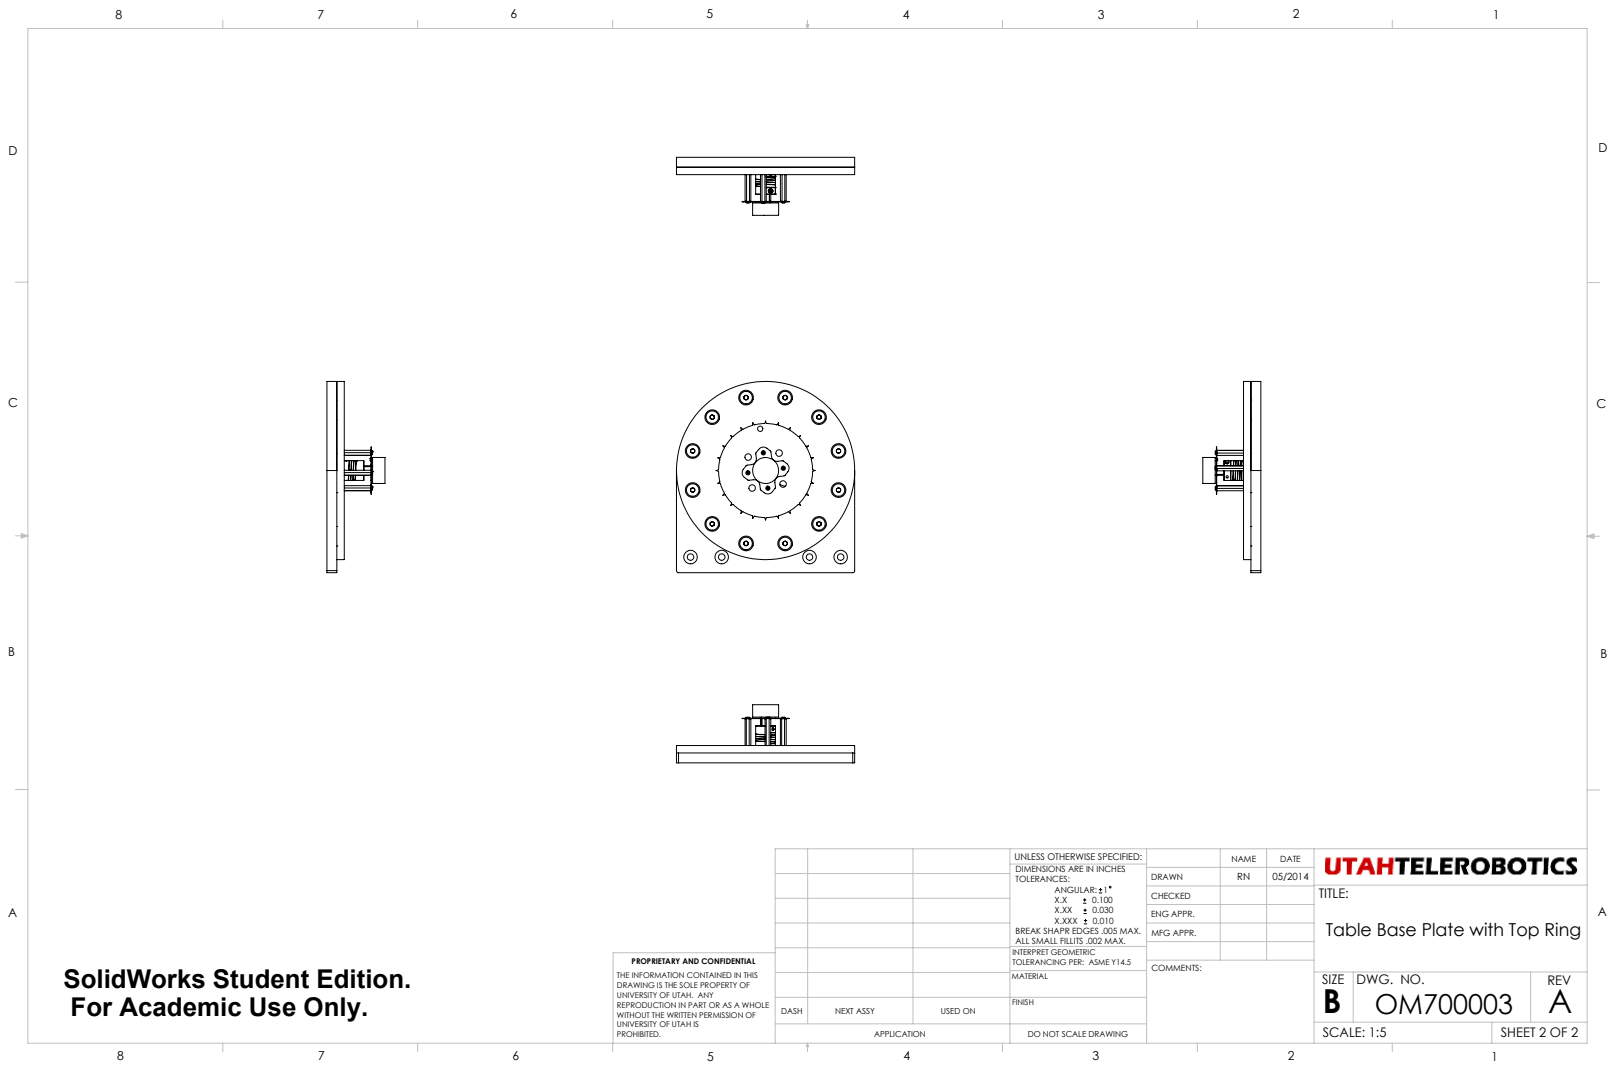
[picture p73: page 2]
NEXT ASSY; USED ON; ANGULAR: 1; ENG APPR.; DWG. NO.; REV; SCALE: 1:5; DO NOT SCALE DRAWING; SHEET 2 OF 2; MFG APPR.

UNLESS OTHERWISE SPECIFIED:
DIMENSIONS ARE IN INCHES
TOLERANCES:

TITLE:
Table Base Plate with Top Ring

SolidWorks Student Edition.
For Academic Use Only.

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
