chazlambo/Omnimagnet/Solidworks/Arm Assembly/Assemblies/OM700004.PDF

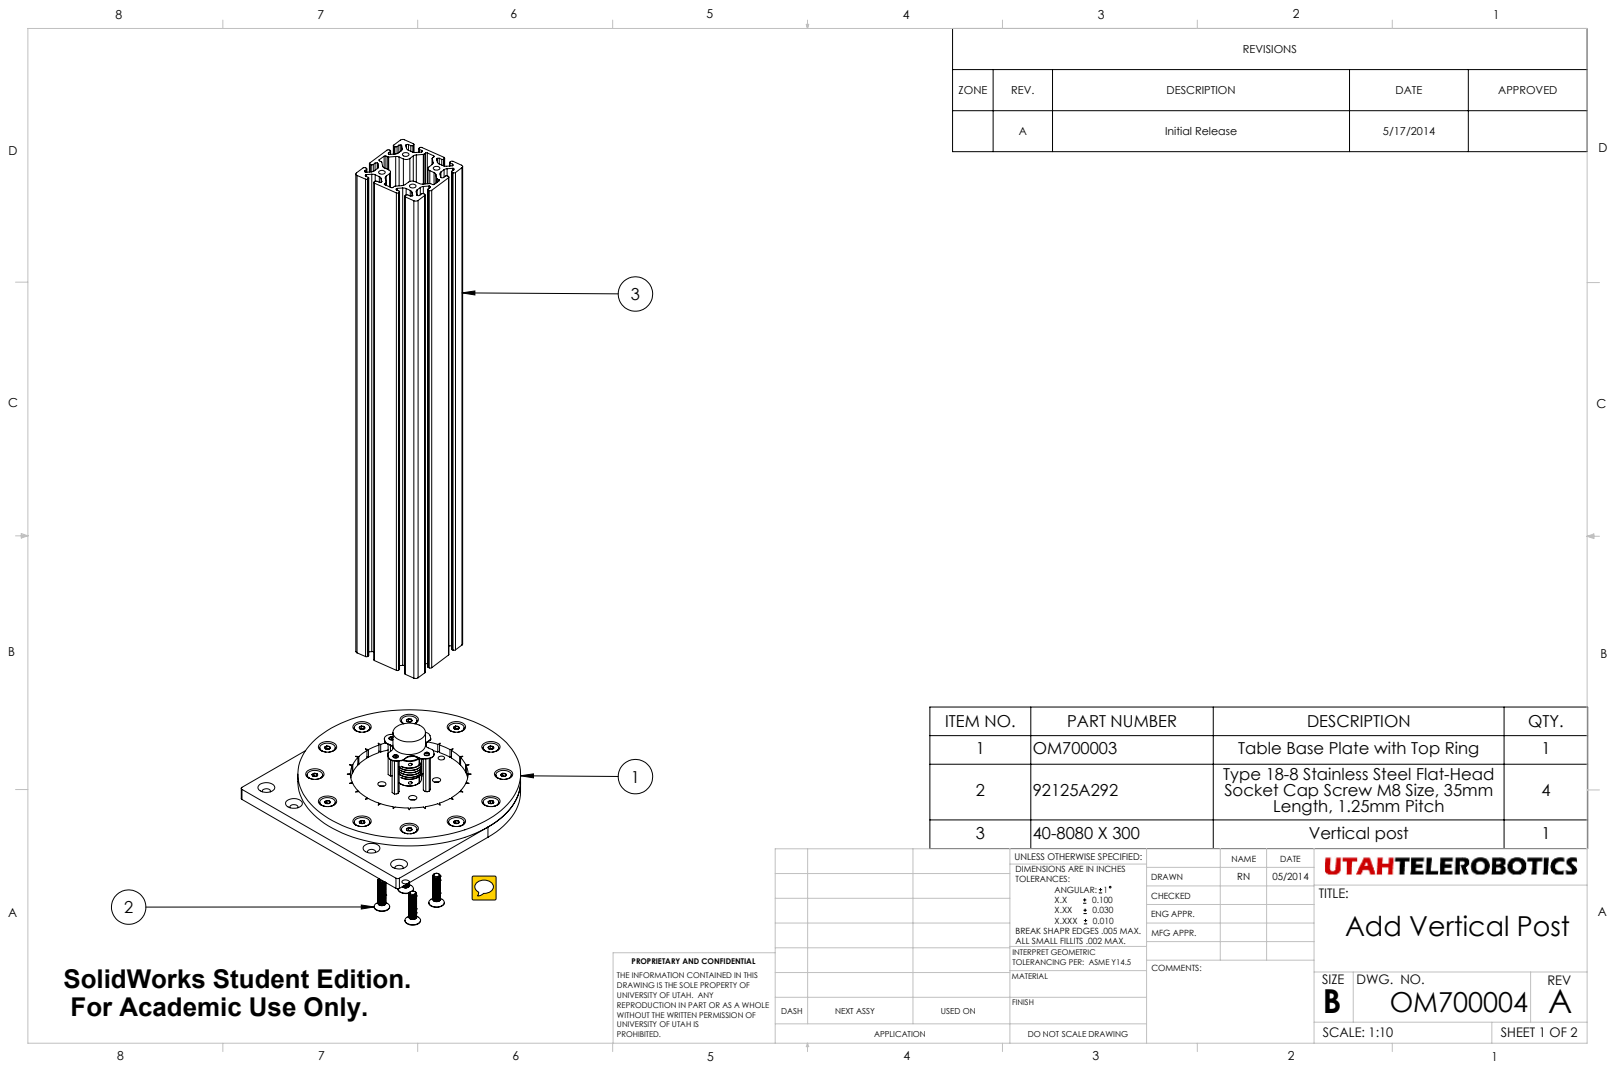
[picture p74: page 1]
NEXT ASSY; USED ON; ANGULAR: 1; ENG APPR.; DWG. NO.; REV; SCALE: 1:10; DO NOT SCALE DRAWING; SHEET 1 OF 2; MFG APPR.

ZONE | REV. | DESCRIPTION | DATE | APPROVED

A | Initial Release | 5/17/2014

ITEM NO. | PART NUMBER | DESCRIPTION | QTY.
1 | OM700003 | Table Base Plate with Top Ring | 1
2 | 92125A292 | Type 18-8 Stainless Steel Flat-Head Socket Cap Screw M8 Size, 35mm Length, 1.25mm Pitch | 4

3 | 40-8080 X 300 | Vertical post | 1

UNLESS OTHERWISE SPECIFIED:
DIMENSIONS ARE IN INCHES
TOLERANCES:

Add Vertical Post

SolidWorks Student Edition.
For Academic Use Only.

BREAK SHAPR EDGES .005 MAX.
ALL SMALL FILLITS .002 MAX.
INTERPRET GEOMETRIC
TOLERANCING PER: ASME Y14.5
MATERIAL

PROPRIETARY AND CONFIDENTIAL
THE INFORMATION CONTAINED IN THIS
DRAWING IS THE SOLE PROPERTY OF
UNIVERSITY OF UTAH. ANY
REPRODUCTION IN PART OR AS A WHOLE
WITHOUT THE WRITTEN PERMISSION OF
UNIVERSITY OF UTAH IS
PROHIBITED.

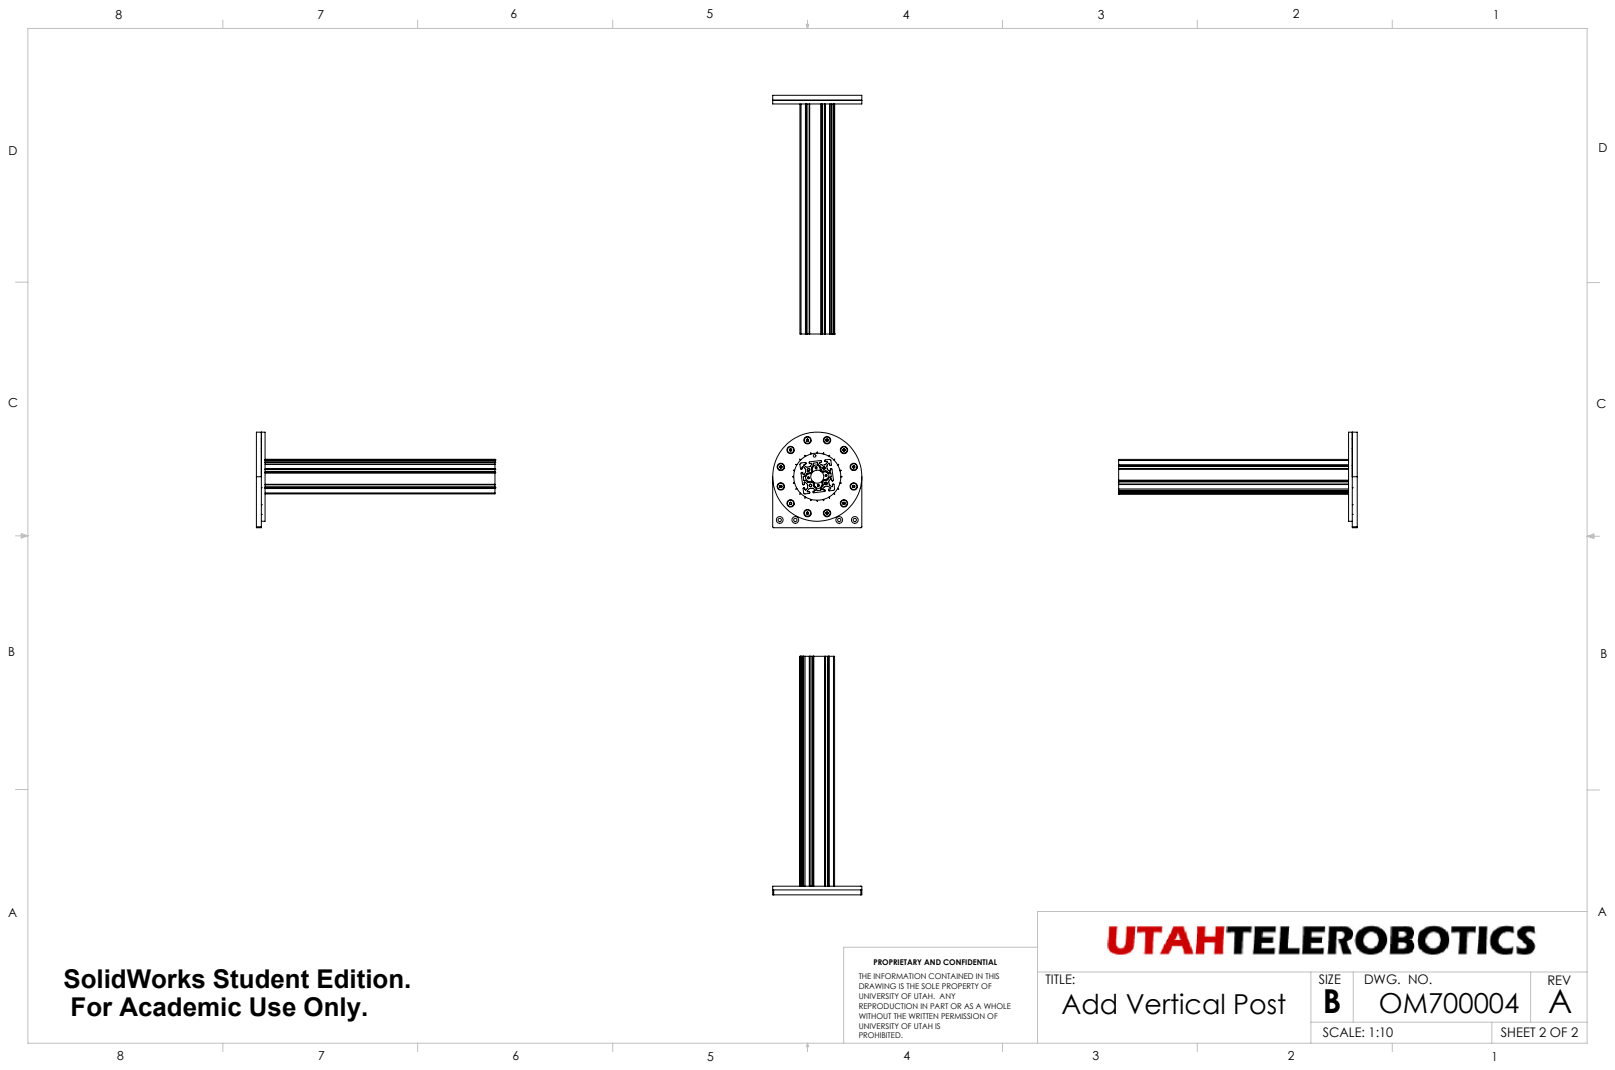
[picture p75: page 2]
DWG. NO.; REV; SCALE: 1:10; Add Vertical Post; SHEET 2 OF 2

SolidWorks Student Edition.
For Academic Use Only.

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
