chazlambo/Omnimagnet/Solidworks/Arm Assembly/Assemblies/OM700005.PDF

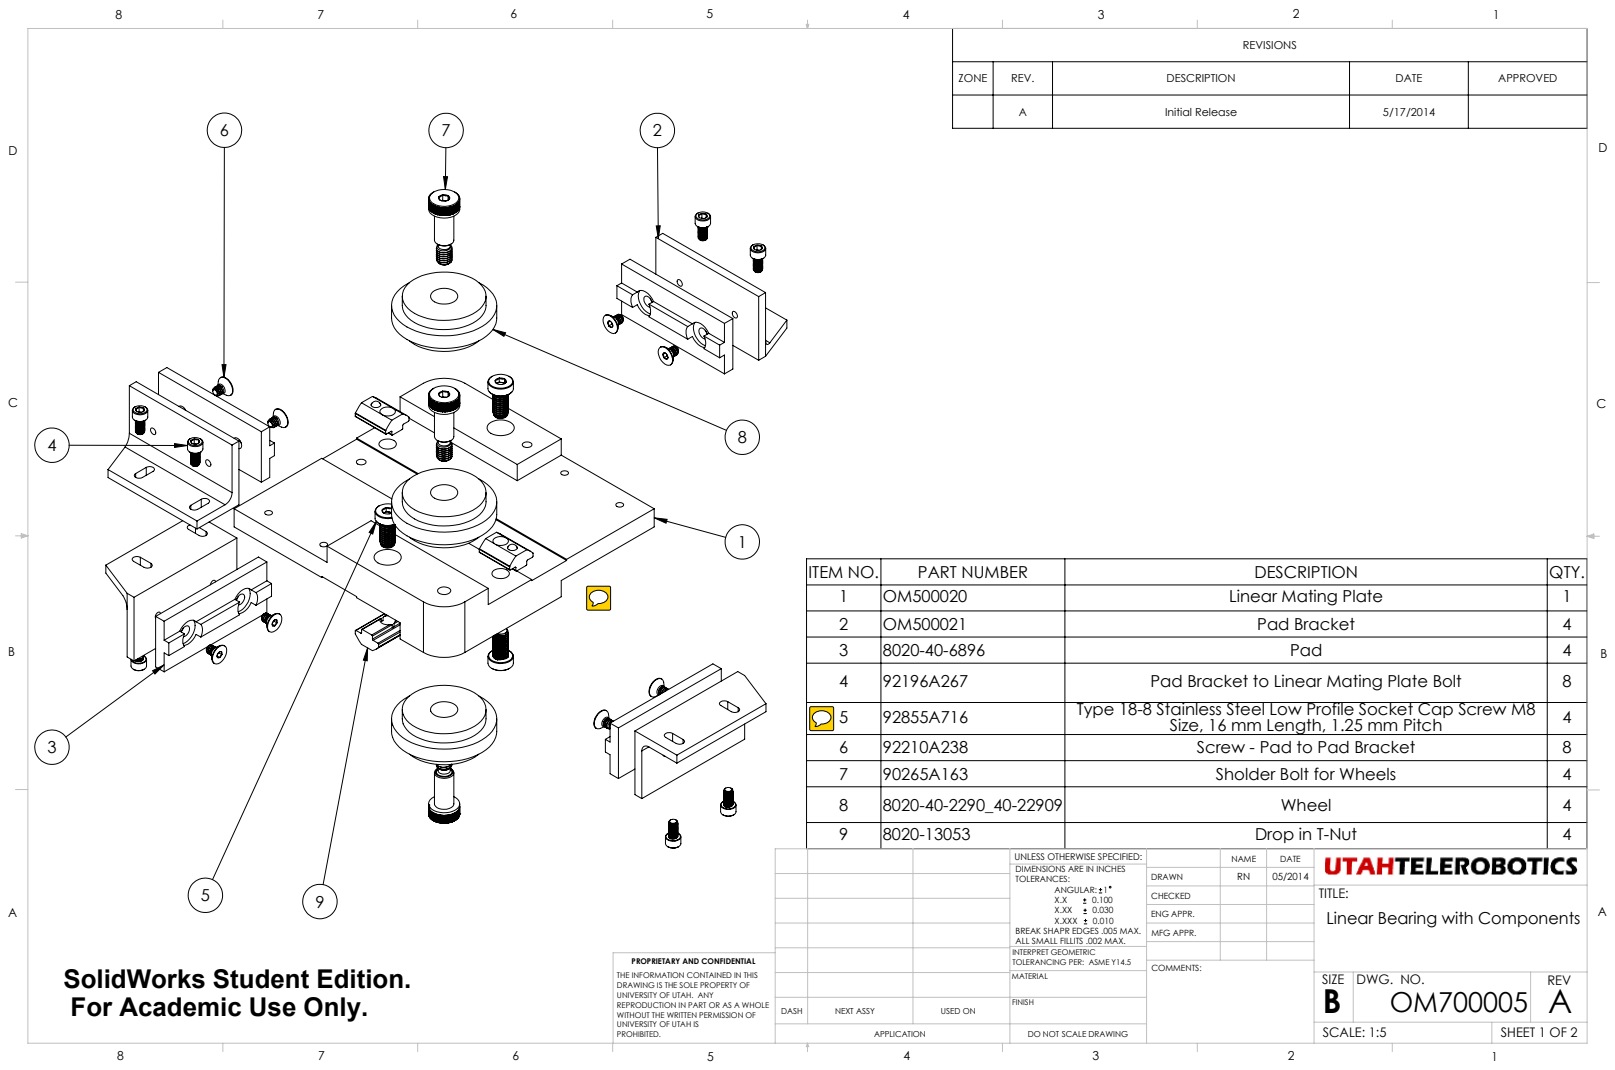
[picture p76: page 1]
NEXT ASSY; USED ON; ANGULAR: 1; ENG APPR.; DWG. NO.; REV; SCALE: 1:5; DO NOT SCALE DRAWING; SHEET 1 OF 2; MFG APPR.

ZONE | REV. | DESCRIPTION | DATE | APPROVED

A | Initial Release | 5/17/2014

ITEM NO. | PART NUMBER | DESCRIPTION | QTY.
1 | OM500020 | Linear Mating Plate | 1
2 | OM500021 | Pad Bracket | 4
3 | 8020-40-6896 | Pad | 4
4 | 92196A267 | Pad Bracket to Linear Mating Plate Bolt | 8
5 | 92855A716 | Type 18-8 Stainless Steel Low Profile Socket Cap Screw M8 Size, 16 mm Length, 1.25 mm Pitch | 4
6 | 92210A238 | Screw - Pad to Pad Bracket | 8
7 | 90265A163 | Sholder Bolt for Wheels | 4
8 | 8020-40-2290_40-22909 | Wheel | 4
9 | 8020-13053 | Drop in T-Nut | 4

UNLESS OTHERWISE SPECIFIED:
DIMENSIONS ARE IN INCHES
TOLERANCES:

TITLE:
Linear Bearing with Components

SolidWorks Student Edition.
For Academic Use Only.

BREAK SHAPR EDGES .005 MAX.
ALL SMALL FILLITS .002 MAX.
INTERPRET GEOMETRIC
TOLERANCING PER: ASME Y14.5
MATERIAL

PROPRIETARY AND CONFIDENTIAL
THE INFORMATION CONTAINED IN THIS
DRAWING IS THE SOLE PROPERTY OF
UNIVERSITY OF UTAH. ANY
REPRODUCTION IN PART OR AS A WHOLE
WITHOUT THE WRITTEN PERMISSION OF
UNIVERSITY OF UTAH IS
PROHIBITED.

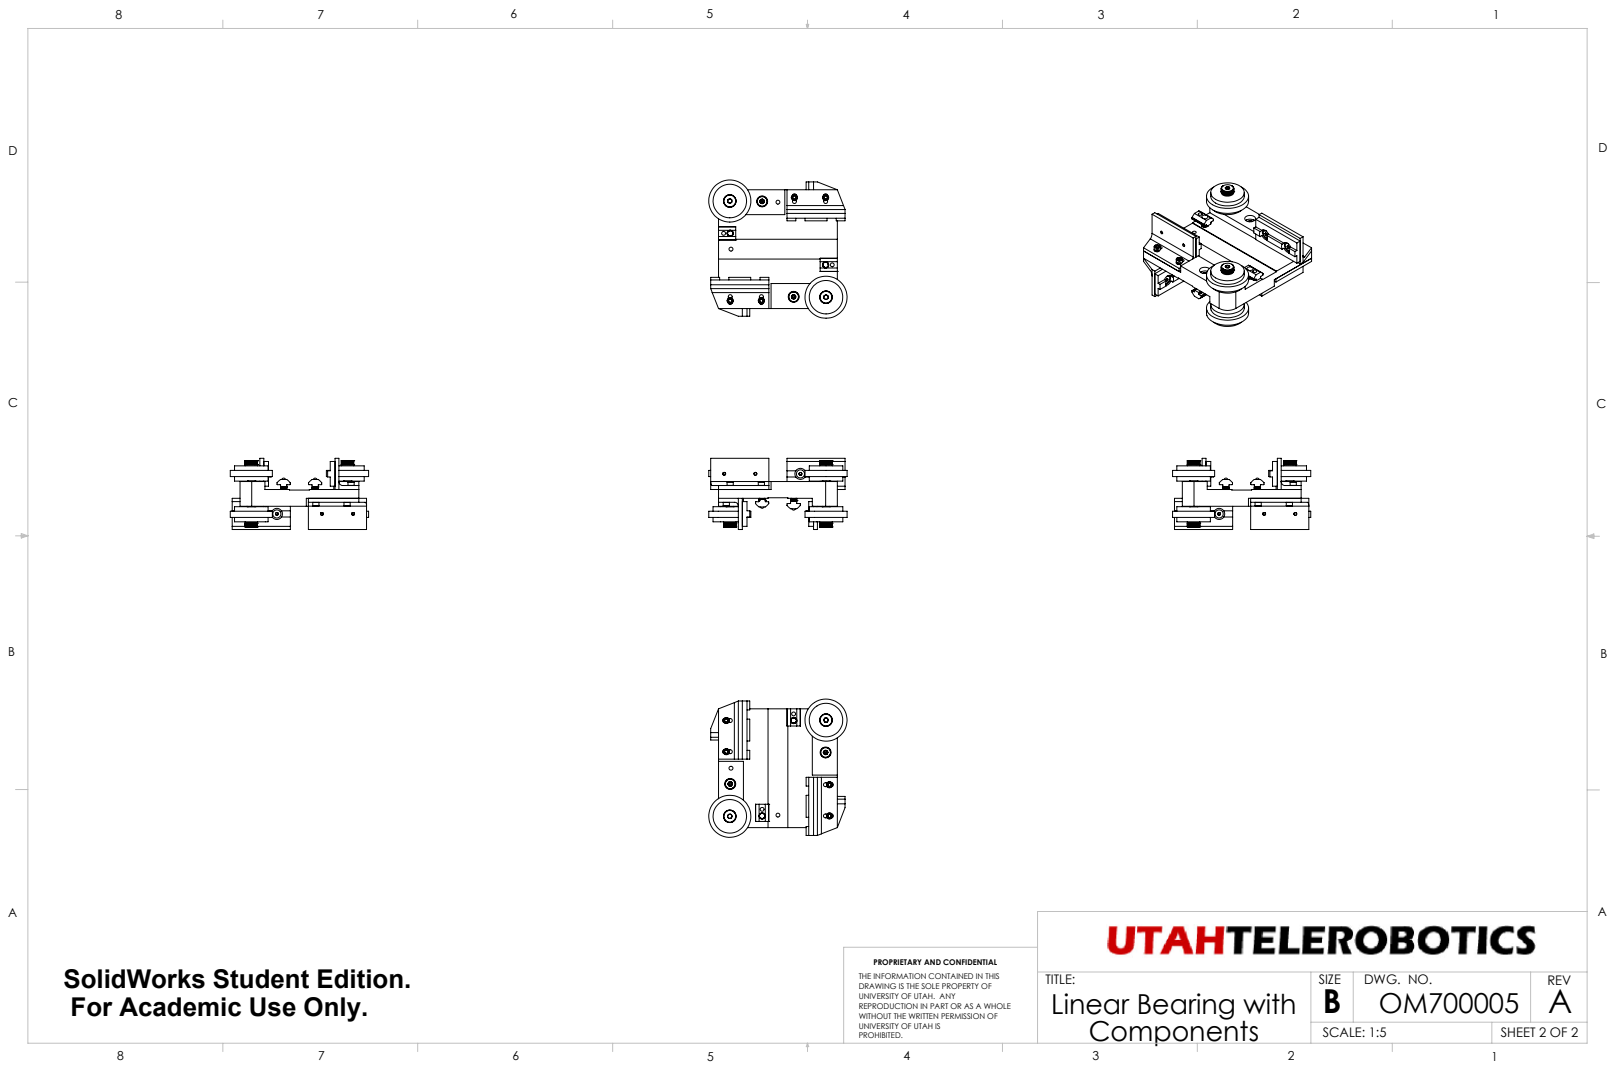
[picture p77: page 2]
DWG. NO.; REV; SCALE: 1:5; Linear Bearing with; Components; SHEET 2 OF 2

SolidWorks Student Edition.
For Academic Use Only.

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
