chazlambo/Omnimagnet/Solidworks/Arm Assembly/Assemblies/OM700008.PDF

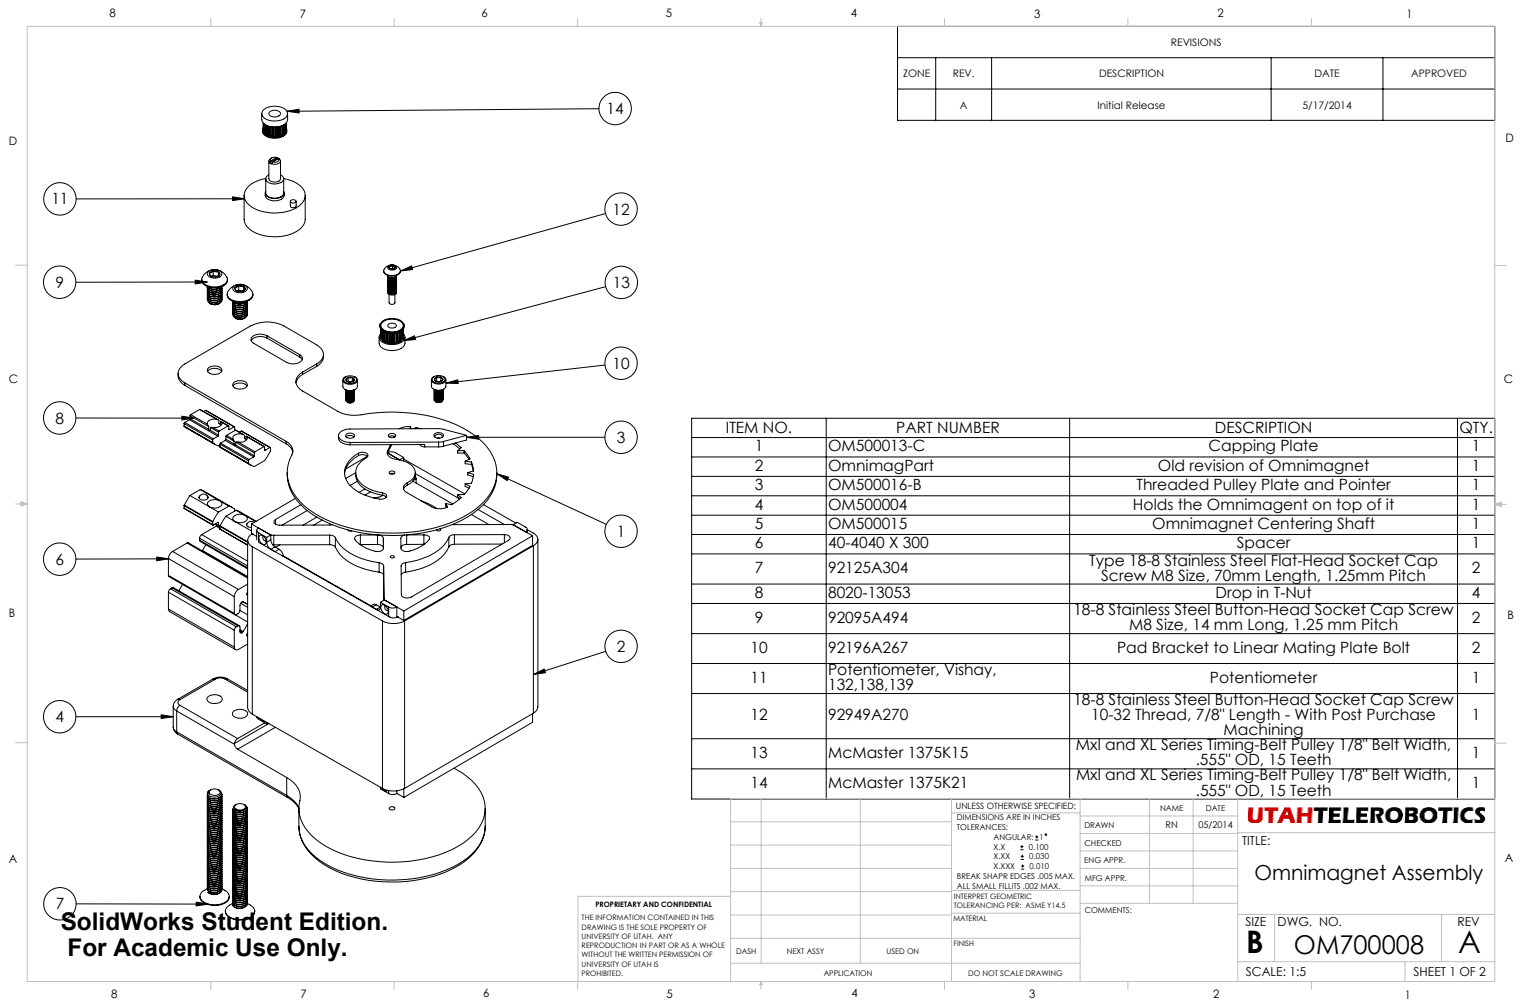
[picture p80: page 1]
NEXT ASSY; USED ON; ANGULAR: 1; ENG APPR.; DWG. NO.; REV; SCALE: 1:5; DO NOT SCALE DRAWING; SHEET 1 OF 2; MFG APPR.; Omnimagnet Assembly

ZONE | REV. | DESCRIPTION | DATE | APPROVED

A | Initial Release | 5/17/2014

ITEM NO. | PART NUMBER | DESCRIPTION | QTY.
1 | OM500013-C | Capping Plate | 1
2 | OmnimagPart | Old revision of Omnimagnet | 1
3 | OM500016-B | Threaded Pulley Plate and Pointer | 1
4 | OM500004 | Holds the Omnimagent on top of it | 1
5 | OM500015 | Omnimagnet Centering Shaft | 1
6 | 40-4040 X 300 | Spacer | 1
7 | 92125A304 | Type 18-8 Stainless Steel Flat-Head Socket Cap Screw M8 Size, 70mm Length, 1.25mm Pitch | 2
8 | 8020-13053 | Drop in T-Nut | 4
9 | 92095A494 | 18-8 Stainless Steel Button-Head Socket Cap Screw M8 Size, 14 mm Long, 1.25 mm Pitch | 2
10 | 92196A267 | Pad Bracket to Linear Mating Plate Bolt | 2
11 | Potentiometer, Vishay, 132,138,139 | Potentiometer | 1
12 | 92949A270 | 18-8 Stainless Steel Button-Head Socket Cap Screw 10-32 Thread, 7/8" Length - With Post Purchase Machining | 1

13 | McMaster 1375K15 | Mxl and XL Series Timing-Belt Pulley 1/8" Belt Width, .555" OD, 15 Teeth | 1
14 | McMaster 1375K21 | Mxl and XL Series Timing-Belt Pulley 1/8" Belt Width, .555" OD, 15 Teeth | 1

UNLESS OTHERWISE SPECIFIED:
DIMENSIONS ARE IN INCHES
TOLERANCES:

SolidWorks Student Edition.
For Academic Use Only.

BREAK SHAPR EDGES .005 MAX.
ALL SMALL FILLITS .002 MAX.
INTERPRET GEOMETRIC
TOLERANCING PER: ASME Y14.5
MATERIAL

PROPRIETARY AND CONFIDENTIAL
THE INFORMATION CONTAINED IN THIS
DRAWING IS THE SOLE PROPERTY OF
UNIVERSITY OF UTAH. ANY
REPRODUCTION IN PART OR AS A WHOLE
WITHOUT THE WRITTEN PERMISSION OF
UNIVERSITY OF UTAH IS
PROHIBITED.

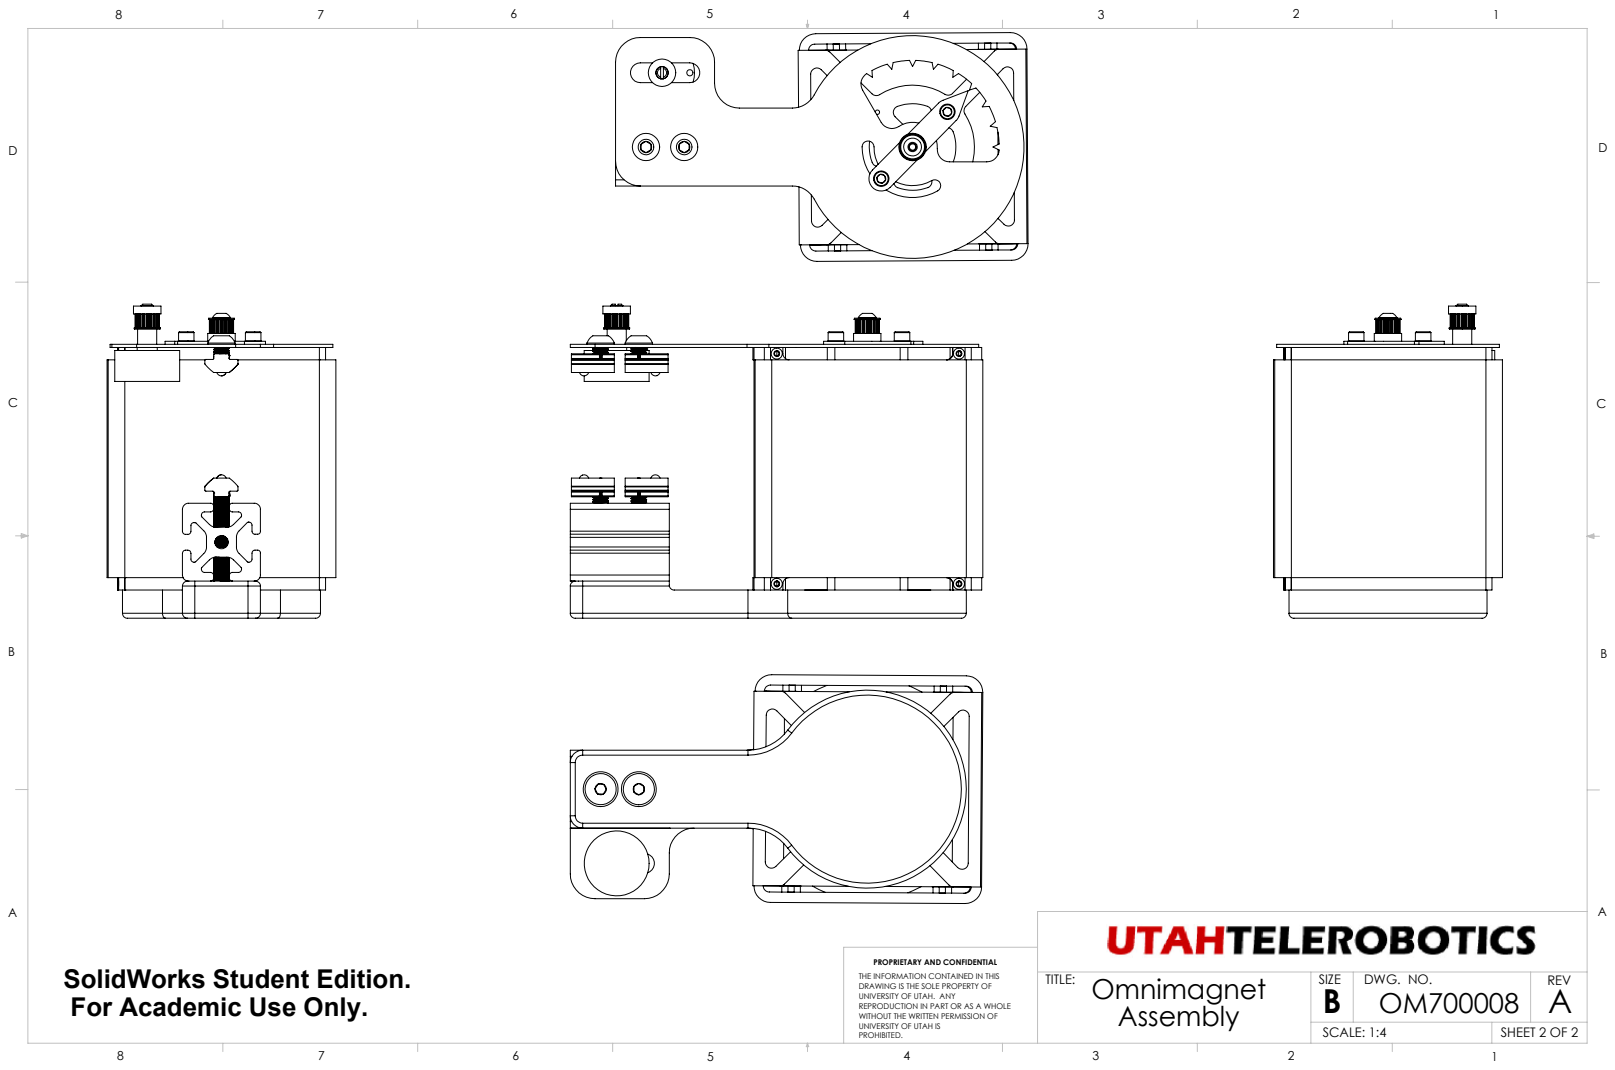
[picture p81: page 2]
DWG. NO.; REV; SCALE: 1:4; A Omnimagnet; Assembly; SHEET 2 OF 2

SolidWorks Student Edition.
For Academic Use Only.

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
