chazlambo/Omnimagnet/Solidworks/Arm Assembly/Assemblies/OM700010.PDF

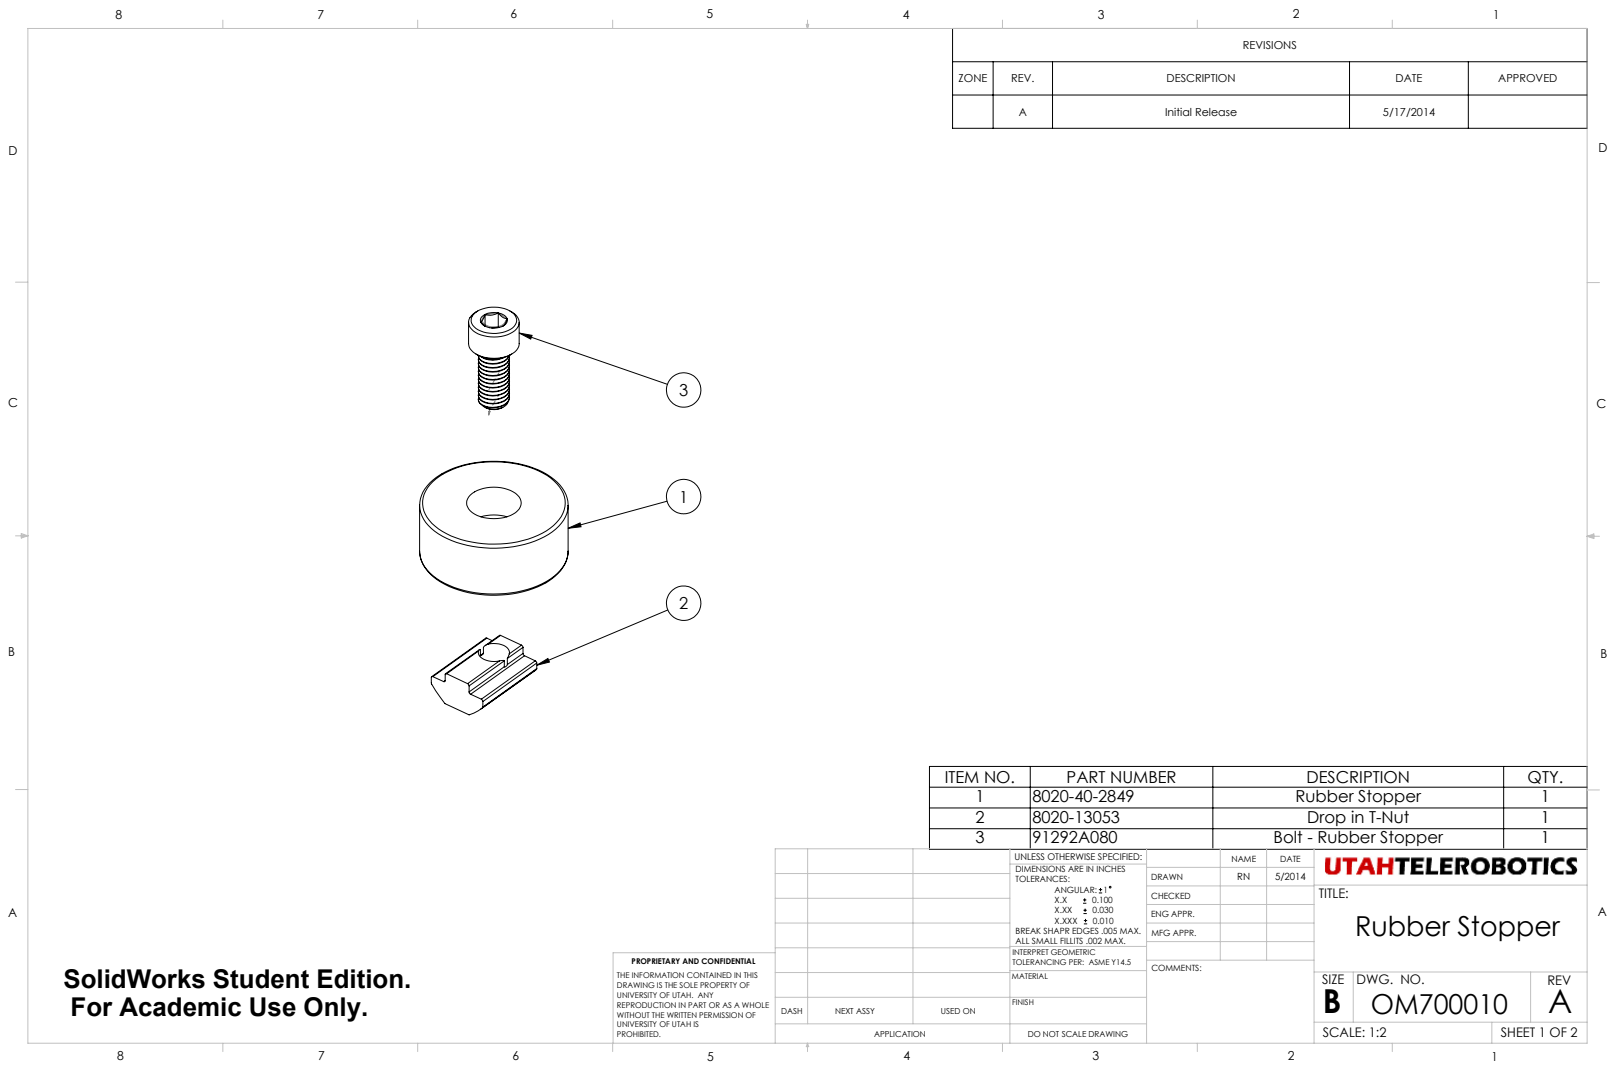
[picture p84: page 1]
NEXT ASSY; USED ON; ANGULAR: 1; ENG APPR.; DWG. NO.; REV; SCALE: 1:2; DO NOT SCALE DRAWING; SHEET 1 OF 2; MFG APPR.; Rubber Stopper

ZONE | REV. | DESCRIPTION | DATE | APPROVED

A | Initial Release | 5/17/2014

ITEM NO. | PART NUMBER | DESCRIPTION | QTY.
1 | 8020-40-2849 | Rubber Stopper | 1
2 | 8020-13053 | Drop in T-Nut | 1
3 | 91292A080 | Bolt - Rubber Stopper | 1

UNLESS OTHERWISE SPECIFIED:
DIMENSIONS ARE IN INCHES
TOLERANCES:

SolidWorks Student Edition.
For Academic Use Only.

BREAK SHAPR EDGES .005 MAX.
ALL SMALL FILLITS .002 MAX.
INTERPRET GEOMETRIC
TOLERANCING PER: ASME Y14.5
MATERIAL

PROPRIETARY AND CONFIDENTIAL
THE INFORMATION CONTAINED IN THIS
DRAWING IS THE SOLE PROPERTY OF
UNIVERSITY OF UTAH. ANY
REPRODUCTION IN PART OR AS A WHOLE
WITHOUT THE WRITTEN PERMISSION OF
UNIVERSITY OF UTAH IS
PROHIBITED.

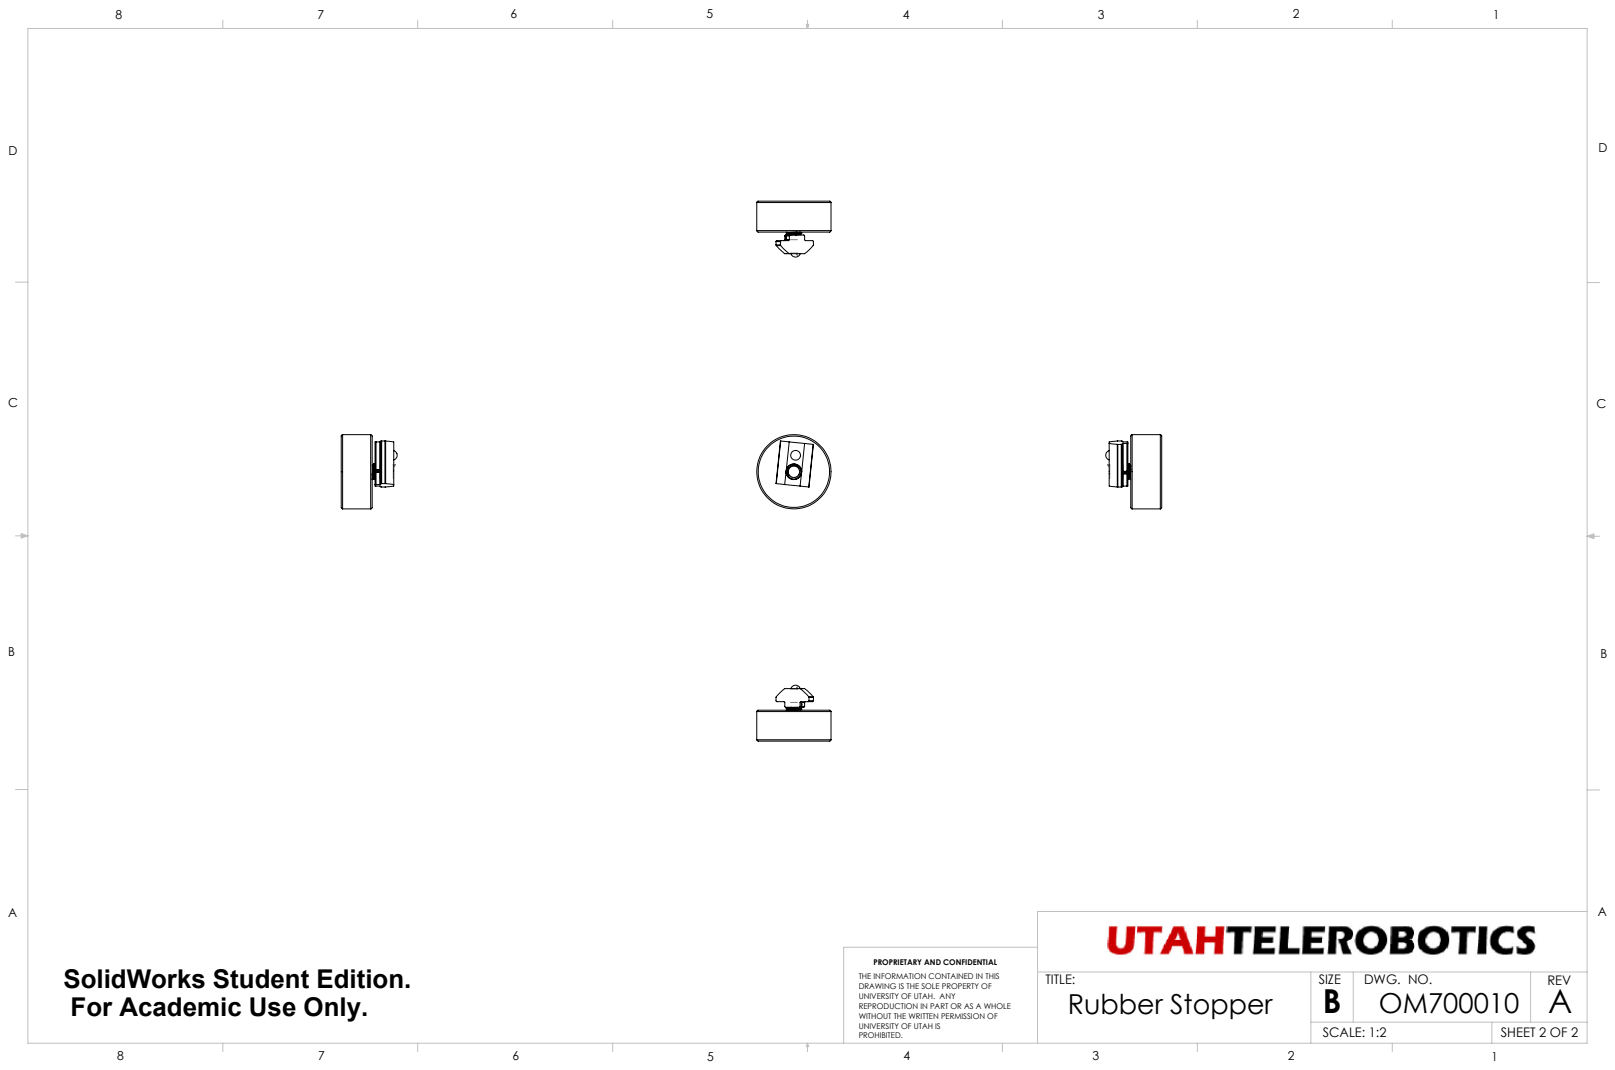
[picture p85: page 2]
DWG. NO.; REV; SCALE: 1:2; Rubber Stopper; SHEET 2 OF 2

SolidWorks Student Edition.
For Academic Use Only.

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
