chazlambo/Omnimagnet/Solidworks/Arm Assembly/Assemblies/OM700011.PDF

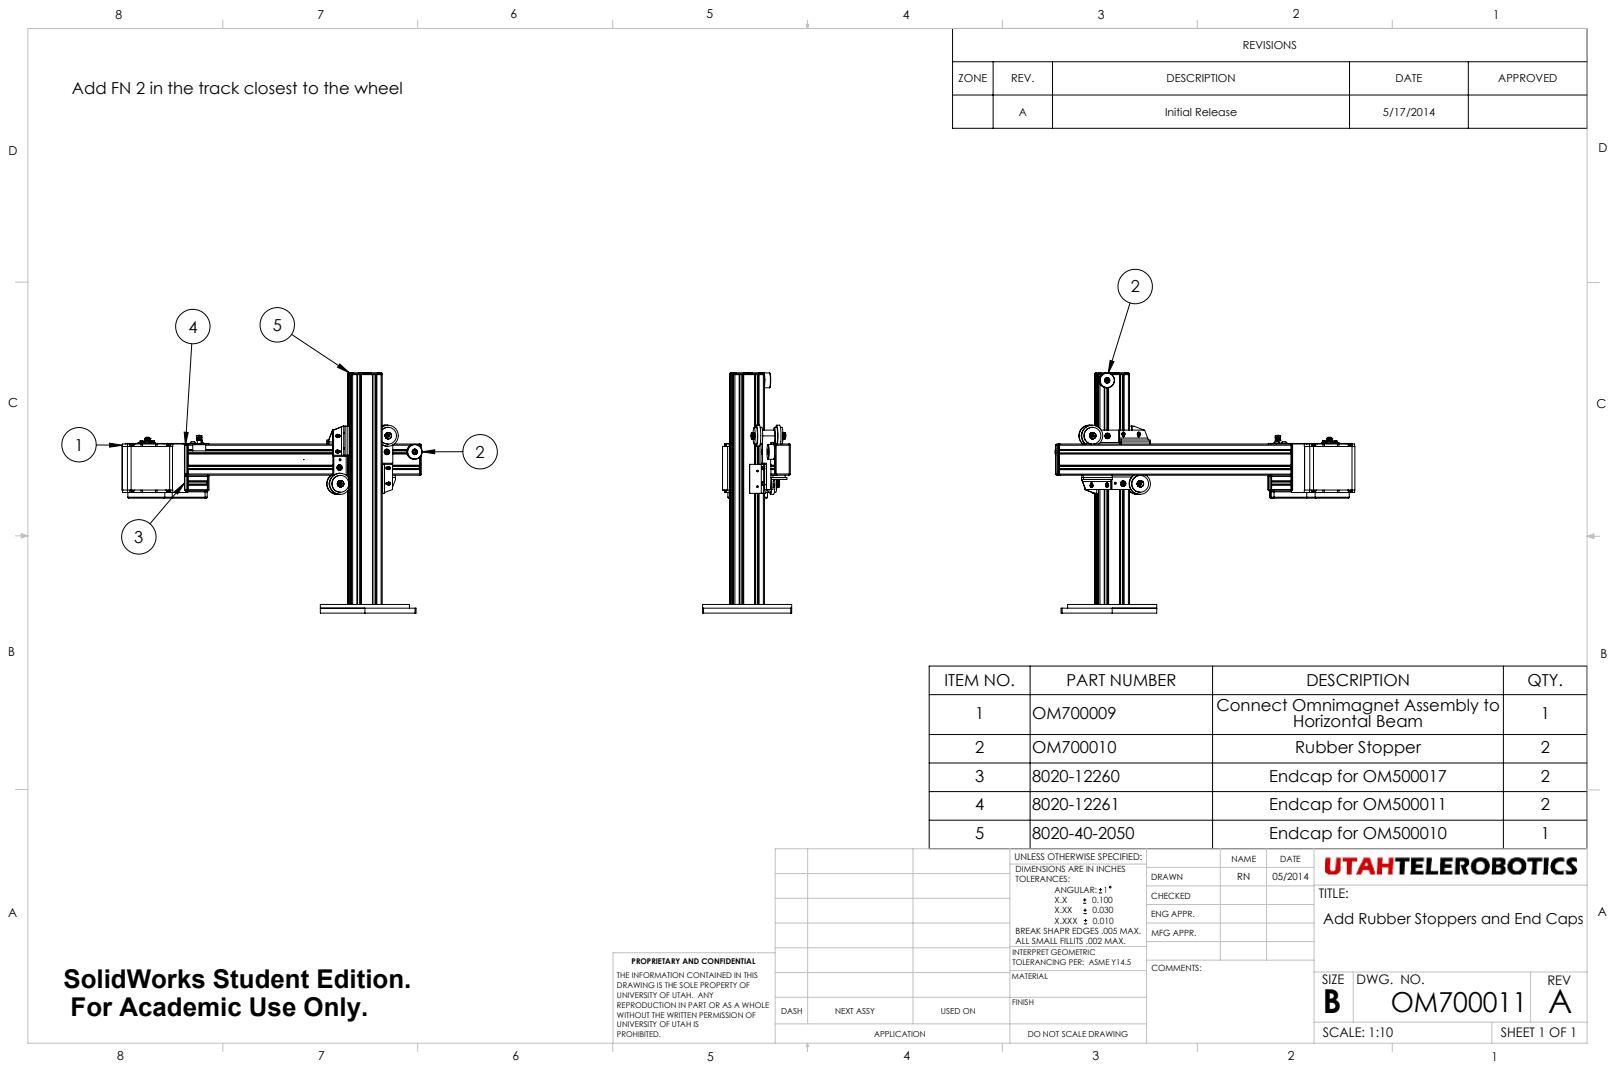
[picture p86: page 1]
NEXT ASSY; USED ON; ANGULAR: 1; ENG APPR.; DWG. NO.; REV; SCALE: 1:10; DO NOT SCALE DRAWING; SHEET 1 OF 1; MFG APPR.

ZONE | REV. | DESCRIPTION | DATE | APPROVED

Add FN 2 in the track closest to the wheel

A | Initial Release | 5/17/2014

ITEM NO. | PART NUMBER | DESCRIPTION | QTY.
1 | OM700009 | Connect Omnimagnet Assembly to Horizontal Beam | 1
2 | OM700010 | Rubber Stopper | 2
3 | 8020-12260 | Endcap for OM500017 | 2
4 | 8020-12261 | Endcap for OM500011 | 2
5 | 8020-40-2050 | Endcap for OM500010 | 1

UNLESS OTHERWISE SPECIFIED:
DIMENSIONS ARE IN INCHES
TOLERANCES:

TITLE:
Add Rubber Stoppers and End Caps

SolidWorks Student Edition.
For Academic Use Only.

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
