chazlambo/Omnimagnet/Solidworks/Arm Assembly/Assemblies/OM700012.PDF

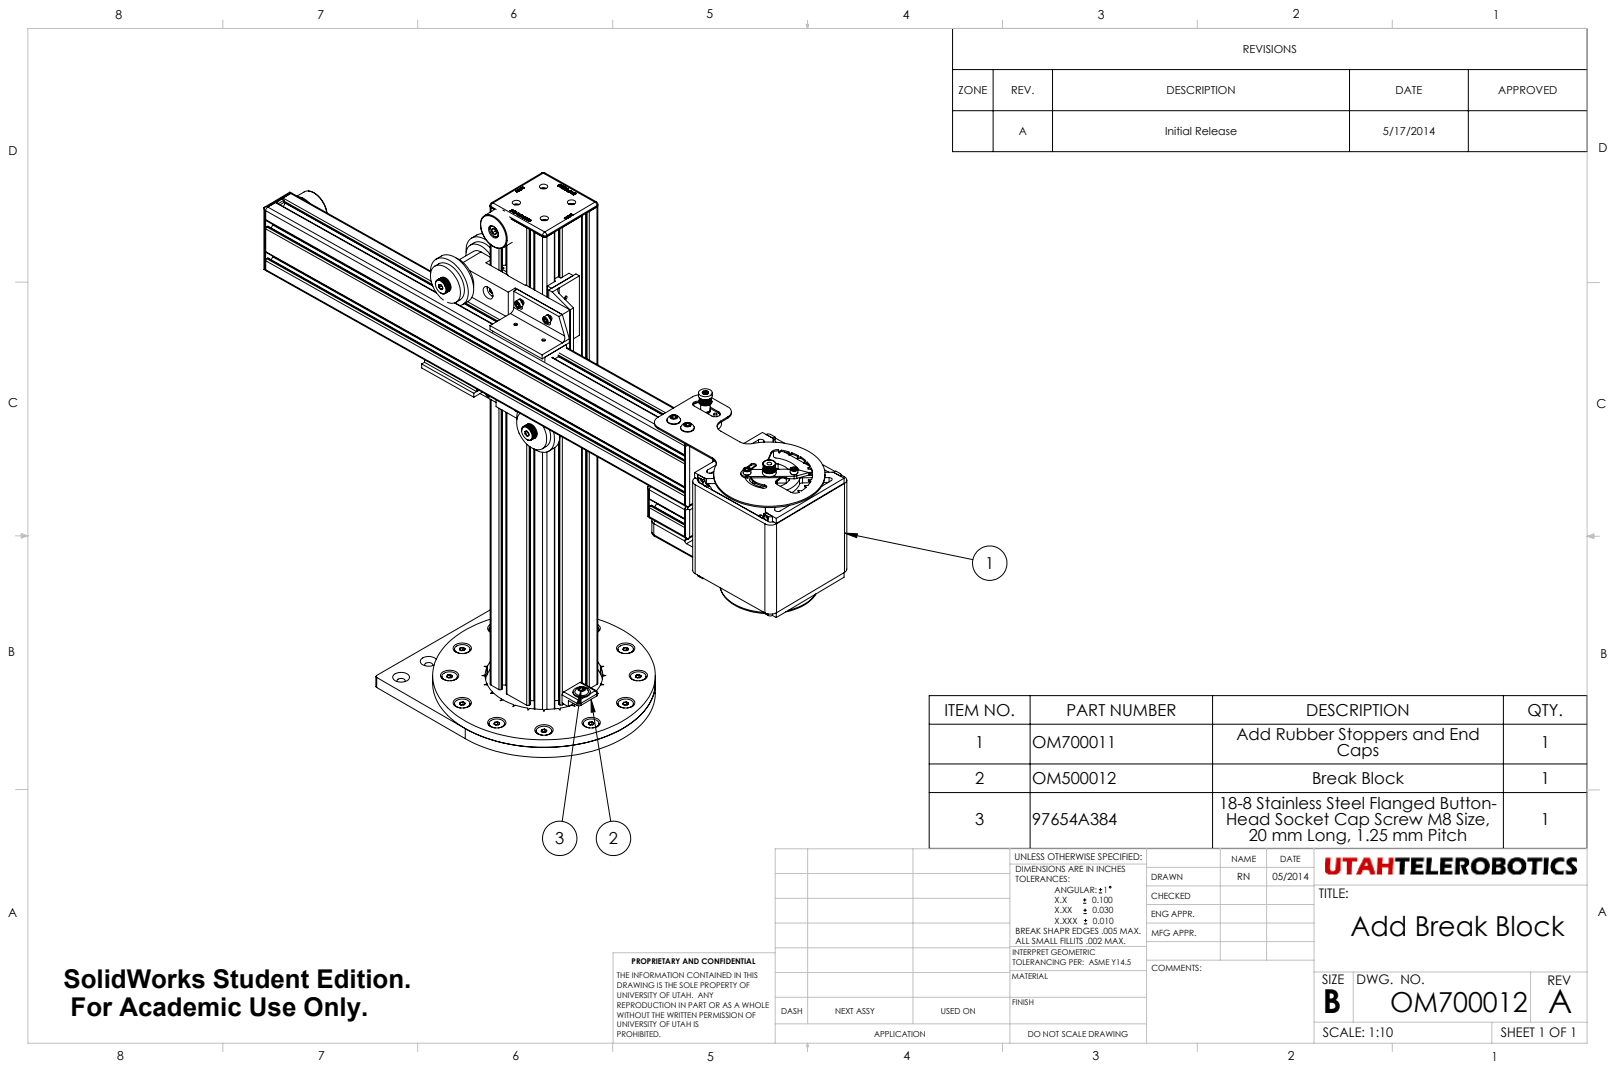
[picture p87: page 1]
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

ZONE | REV. | DESCRIPTION | DATE | APPROVED

A | Initial Release | 5/17/2014

ITEM NO. | PART NUMBER | DESCRIPTION | QTY.
1 | OM700011 | Add Rubber Stoppers and End Caps | 1

2 | OM500012 | Break Block | 1
3 | 97654A384 | 18-8 Stainless Steel Flanged Button-Head Socket Cap Screw M8 Size, 20 mm Long, 1.25 mm Pitch | 1

UNLESS OTHERWISE SPECIFIED:
DIMENSIONS ARE IN INCHES
TOLERANCES:

Add Break Block

SolidWorks Student Edition.
For Academic Use Only.

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
