chazlambo/Omnimagnet/Solidworks/Arm Assembly/Assemblies/OM700013.PDF

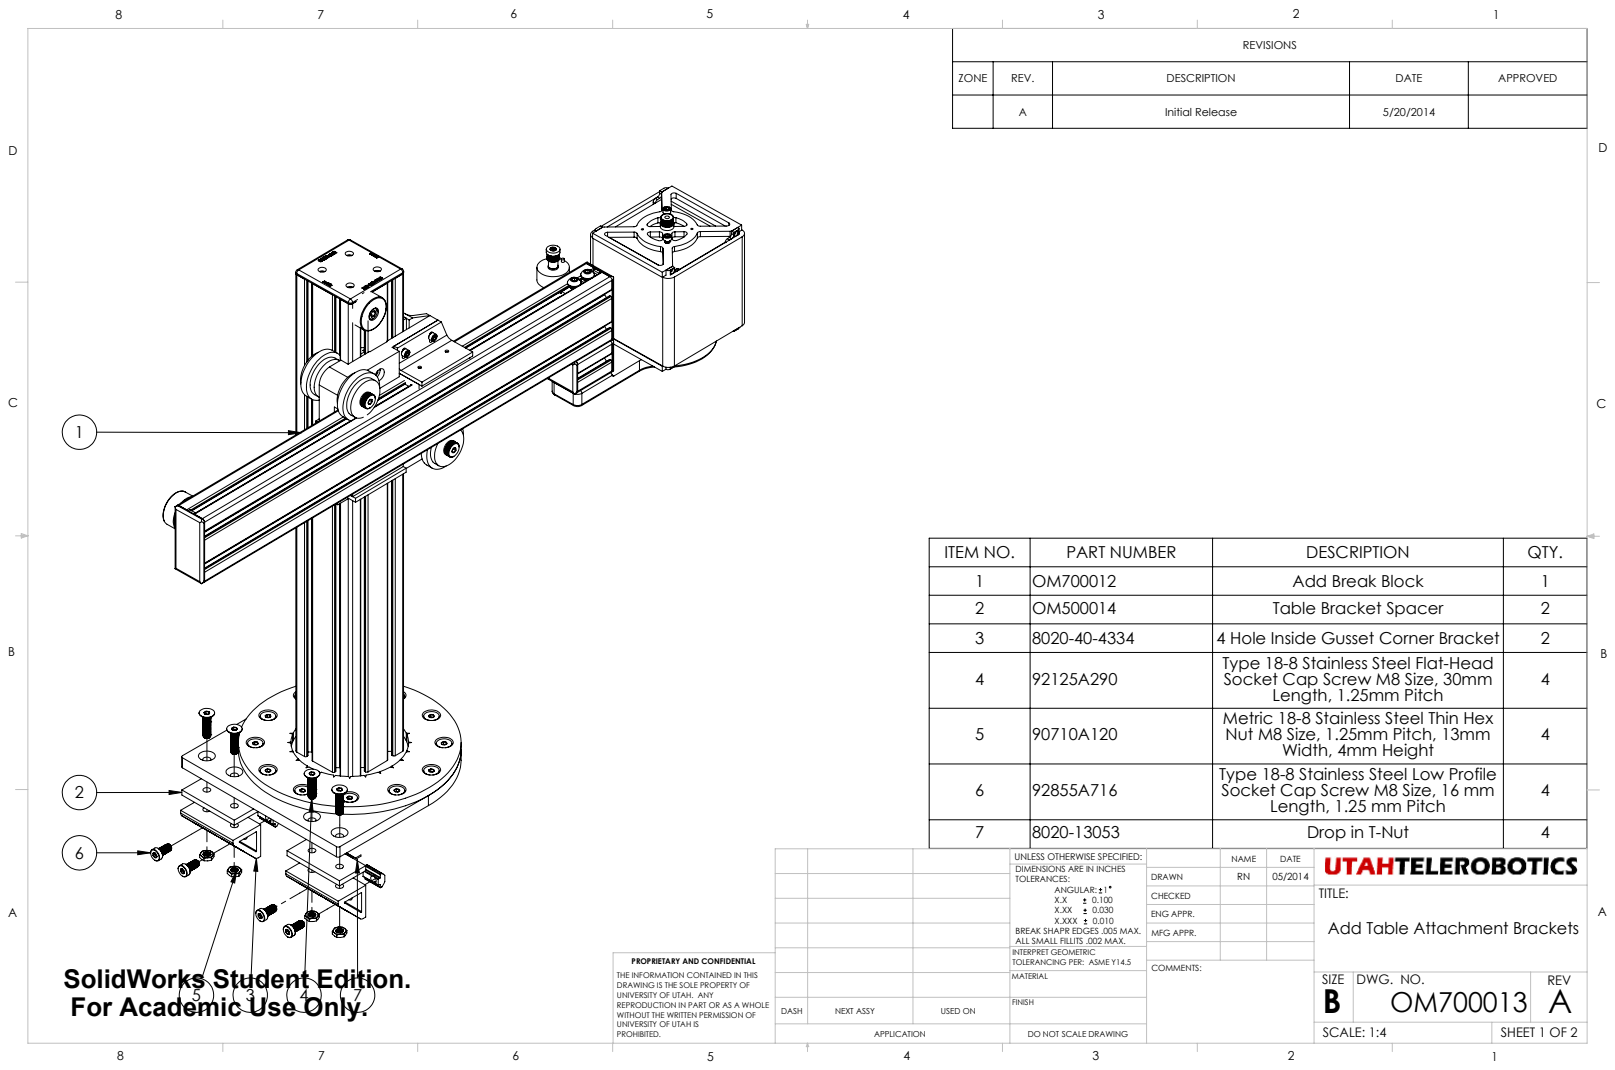
[picture p88: page 1]
NEXT ASSY; USED ON; ANGULAR: 1; ENG APPR.; DWG. NO.; REV; SCALE: 1:4; DO NOT SCALE DRAWING; SHEET 1 OF 2; MFG APPR.

ZONE | REV. | DESCRIPTION | DATE | APPROVED

A | Initial Release | 5/20/2014

ITEM NO. | PART NUMBER | DESCRIPTION | QTY.
1 | OM700012 | Add Break Block | 1
2 | OM500014 | Table Bracket Spacer | 2
3 | 8020-40-4334 | 4 Hole Inside Gusset Corner Bracket | 2
4 | 92125A290 | Type 18-8 Stainless Steel Flat-Head Socket Cap Screw M8 Size, 30mm Length, 1.25mm Pitch | 4

5 | 90710A120 | Metric 18-8 Stainless Steel Thin Hex Nut M8 Size, 1.25mm Pitch, 13mm Width, 4mm Height | 4

6 | 92855A716 | Type 18-8 Stainless Steel Low Profile Socket Cap Screw M8 Size, 16 mm Length, 1.25 mm Pitch | 4

7 | 8020-13053 | Drop in T-Nut | 4

UNLESS OTHERWISE SPECIFIED:
DIMENSIONS ARE IN INCHES
TOLERANCES:

TITLE:
Add Table Attachment Brackets

SolidWorks Student Edition.
For Academic Use Only.

BREAK SHAPR EDGES .005 MAX.
ALL SMALL FILLITS .002 MAX.
INTERPRET GEOMETRIC
TOLERANCING PER: ASME Y14.5
MATERIAL

PROPRIETARY AND CONFIDENTIAL
THE INFORMATION CONTAINED IN THIS
DRAWING IS THE SOLE PROPERTY OF
UNIVERSITY OF UTAH. ANY
REPRODUCTION IN PART OR AS A WHOLE
WITHOUT THE WRITTEN PERMISSION OF
UNIVERSITY OF UTAH IS
PROHIBITED.

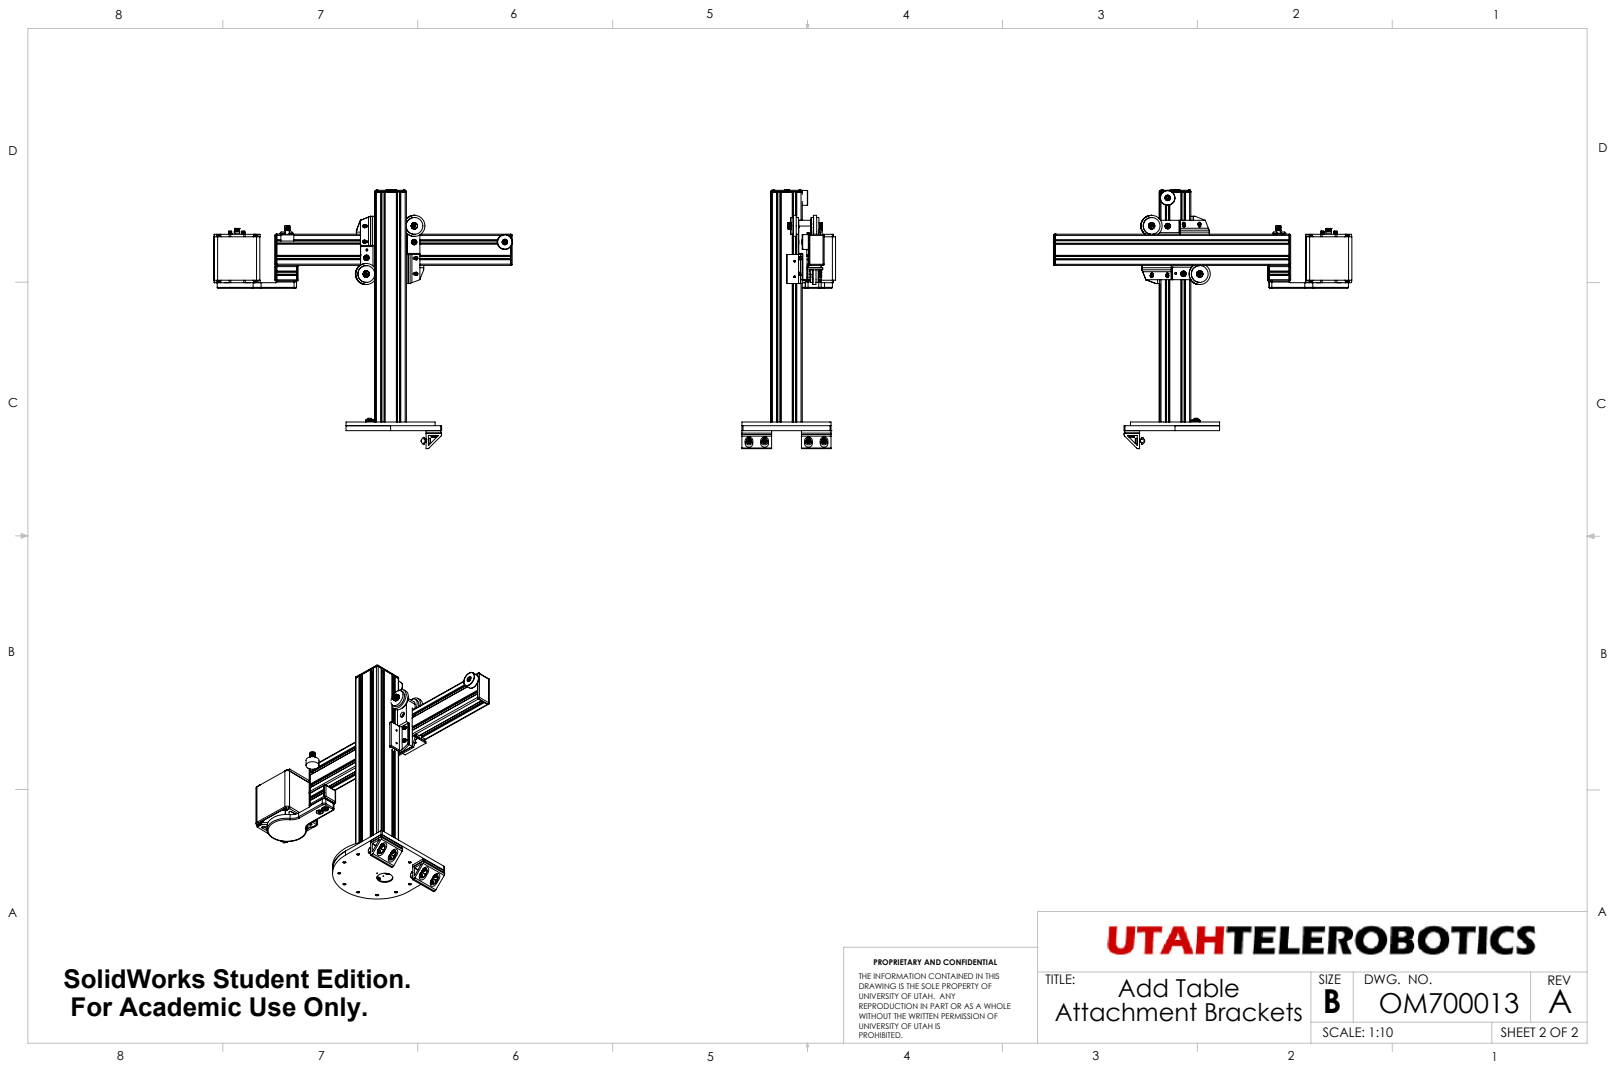
[picture p89: page 2]
DWG. NO.; REV; SCALE: 1:10; A Add Table Attachment Brackets; SHEET 2 OF 2

SolidWorks Student Edition.
For Academic Use Only.

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
