chazlambo/Omnimagnet/Solidworks/Arm Assembly/Parts to be Machined/OM500002 (Base Plate - Table).PDF

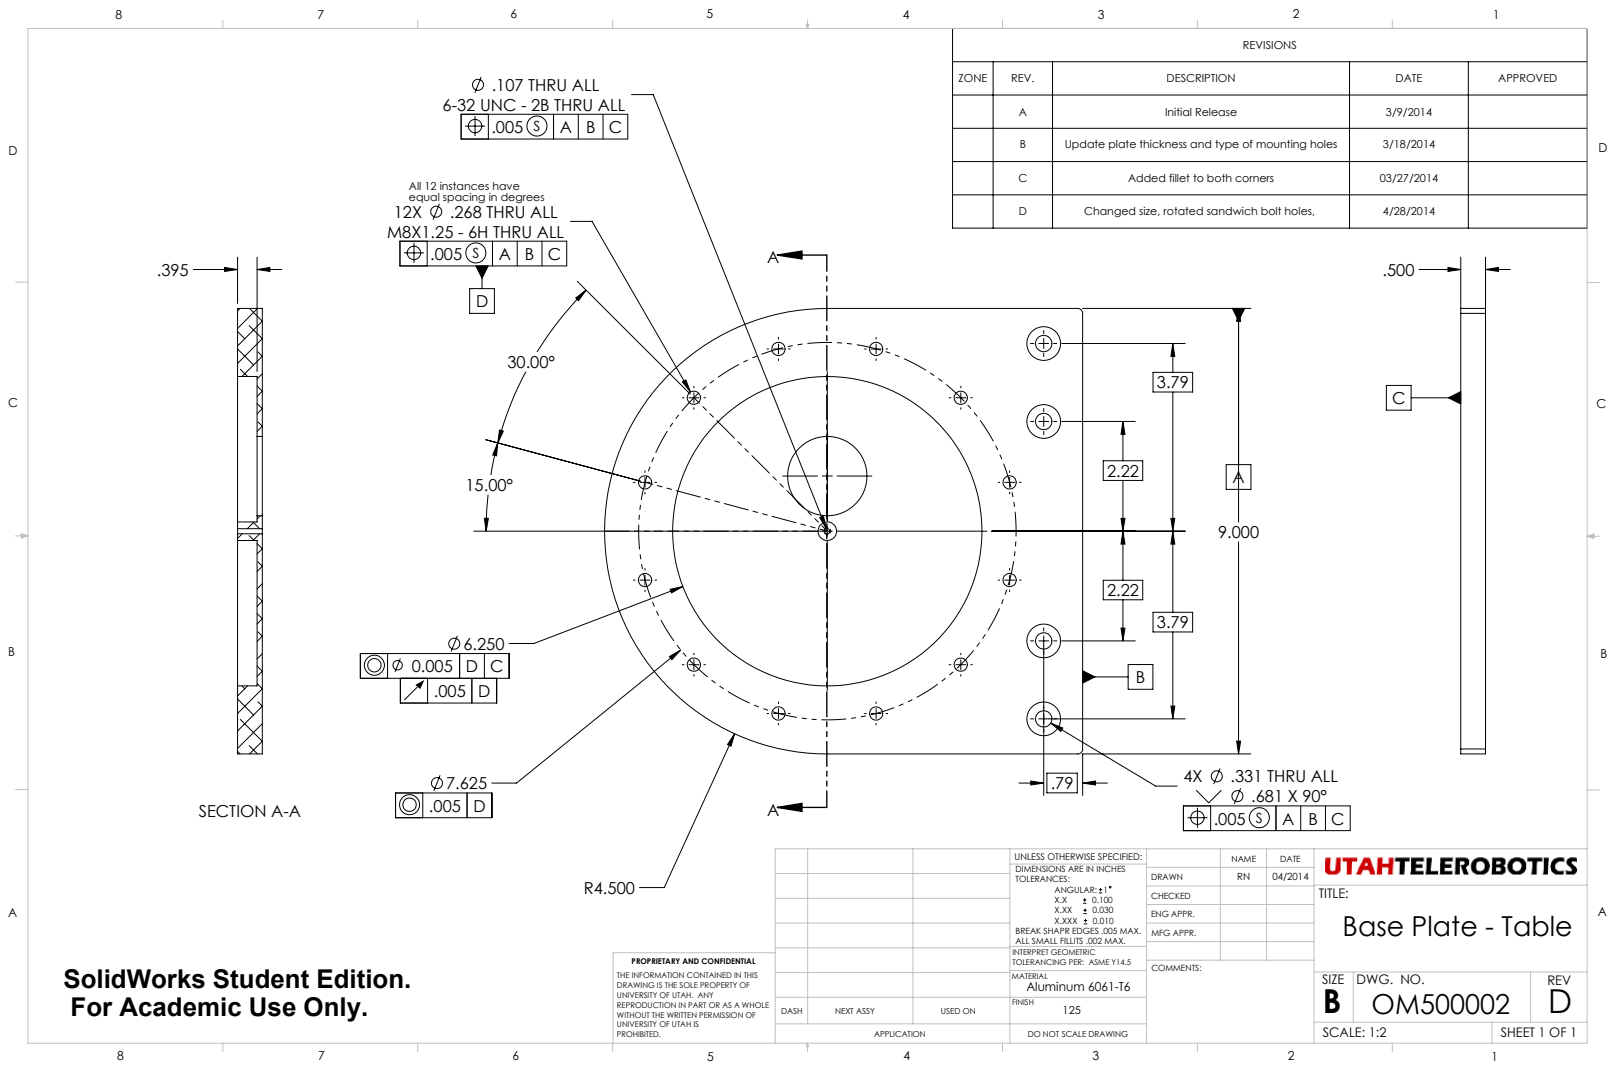
[picture p90: page 1]
.268 THRU ALL; .331 THRU ALL; SECTION A-A; NEXT ASSY; USED ON; ANGULAR: 1; ENG APPR.; DWG. NO.; REV; SCALE: 1:2; DO NOT SCALE DRAWING; SHEET 1 OF 1; MFG APPR.

.107 THRU ALL
6-32 UNC - 2B THRU ALL

ZONE | REV. | DESCRIPTION | DATE | APPROVED

A | Initial Release | 3/9/2014

B | Update plate thickness and type of mounting holes | 3/18/2014

C | Added fillet to both corners | 03/27/2014

All 12 instances have
equal spacing in degrees
M8X1.25 - 6H THRU ALL

D | Changed size, rotated sandwich bolt holes, | 4/28/2014

0.005 | D | C
.005 | D

UNLESS OTHERWISE SPECIFIED:
DIMENSIONS ARE IN INCHES
TOLERANCES:

Base Plate - Table

SolidWorks Student Edition.
For Academic Use Only.

BREAK SHAPR EDGES .005 MAX.
ALL SMALL FILLITS .002 MAX.
INTERPRET GEOMETRIC
TOLERANCING PER: ASME Y14.5
MATERIAL
Aluminum 6061-T6
FINISH

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
