chazlambo/Omnimagnet/Solidworks/Arm Assembly/Parts to be Machined/OM500016 (Threaded Pulley Plate).PDF

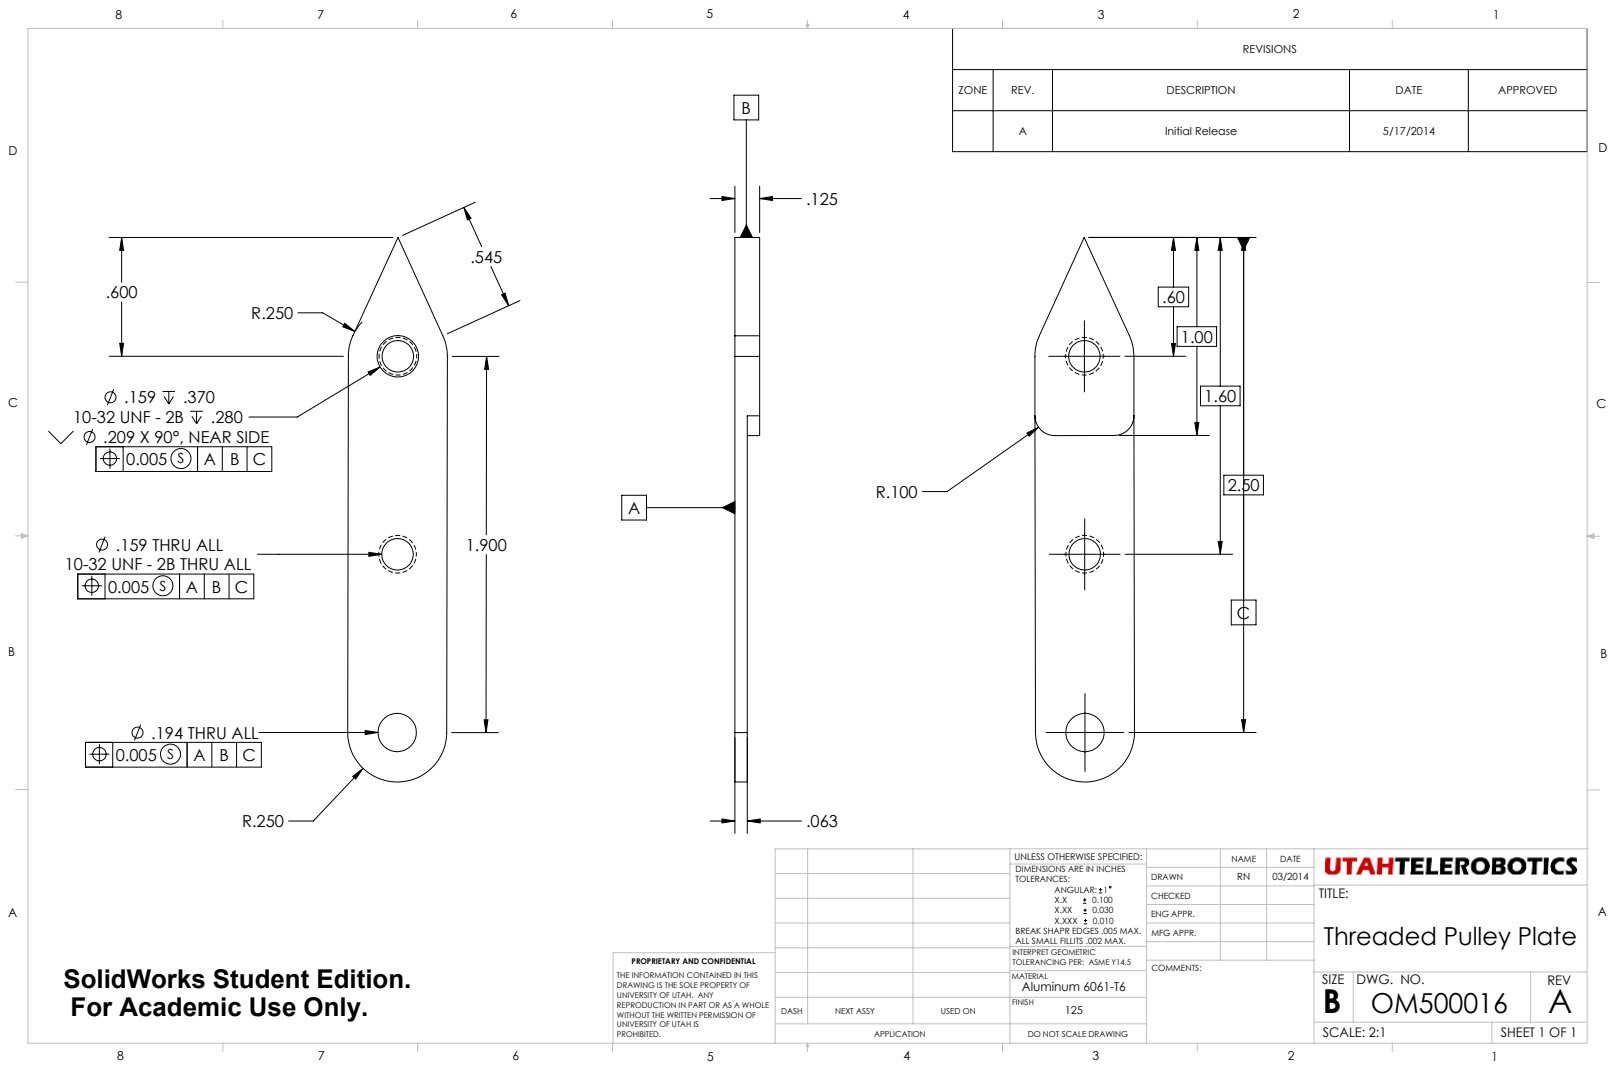
[picture p92: page 1]
.159 .370 10-32 UNF - 2B .280 .209 X 90°, NEAR SIDE; .194 THRU ALL; NEXT ASSY; USED ON; ANGULAR: 1; ENG APPR.; DWG. NO.; REV; SCALE: 2:1; DO NOT SCALE DRAWING; SHEET 1 OF 1; MFG APPR.

ZONE | REV. | DESCRIPTION | DATE | APPROVED

A | Initial Release | 5/17/2014

.159 THRU ALL
10-32 UNF - 2B THRU ALL

UNLESS OTHERWISE SPECIFIED:
DIMENSIONS ARE IN INCHES
TOLERANCES:

Threaded Pulley Plate

SolidWorks Student Edition.
For Academic Use Only.

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
