chazlambo/Omnimagnet/Solidworks/Arm Assembly/Parts to be Machined/OM500021 (Pad Bracket) LP.PDF

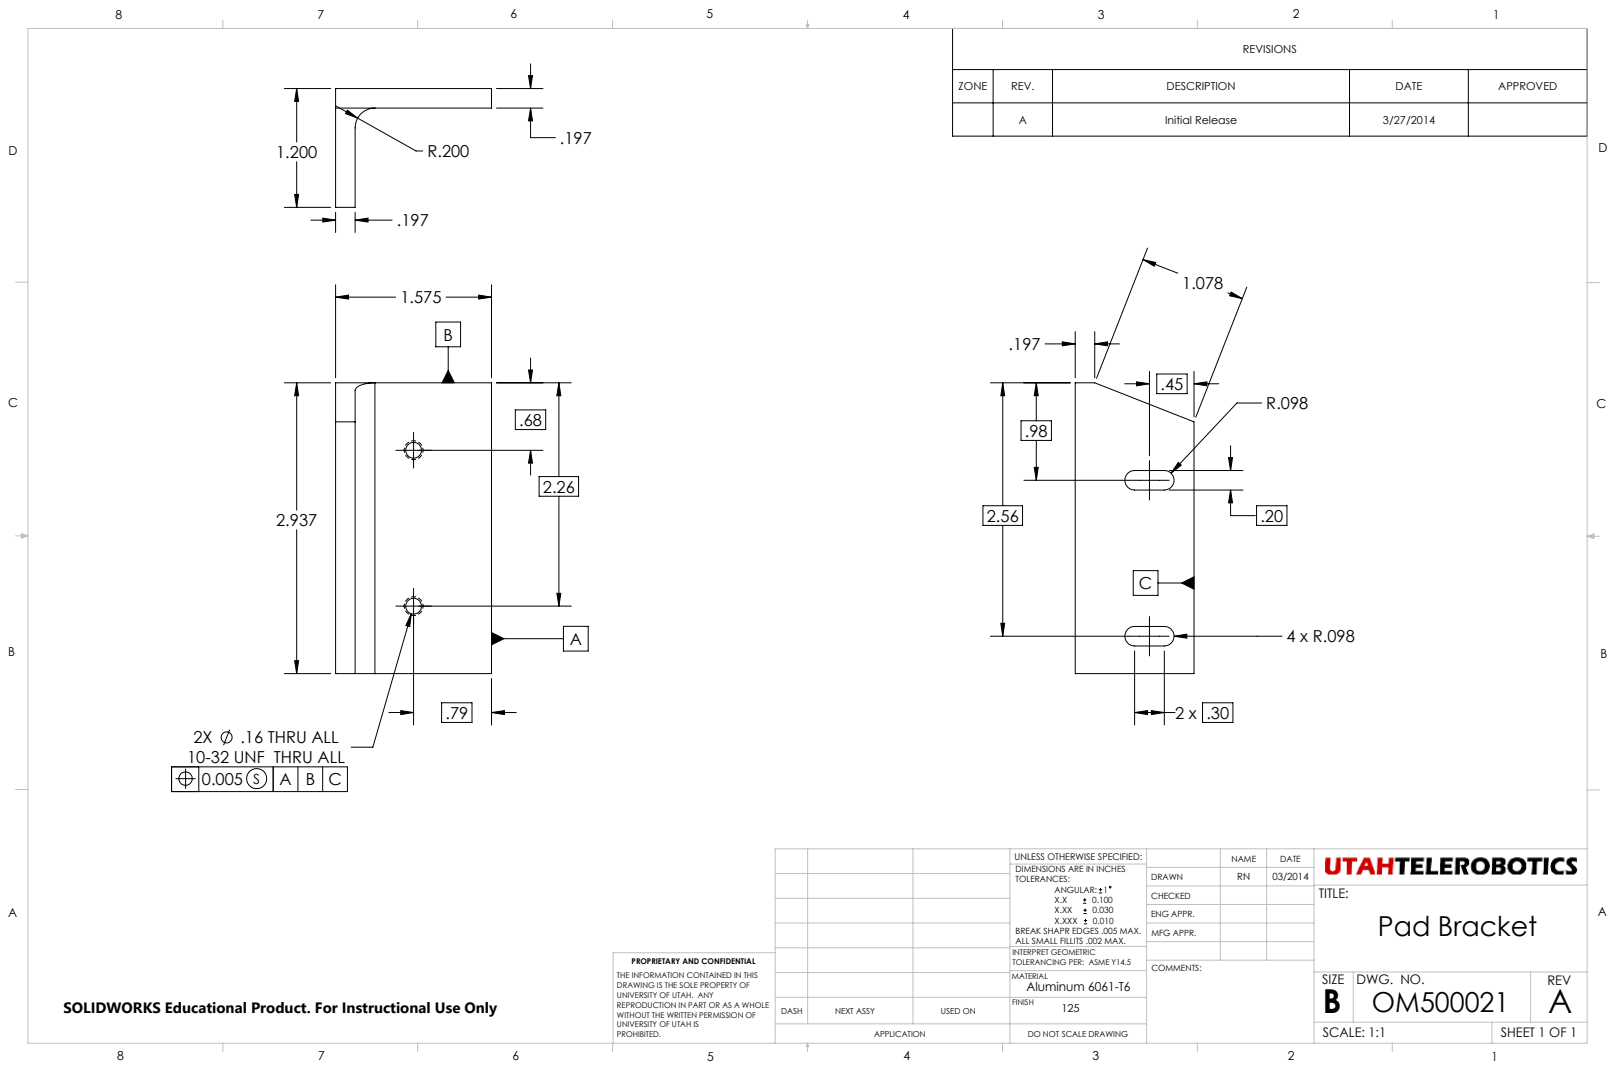
[picture p93: page 1]
.16 THRU ALL; NEXT ASSY; USED ON; ANGULAR: 1; ENG APPR.; DWG. NO.; REV; SCALE: 1:1; DO NOT SCALE DRAWING; SHEET 1 OF 1; MFG APPR.; Pad Bracket; SOLIDWORKS Educational Product. For Instructional Use Only

ZONE | REV. | DESCRIPTION | DATE | APPROVED

A | Initial Release | 3/27/2014

10-32 UNF THRU ALL

UNLESS OTHERWISE SPECIFIED:
DIMENSIONS ARE IN INCHES
TOLERANCES:

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
