chazlambo/Omnimagnet/Solidworks/Arm Assembly/Parts to be Machined/OM500020 (Linear Mating Plate).PDF

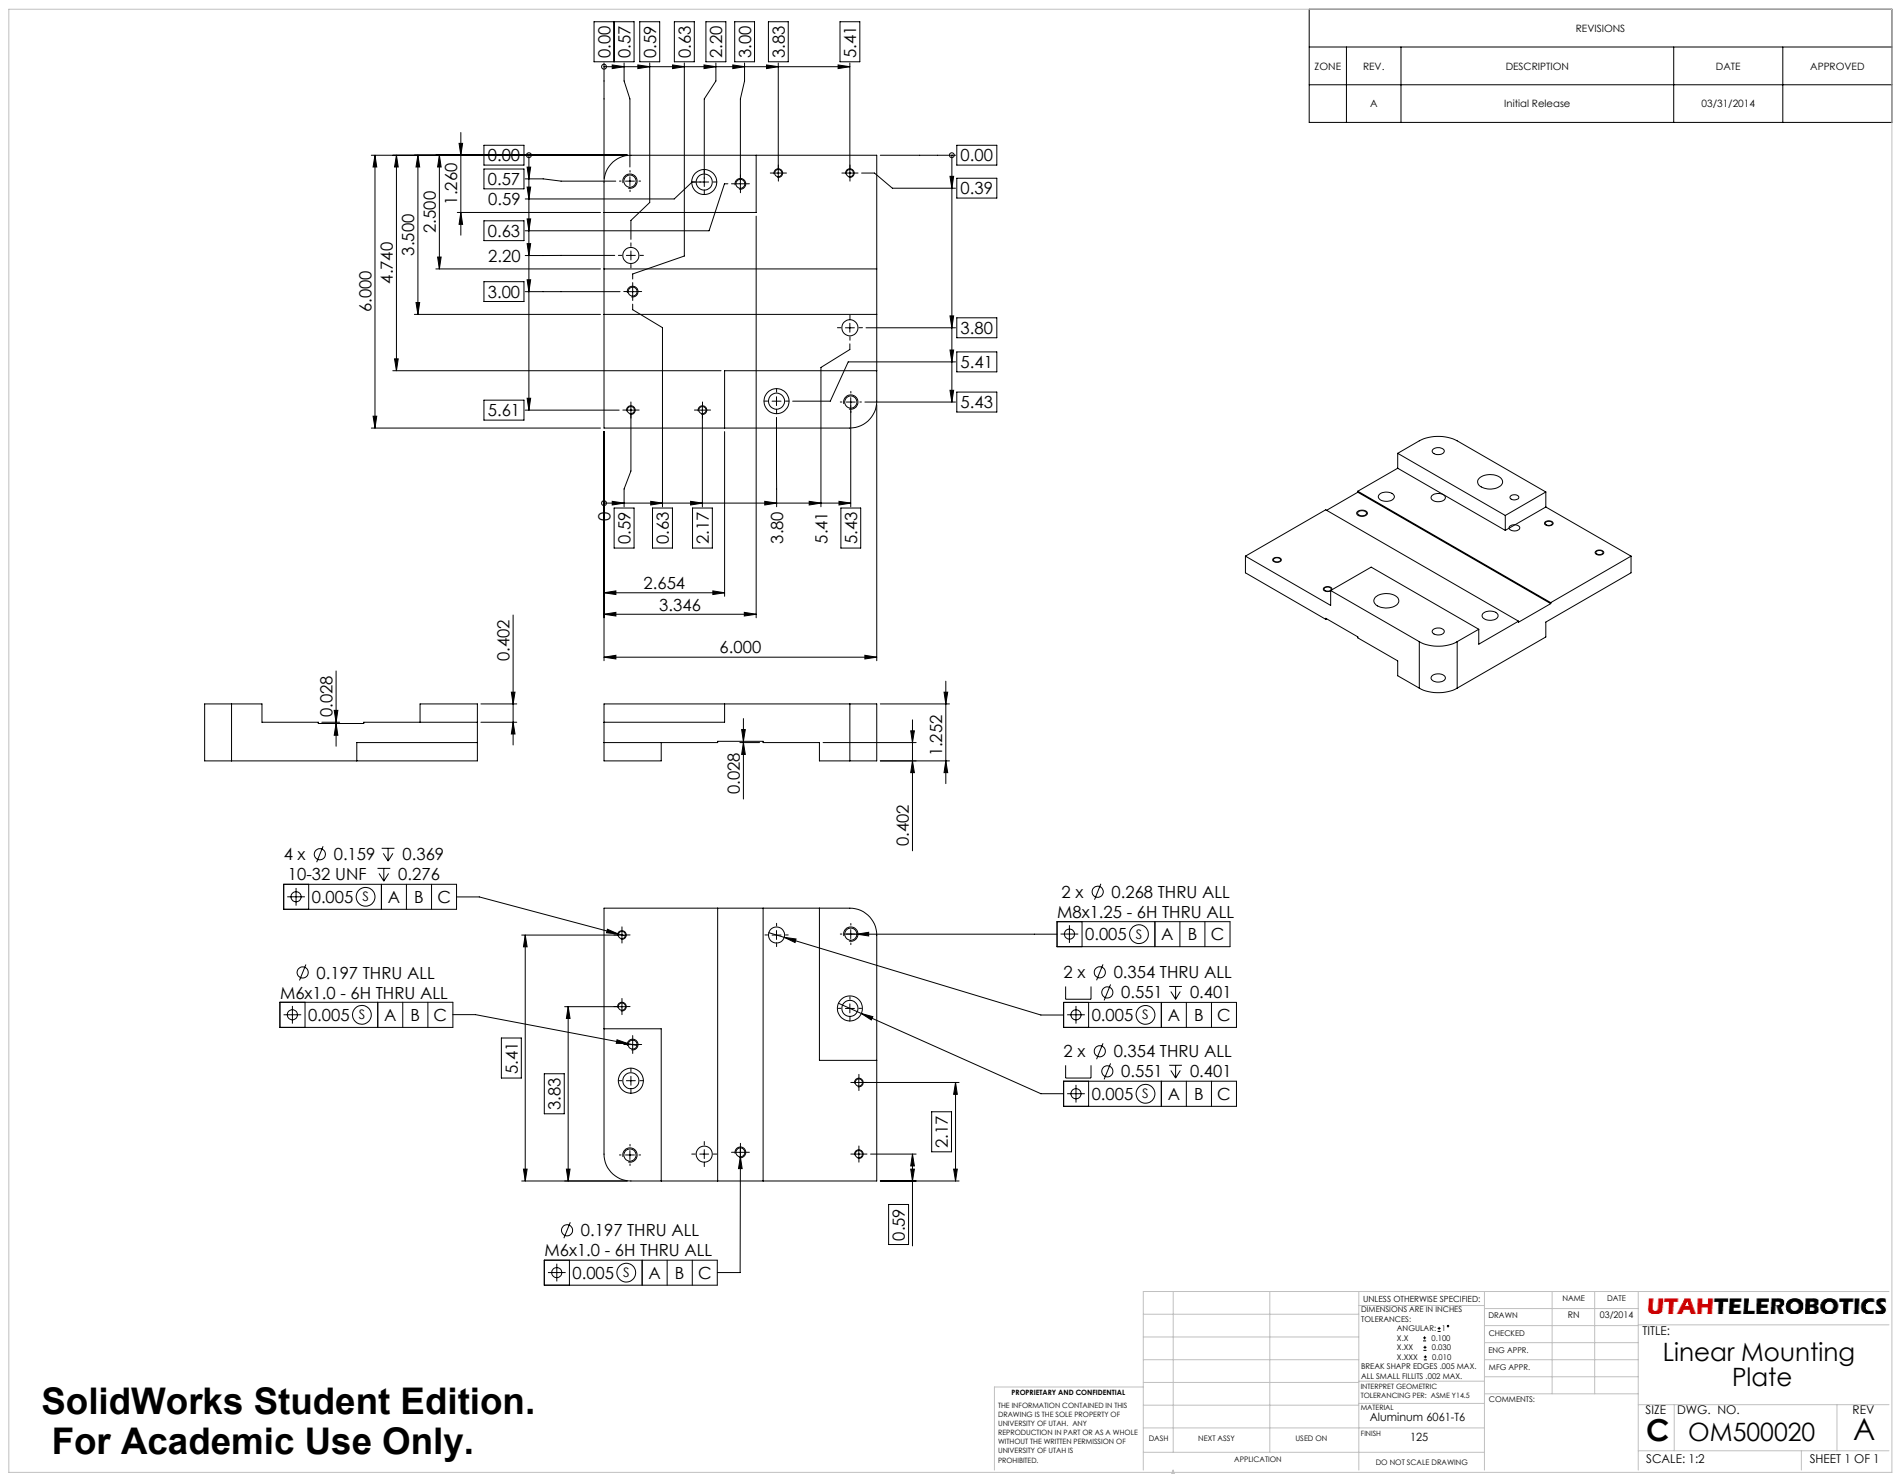
[picture p97: page 1]
10-32 UNF; 0.268 THRU ALL; M8x1.25 - 6H THRU ALL; 0.197 THRU ALL M6x1.0 - 6H THRU ALL; 0.354 THRU ALL; Linear Mounting; MFG APPR.; DO NOT SCALE DRAWING; SHEET 1 OF 1; SCALE: 1:2; DWG. NO.; REV; ENG APPR.; ANGULAR: 1; NEXT ASSY; USED ON

REVISIONS

ZONE | REV. | DESCRIPTION | DATE | APPROVED

A | Initial Release | 03/31/2014

UNLESS OTHERWISE SPECIFIED:
DIMENSIONS ARE IN INCHES
TOLERANCES:

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

SolidWorks Student Edition.
For Academic Use Only.

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
