chazlambo/Omnimagnet/(commit log)

2025-07-17 Added Tank Setup
    [Acrylic Cover - Left.DXF, Acrylic Cover - Left.SLDPRT, Acrylic Cover - Middle.DXF, Acrylic Cover - Middle.SLDPRT, Acrylic Cover - Right.DXF, Acrylic Cover - Right.SLDPRT, Acrylic Cover Template.SLDPRT, Acrylic Cover.SLDPRT]
2025-07-22 Replaced cameratrack with cameracapture
    [cameracapture.cpp, cameracapture.hpp, cameratrack.cpp, cameratrack.hpp, main.cpp]
2025-07-22 Camera working but distorted
2025-07-22 Recovered Camera Capture Code
2025-07-22 Added output directory
    [test_exp_01_image_log.csv]
2025-07-23 Started Calibration Steps
2025-07-23 Calibration images added
2025-07-23 Test Experiments 1-3
    [test_exp_02_image_log.csv, test_exp_03_image_log.csv, test_exp_04_image_log.csv]
2025-07-25 Experiments 7-25
    [experiment_A1_image_log.csv, experiment_A2_image_log.csv, experiment_B1_image_log.csv, experiment_C1_image_log.csv, experiment_C2_image_log.csv, experiment_C3_image_log.csv, experiment_D1_image_log.csv, experiment_E1_image_log.csv]
2025-07-29 Experiment F
    [experiment_F1_image_log.csv, experiment_F2_image_log.csv]
2025-07-29 Added full timelapse generation, tracking, and readmes, removed intermediary images
    [Experiment List.xlsx]
2025-07-29 Updated to initialize camera to color images
2025-07-29 Experiments G
    [experiment_F3_image_log.csv, experiment_G1_image_log.csv, experiment_G2_image_log.csv]
2025-07-29 Removed F1, F2 for quality issues
    [experiment_F1_image_log.csv, experiment_F2_image_log.csv]
2025-08-06 Added gitignores, updated experiment list
    [Experiment List.xlsx]
2025-08-06 Experiments D2 and D3
    [experiment_D2_image_log.csv, experiment_D3_image_log.csv]
2025-08-07 Experiments H1, H2, H3, E3
    [experiment_E3_image_log.csv, experiment_H1_image_log.csv, experiment_H2_image_log.csv, experiment_H3_image_log.csv]
2025-08-07 Minor Experiment List Updates
    [Experiment List.xlsx]
2025-08-07 Experiments F1, F2, G3
    [experiment_F1_image_log.csv, experiment_F2_image_log.csv, experiment_G3_image_log.csv]
2025-08-07 Generated Videos for H1, H2, H3, E3
    [Experiment List.xlsx]
2025-08-07 Generated F1, F2, G3 videos
    [Experiment List.xlsx]
2025-08-08 Experiments A3, B2, B3
    [experiment_A3_image_log.csv, experiment_B2_image_log.csv, experiment_B3_image_log.csv]
2025-08-08 Starting to test initial conditions
    [initialconditions_I1_image_log.csv]
2025-08-11 Initial Conditions Testing I2, I3
    [initialconditions_I2_image_log.csv, initialconditions_I3_image_log.csv]
2025-09-10 Initial Conditions Testing I5, I6
    [initialconditions_I5_image_log.csv, initialconditions_I6_image_log.csv]
2025-09-10 New 3-piece raft alignment design
    [Acrylic Cover - Left - 6-5.DXF, Acrylic Cover - Left.DXF, Acrylic Cover - Left.SLDPRT, Acrylic Cover - Middle 6-5.DXF, Acrylic Cover - Middle.DXF, Acrylic Cover - Middle.SLDPRT, Acrylic Cover - Right 6-5.DXF, Acrylic Cover - Right.DXF]
2025-09-15 Initial Conditions Testing I7, I8
    [initialconditions_I7_image_log.csv, initialconditions_I8_image_log.csv]
2025-09-15 Added Raft Spacers
    [Aligner Assembly.SLDASM, Raft Aligner Spacer.SLDPRT, Raft Aligner Spacer.STL]
2025-09-23 Remove cached solidworks files from repo
    [Aligner Assembly.SLDASM]
2025-10-14 Experiments C4, C5, C6
    [experiment_C4_image_log.csv, experiment_C5_image_log.csv, experiment_C6_image_log.csv]
2025-10-15 Experiments H4, H5, H6
    [experiment_H4_image_log.csv, experiment_H5_image_log.csv, experiment_H6_image_log.csv]
2025-10-15 Videos for experiments C4-C6, H4-H6
    [Experiment List.xlsx]
2025-10-16 Experiments D4-D6
    [experiment_D4_image_log.csv, experiment_D5_image_log.csv, experiment_D6_image_log.csv]
2025-10-20 D4-D6 videos
    [Experiment List.xlsx]
2025-10-20 Experiments E4-E6
    [experiment_E4_image_log.csv, experiment_E5_image_log.csv, experiment_E6_image_log.csv]
2025-10-20 Videos for E4-E6
    [Experiment List.xlsx]
2025-10-20 Added experiment data
    [Aligner Assembly.SLDASM, Experiment List.xlsx, Tank Full Setup.SLDASM]
2025-10-20 Update Experiment List.xlsx
    [Experiment List.xlsx]
2025-10-20 Experiments G4-G6
    [experiment_G4_image_log.csv, experiment_G5_image_log.csv, experiment_G6_image_log.csv]
2025-10-22 Experiments F4-F6
    [experiment_F4_image_log.csv, experiment_F5_image_log.csv, experiment_F6_image_log.csv]
2025-10-22 Videos for G4-G6
    [Experiment List.xlsx]
2025-10-24 Videos F4-F6
    [Experiment List.xlsx]
2025-11-04 Added Arm Assembly
    [OM500001 (Rotating Base Plate).SLDDRW, OM500001.sldprt, OM500002 (Base Plate - Table).SLDDRW, OM500002.SLDPRT, OM500003 (Top Base Plate).SLDDRW, OM500003.sldprt, OM500004 (Holding Plate).SLDDRW, OM500004.SLDPRT]
